dlutz52/lutzcraft-kicad-symbols/README.md

# lutzcraft-kicad-symbols
Where I keep my symbols and footprints used in KiCad
