dlutz52/lutzcraft-kicad-symbols/3dmodels/SRP4020TA-3R3M.step

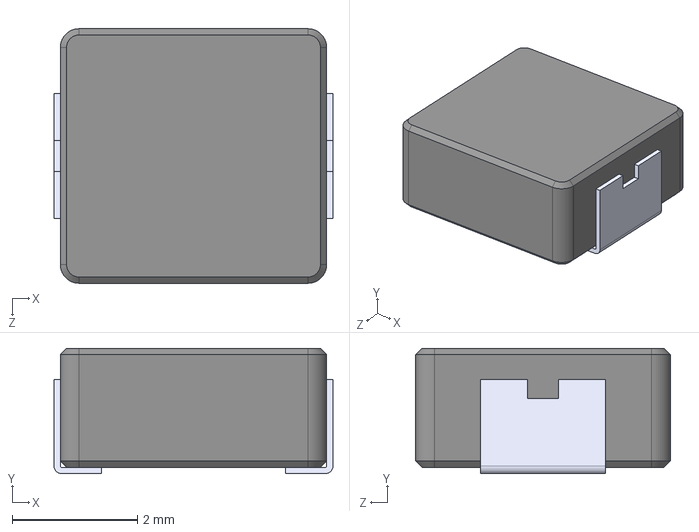
[picture p1: CAD file, 2026-05-27]
3dmodels/SRP4020TA-3R3M.step
4.45 x 2.00 x 4.06 mm
