dlutz52/lutzcraft-kicad-symbols/3dmodels/U262-161N-4BVC11.stp

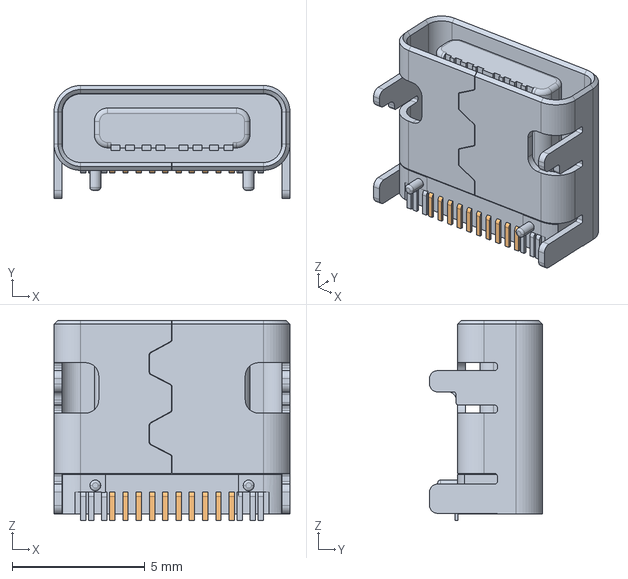
[picture p2: CAD file, 2026-05-27]
3dmodels/U262-161N-4BVC11.stp
8.90 x 4.26 x 7.56 mm
