dlutz52/lutzcraft-kicad-symbols/3dmodels/ESP32-WROOM-32E.STEP

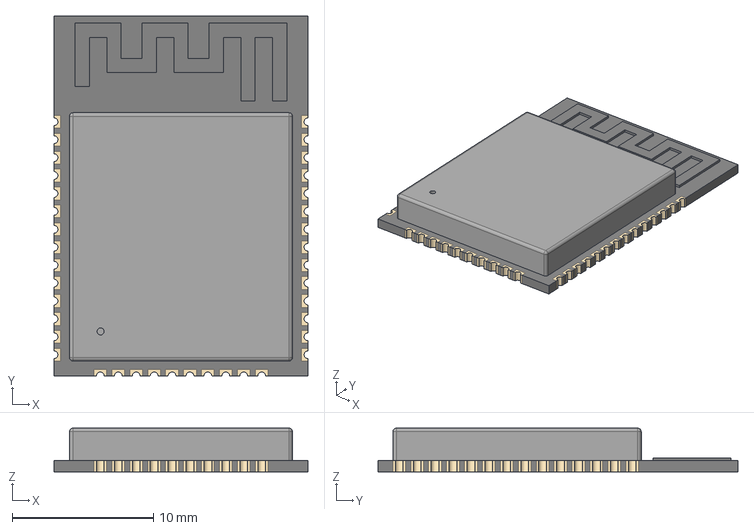
[picture p3: CAD file, 2026-02-02]
3dmodels/ESP32-WROOM-32E.STEP
18.0 x 25.5 x 3.10 mm
