dlutz52/lutzcraft-kicad-symbols/3dmodels/ESP32-WROOM-32U.step

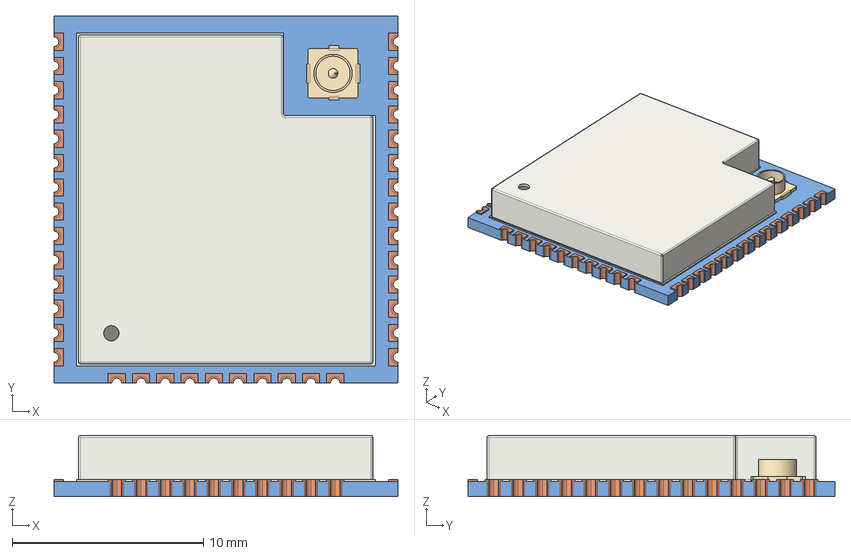
[picture p4: CAD file, 2026-02-02]
3dmodels/ESP32-WROOM-32U.step
18.0 x 19.2 x 3.20 mm
