dlutz52/lutzcraft-kicad-symbols/3dmodels/IS62WV51216BLL-55TLI_ISI.step

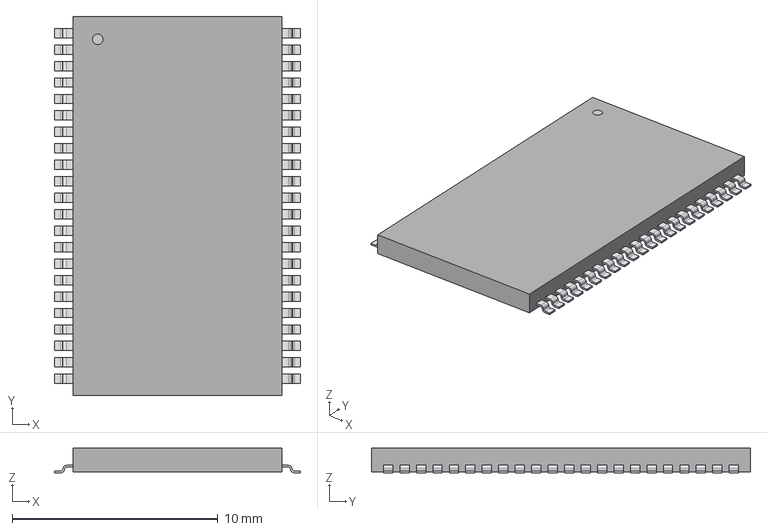
[picture p5: CAD file, 2026-01-31]
3dmodels/IS62WV51216BLL-55TLI_ISI.step
12.0 x 18.4 x 1.20 mm
