dlutz52/lutzcraft-kicad-symbols/3dmodels/DM3AT-SF-PEJM5.STEP

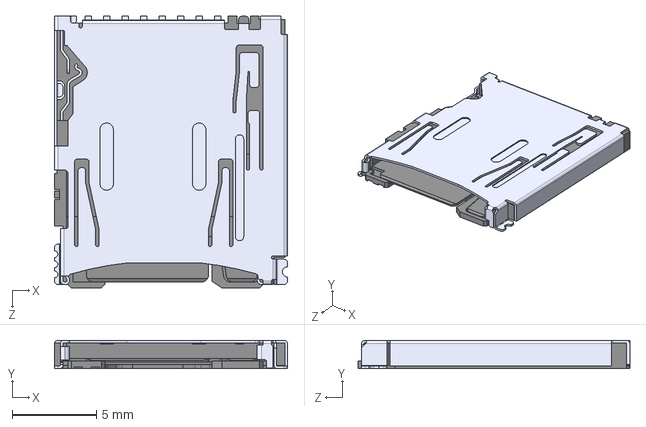
[picture p6: CAD file, 2026-01-31]
3dmodels/DM3AT-SF-PEJM5.STEP
13.8 x 1.68 x 16.2 mm
