dlutz52/lutzcraft-kicad-symbols/3dmodels/S8411-45R.step

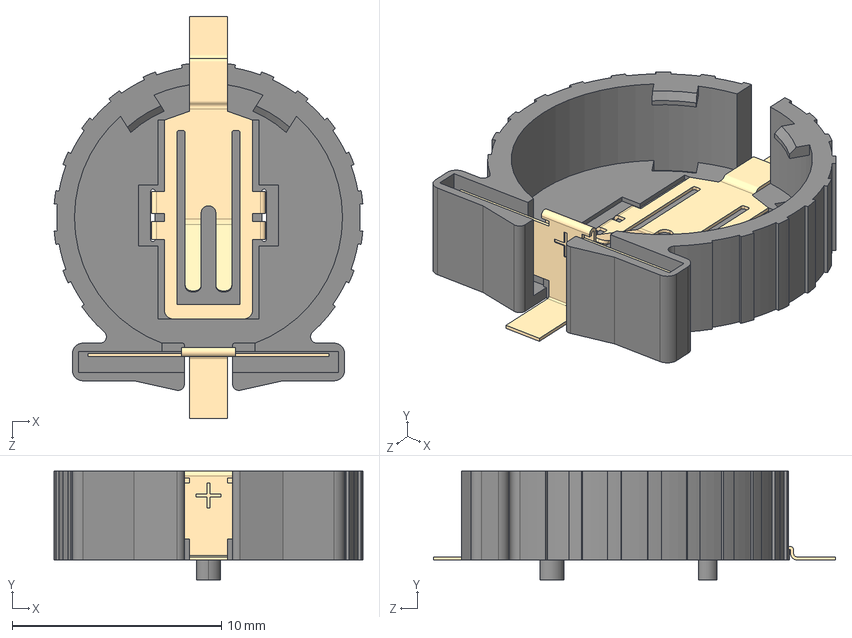
[picture p8: CAD file, 2026-01-31]
3dmodels/S8411-45R.step
14.7 x 5.20 x 19.2 mm
