dlutz52/lutzcraft-kicad-symbols/3dmodels/PinSocket_2x04_P2.54mm_Vertical.step

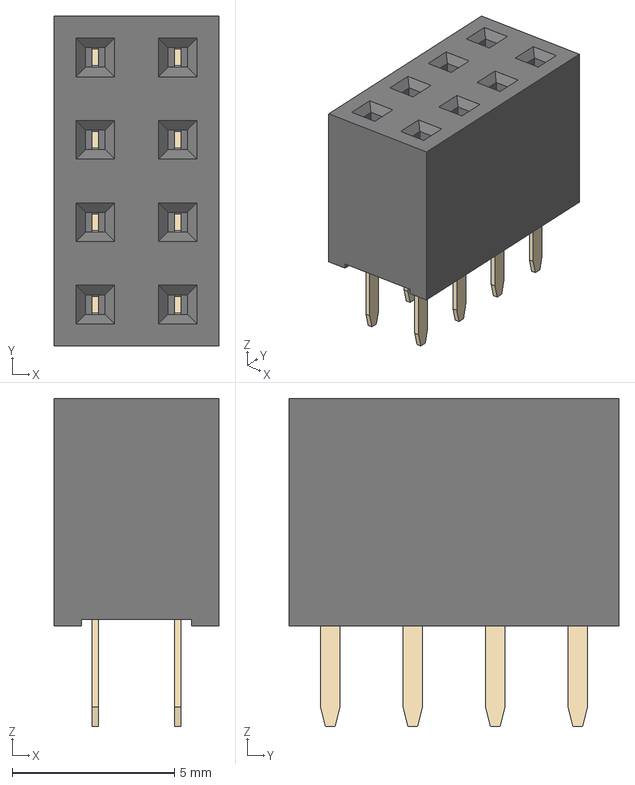
[picture p9: CAD file, 2026-01-31]
3dmodels/PinSocket_2x04_P2.54mm_Vertical.step
5.08 x 10.2 x 10.1 mm
