dlutz52/lutzcraft-kicad-symbols/3dmodels/STM32F407ZGT6.STEP

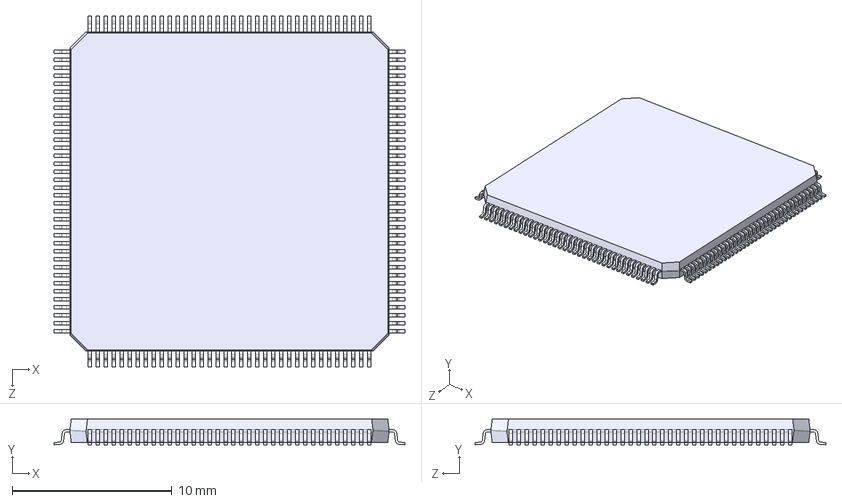
[picture p10: CAD file, 2026-01-31]
3dmodels/STM32F407ZGT6.STEP
22.0 x 1.60 x 22.0 mm
