dlutz52/lutzcraft-kicad-symbols/3dmodels/Wireless Radio Transmitter and Receiver nRF24L01.STEP

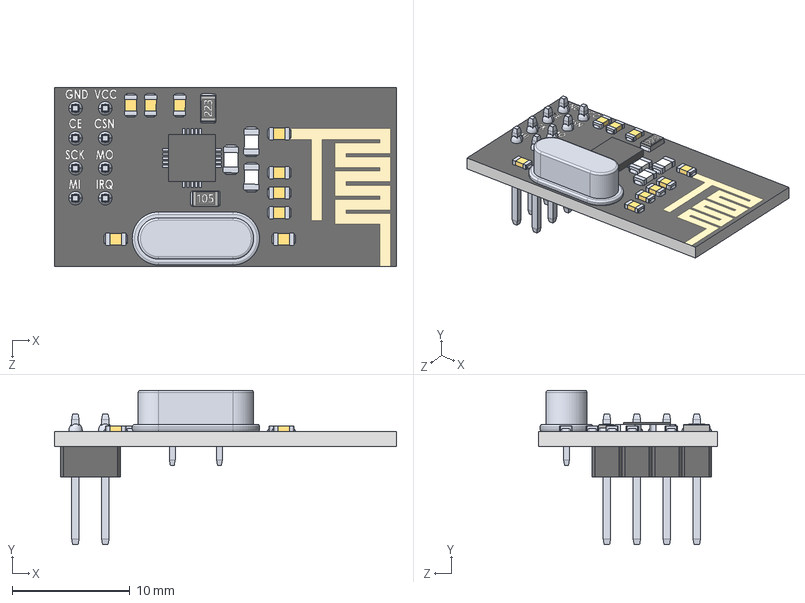
[picture p11: CAD file, 2026-01-31]
3dmodels/Wireless Radio Transmitter and Receiver nRF24L01.STEP
29.0 x 13.1 x 15.2 mm
nrfboard
CrystalOscillator
doubleMaleHeader x 4
solder x 8
1.7mmSmdCeramicCapacitor x 9
smdResistor223
smdResistor105
smdceramiccapacitorwhite x 3
4x4SMDchip
