dlutz52/lutzcraft-kicad-symbols/3dmodels/ABM8AIG-8.000MHZ-1Z-T.step

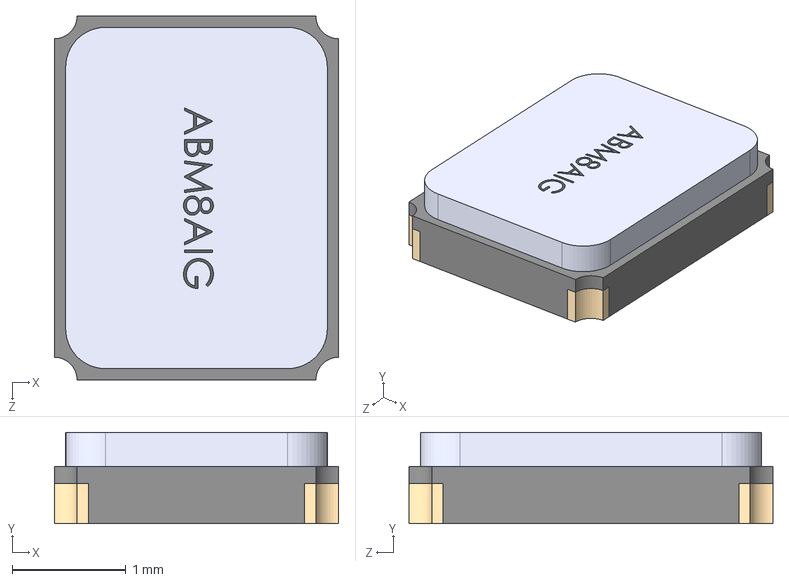
[picture p12: CAD file, 2026-01-31]
3dmodels/ABM8AIG-8.000MHZ-1Z-T.step
2.50 x 0.801 x 3.20 mm
