dlutz52/lutzcraft-kicad-symbols/3dmodels/8M20P2_49US.stp

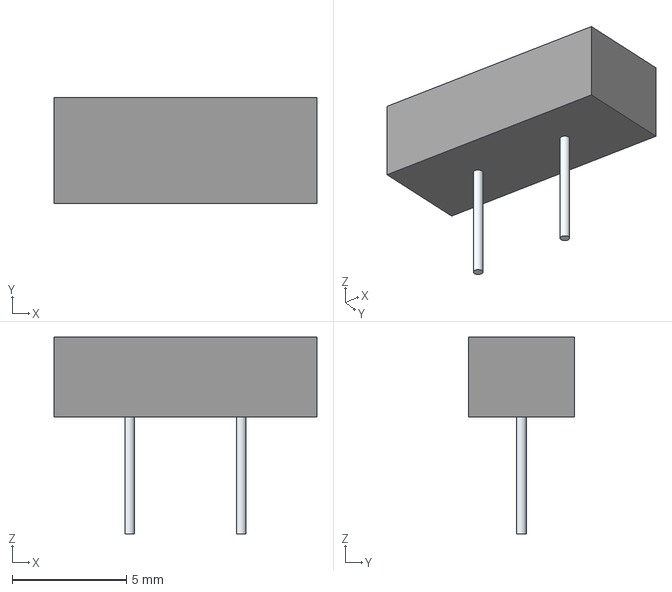
[picture p13: CAD file, 2026-01-31]
3dmodels/8M20P2_49US.stp
11.5 x 4.65 x 8.60 mm
Leads
