dlutz52/lutzcraft-kicad-symbols/3dmodels/USB_C_Receptacle_HRO_TYPE-C-31-M-12.STEP

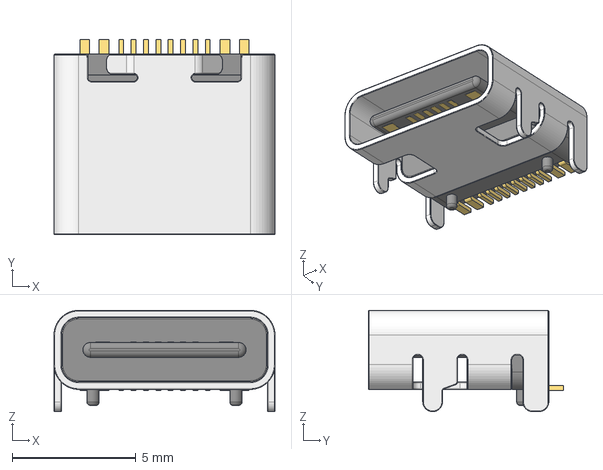
[picture p14: CAD file, 2026-01-31]
3dmodels/USB_C_Receptacle_HRO_TYPE-C-31-M-12.STEP
8.94 x 7.90 x 4.10 mm
