dlutz52/lutzcraft-kicad-symbols/3dmodels/TB002-500-03BE.step

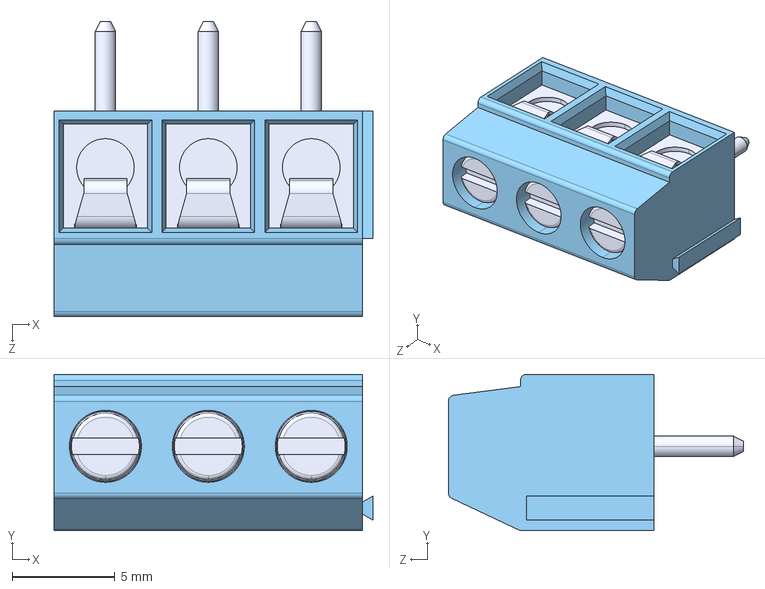
[picture p15: CAD file, 2025-12-26]
3dmodels/TB002-500-03BE.step
15.5 x 7.60 x 14.4 mm
