dlutz52/lutzcraft-kicad-symbols/3dmodels/IST8310.step

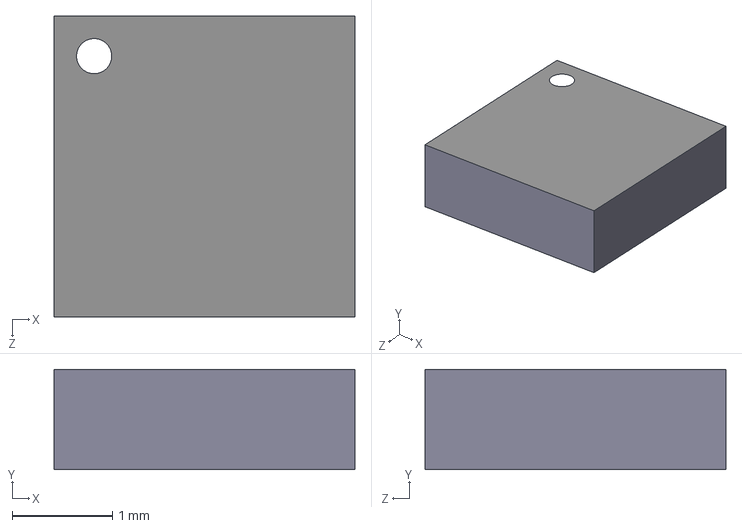
[picture p16: CAD file, 2025-11-05]
3dmodels/IST8310.step
3.00 x 1.00 x 3.00 mm
