dlutz52/lutzcraft-kicad-symbols/3dmodels/BMI270_BOS.step

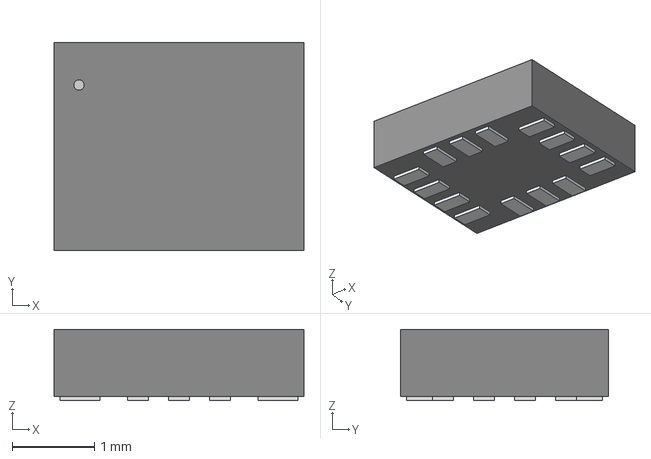
[picture p17: CAD file, 2025-10-31]
3dmodels/BMI270_BOS.step
3.05 x 2.54 x 0.866 mm
