dlutz52/lutzcraft-kicad-symbols/3dmodels/LGA20_2p5X3X0p95_BOS.step

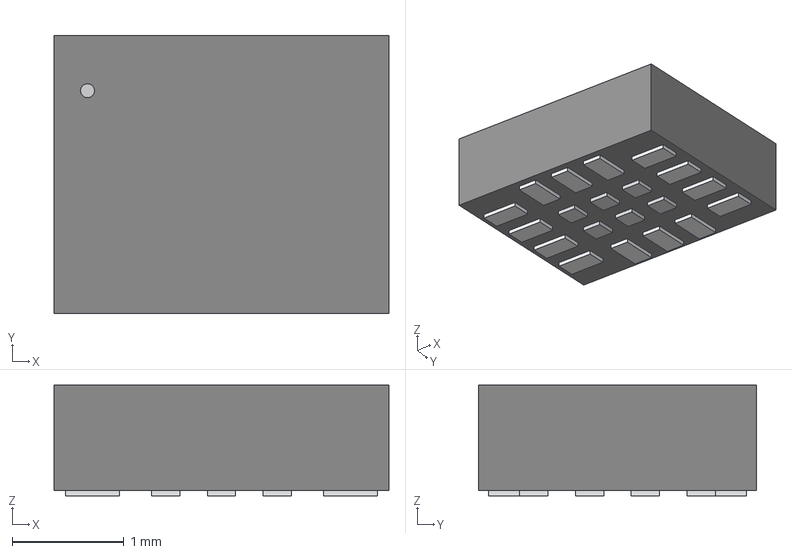
[picture p18: CAD file, 2025-10-31]
3dmodels/LGA20_2p5X3X0p95_BOS.step
3.00 x 2.49 x 0.993 mm
