dlutz52/lutzcraft-kicad-symbols/3dmodels/BGA9_BMM350_BOS.step

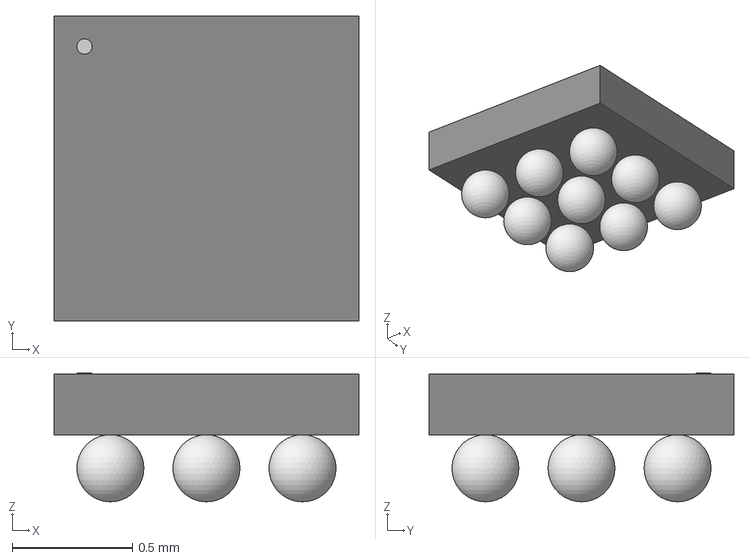
[picture p19: CAD file, 2025-10-31]
3dmodels/BGA9_BMM350_BOS.step
1.27 x 1.27 x 0.536 mm
