dlutz52/lutzcraft-kicad-symbols/3dmodels/BMI088.STEP

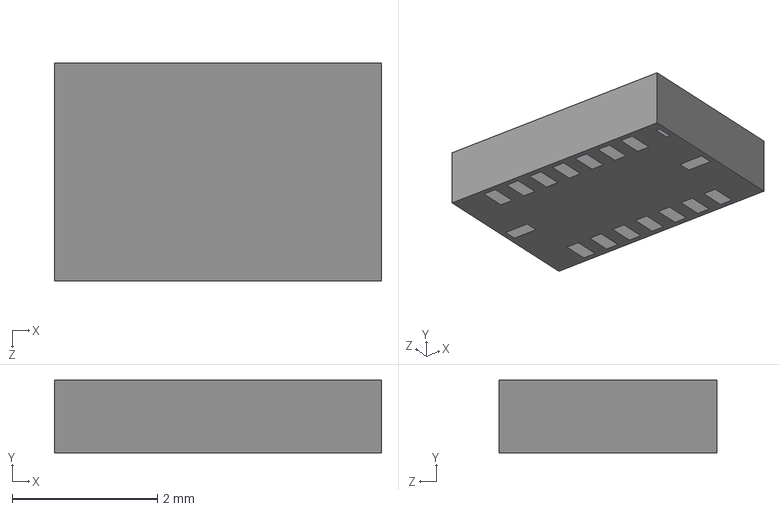
[picture p20: CAD file, 2025-10-31]
3dmodels/BMI088.STEP
4.50 x 1.00 x 3.00 mm
