dlutz52/lutzcraft-kicad-symbols/3dmodels/BNO085.step

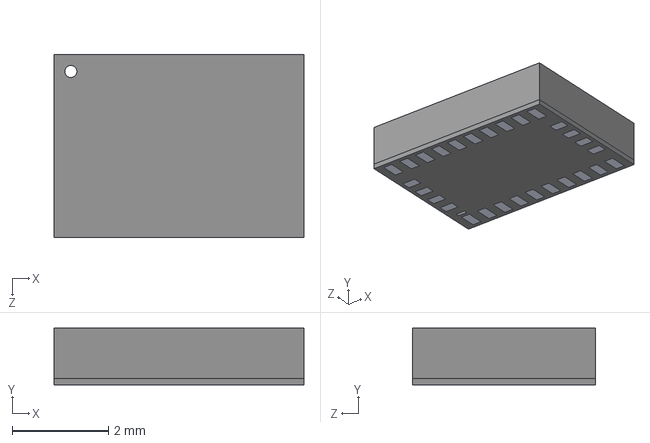
[picture p21: CAD file, 2025-10-31]
3dmodels/BNO085.step
5.20 x 1.18 x 3.80 mm
