dlutz52/lutzcraft-kicad-symbols/3dmodels/QFN24_3X3X0P9_IVS.step

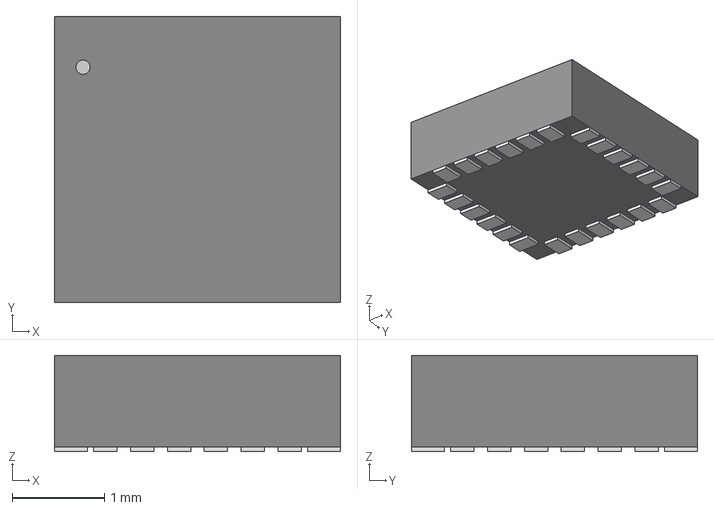
[picture p22: CAD file, 2025-10-31]
3dmodels/QFN24_3X3X0P9_IVS.step
3.10 x 3.10 x 1.04 mm
