dlutz52/lutzcraft-kicad-symbols/3dmodels/ICM-20948.step

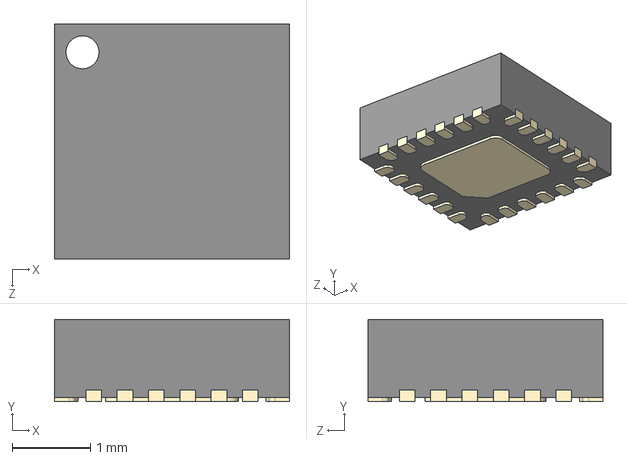
[picture p23: CAD file, 2025-10-31]
3dmodels/ICM-20948.step
3.00 x 1.05 x 3.00 mm
