dlutz52/lutzcraft-kicad-symbols/3dmodels/BMI270.STEP

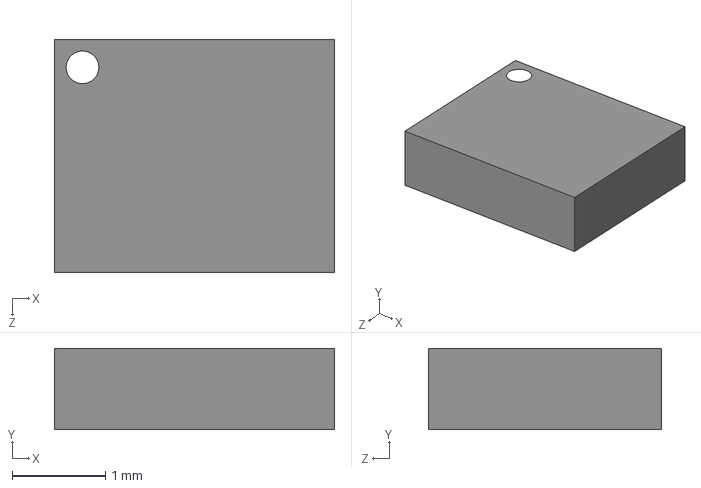
[picture p24: CAD file, 2025-10-31]
3dmodels/BMI270.STEP
3.00 x 0.87 x 2.50 mm
