dlutz52/lutzcraft-kicad-symbols/3dmodels/TB002-500-02BE.step

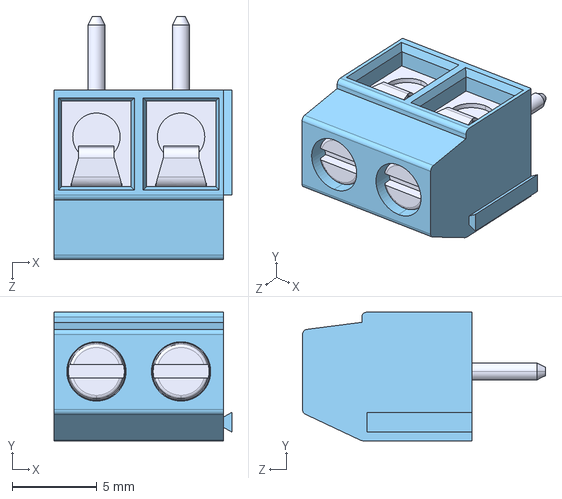
[picture p25: CAD file, 2025-10-18]
3dmodels/TB002-500-02BE.step
10.5 x 7.60 x 14.4 mm
