dlutz52/lutzcraft-kicad-symbols/3dmodels/User Library-DS1040-03 (DIP_switch).STEP

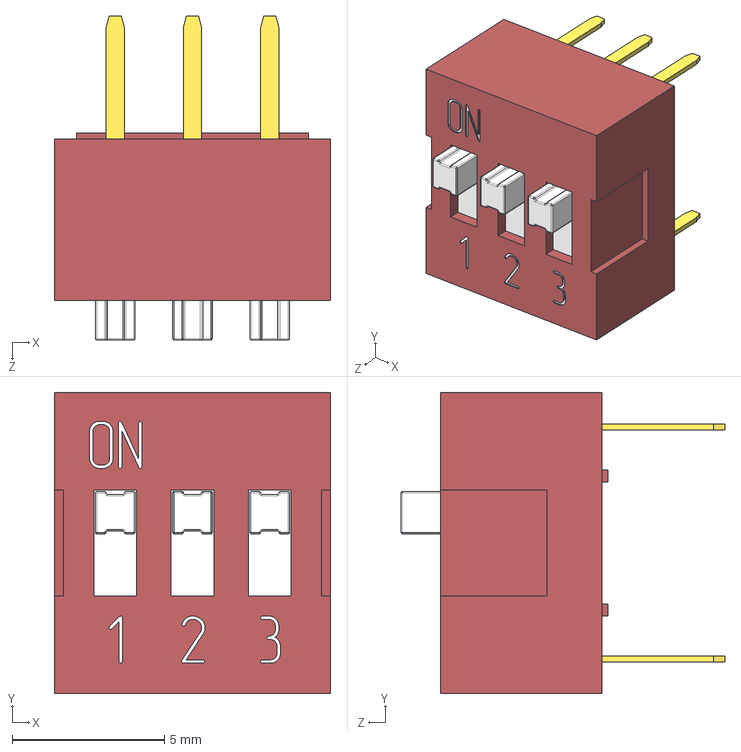
[picture p26: CAD file, 2025-10-08]
3dmodels/User Library-DS1040-03 (DIP_switch).STEP
9.08 x 9.90 x 10.7 mm
