dlutz52/lutzcraft-kicad-symbols/3dmodels/208-3.STEP

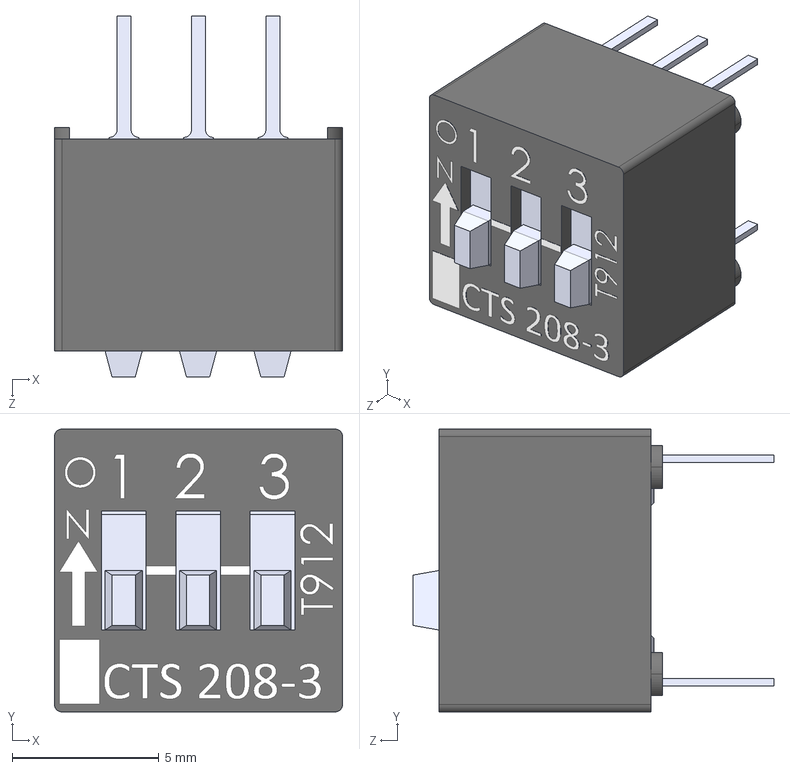
[picture p27: CAD file, 2025-10-08]
3dmodels/208-3.STEP
9.83 x 9.65 x 12.3 mm
206-40-063-40-01(for 208-3)
206-3 pole assembly
