dlutz52/lutzcraft-kicad-symbols/3dmodels/SOT-23-3.step

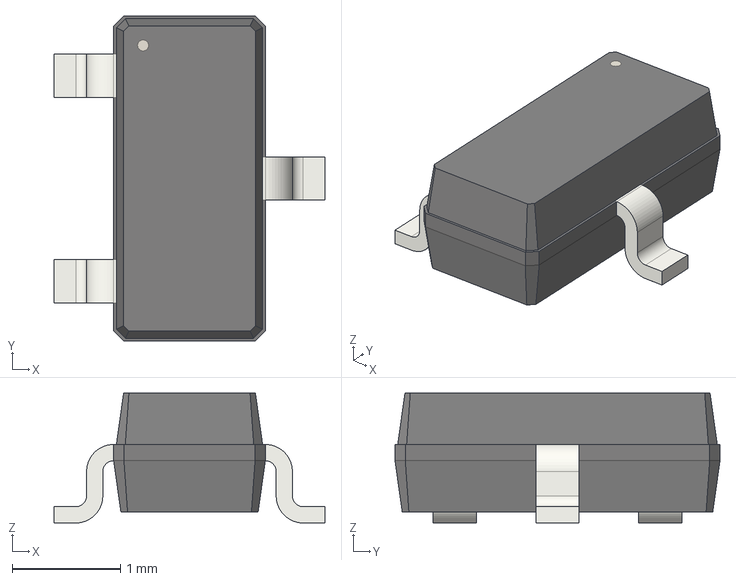
[picture p28: CAD file, 2025-07-09]
3dmodels/SOT-23-3.step
2.50 x 3.00 x 1.20 mm
