dlutz52/lutzcraft-kicad-symbols/3dmodels/W25Q32JVSSIQ.step

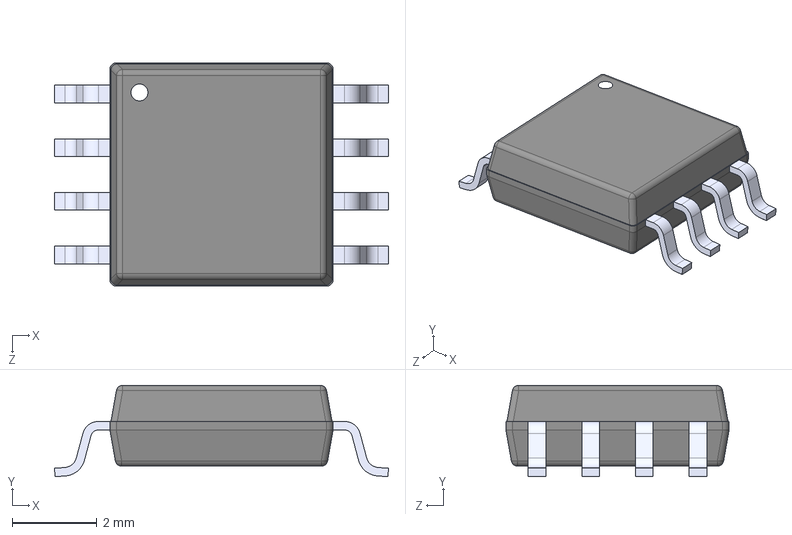
[picture p29: CAD file, 2025-07-09]
3dmodels/W25Q32JVSSIQ.step
7.90 x 2.16 x 5.28 mm
