dlutz52/lutzcraft-kicad-symbols/3dmodels/BME280.step

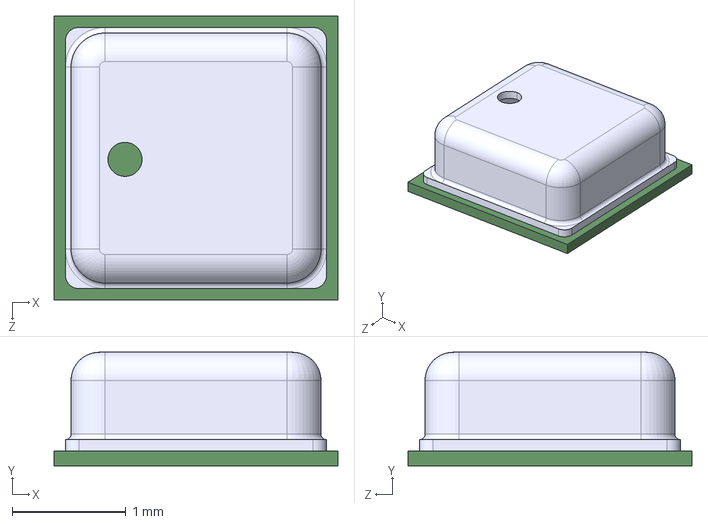
[picture p30: CAD file, 2025-07-09]
3dmodels/BME280.step
2.50 x 1.00 x 2.50 mm
