dlutz52/lutzcraft-kicad-symbols/3dmodels/B2B-PH-SM4-TB.step

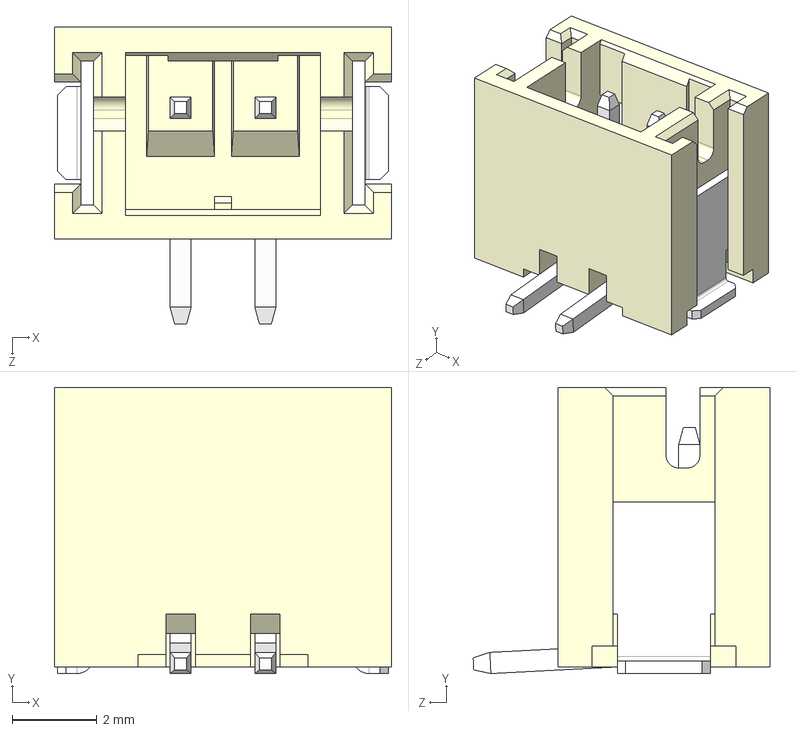
[picture p31: CAD file, 2025-07-09]
3dmodels/B2B-PH-SM4-TB.step
7.95 x 6.75 x 7.00 mm
