dlutz52/lutzcraft-kicad-symbols/3dmodels/LM1117MPX-3.3.step

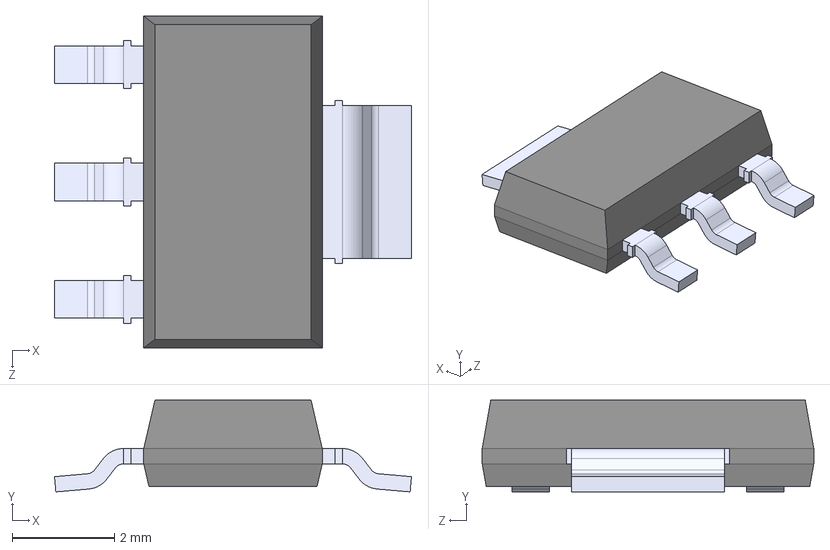
[picture p32: CAD file, 2025-07-09]
3dmodels/LM1117MPX-3.3.step
7.00 x 1.80 x 6.50 mm
