dlutz52/lutzcraft-kicad-symbols/3dmodels/B4B-XH-AM__LF__SN_.step

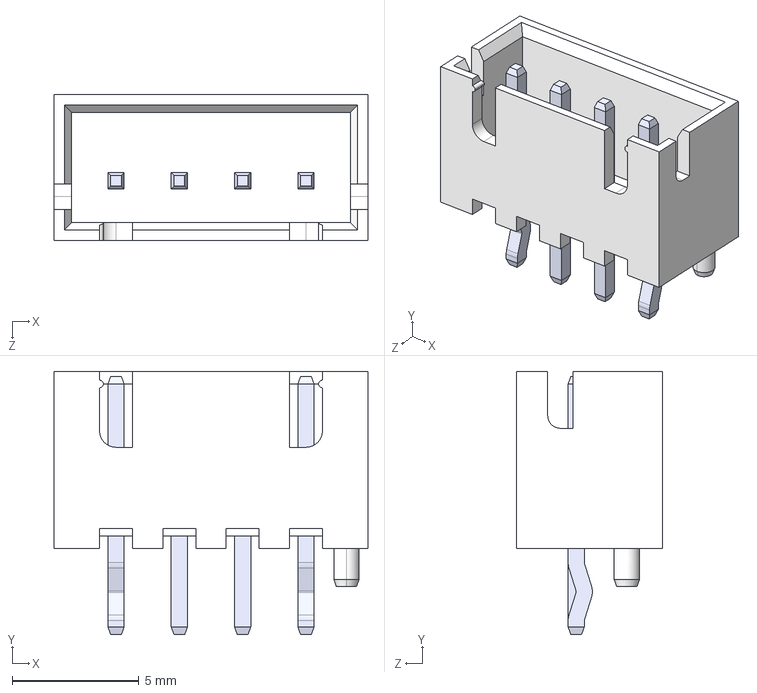
[picture p33: CAD file, 2025-07-09]
3dmodels/B4B-XH-AM__LF__SN_.step
12.4 x 10.4 x 5.75 mm
