dlutz52/lutzcraft-kicad-symbols/3dmodels/0ZCH0110AF2E.stp

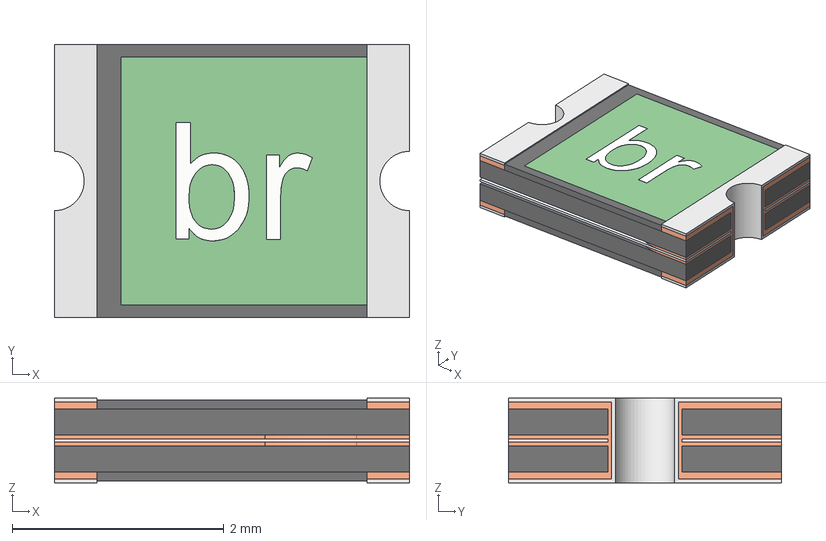
[picture p34: CAD file, 2025-07-09]
3dmodels/0ZCH0110AF2E.stp
3.35 x 2.58 x 0.8 mm
0ZCH0110AF2E_PART1
0ZCH0110AF2E_PART2
0ZCH0110AF2E_PART3
0ZCH0110AF2E_PART4
0ZCH0110AF2E_PART5
0ZCH0110AF2E_PART6
0ZCH0110AF2E_PART7
0ZCH0110AF2E_PART8
0ZCH0110AF2E_PART9
0ZCH0110AF2E_PART10
0ZCH0110AF2E_PART11
0ZCH0110AF2E_PART12
0ZCH0110AF2E_PART13
0ZCH0110AF2E_PART14
0ZCH0110AF2E_PART15
