dlutz52/lutzcraft-kicad-symbols/3dmodels/SS-52400-002.step

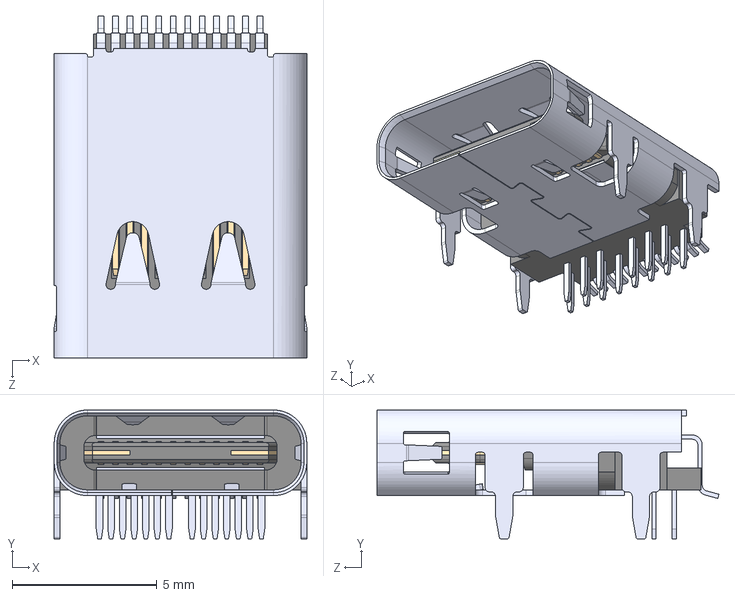
[picture p35: CAD file, 2025-07-09]
3dmodels/SS-52400-002.step
8.74 x 4.46 x 11.8 mm
