dlutz52/lutzcraft-kicad-symbols/3dmodels/TEMT6000X01.step

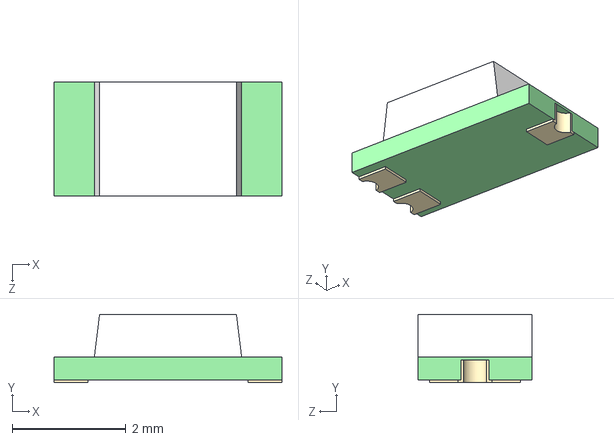
[picture p36: CAD file, 2025-07-09]
3dmodels/TEMT6000X01.step
4.00 x 1.20 x 2.00 mm
