dlutz52/lutzcraft-kicad-symbols/3dmodels/ESP32-C3-WROOM-02-H4.step

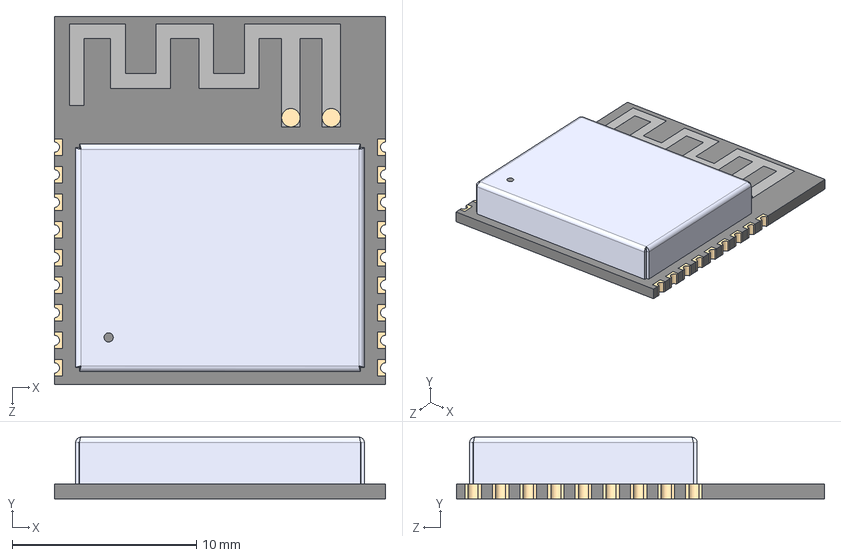
[picture p37: CAD file, 2025-07-09]
3dmodels/ESP32-C3-WROOM-02-H4.step
18.0 x 3.35 x 20.0 mm
