dlutz52/lutzcraft-kicad-symbols/3dmodels/USLPT2819DT2TR.STEP

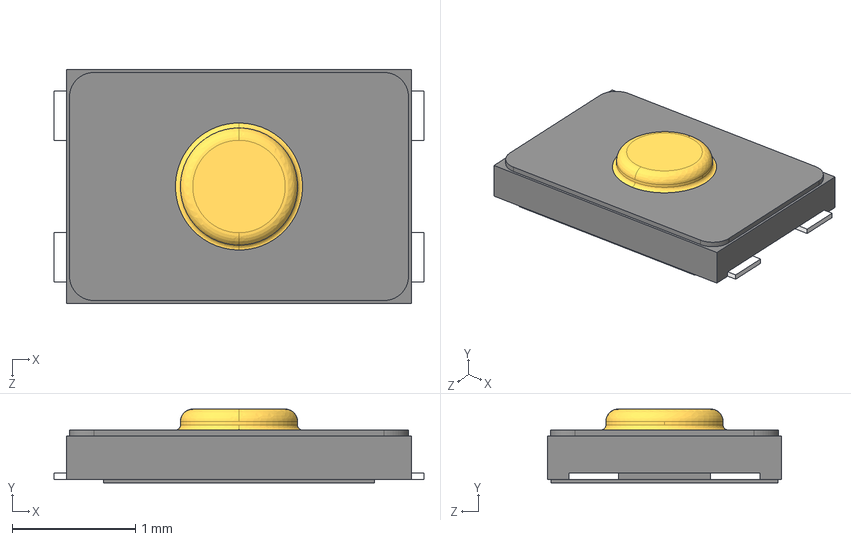
[picture p38: CAD file, 2025-07-09]
3dmodels/USLPT2819DT2TR.STEP
3.00 x 0.6 x 1.90 mm
