dlutz52/lutzcraft-kicad-symbols/3dmodels/CP2102N-A02-GQFN20.STEP

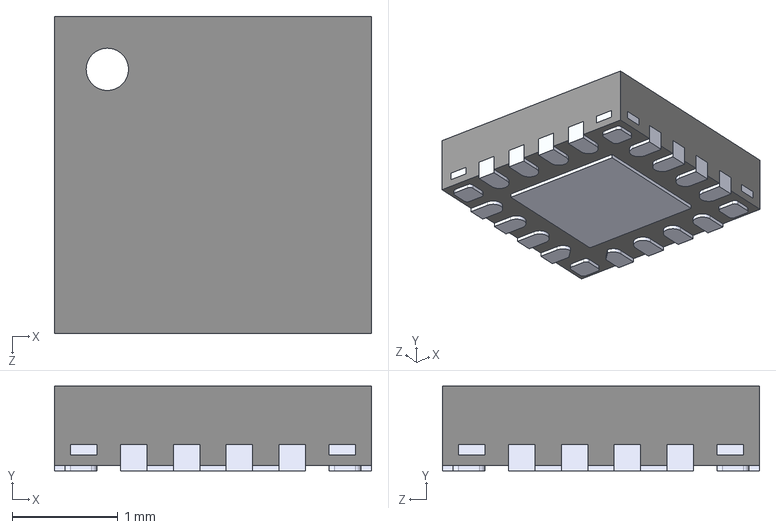
[picture p39: CAD file, 2025-07-09]
3dmodels/CP2102N-A02-GQFN20.STEP
3.00 x 0.8 x 3.00 mm
