dlutz52/lutzcraft-kicad-symbols/3dmodels/LTST-C170KRKT.step

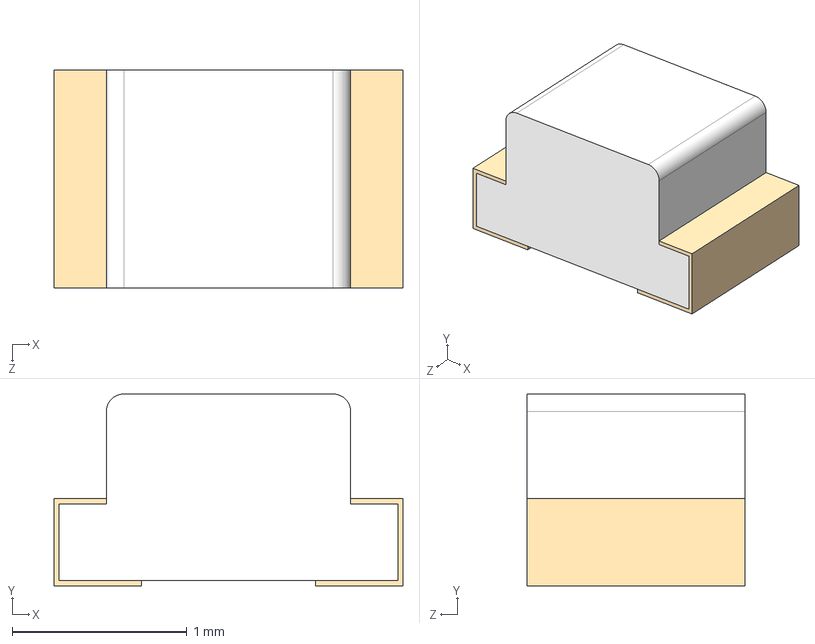
[picture p40: CAD file, 2025-07-09]
3dmodels/LTST-C170KRKT.step
2.00 x 1.10 x 1.25 mm
