dlutz52/lutzcraft-kicad-symbols/3dmodels/SOT-23-6.step

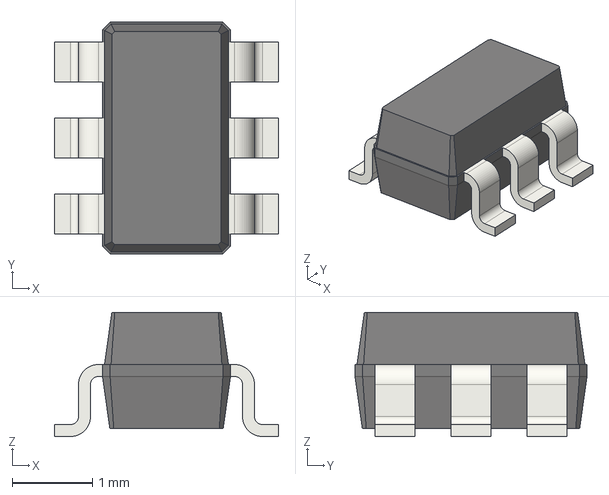
[picture p41: CAD file, 2025-07-09]
3dmodels/SOT-23-6.step
2.80 x 2.90 x 1.55 mm
