dlutz52/lutzcraft-kicad-symbols/3dmodels/T491A106K010AT7280.step

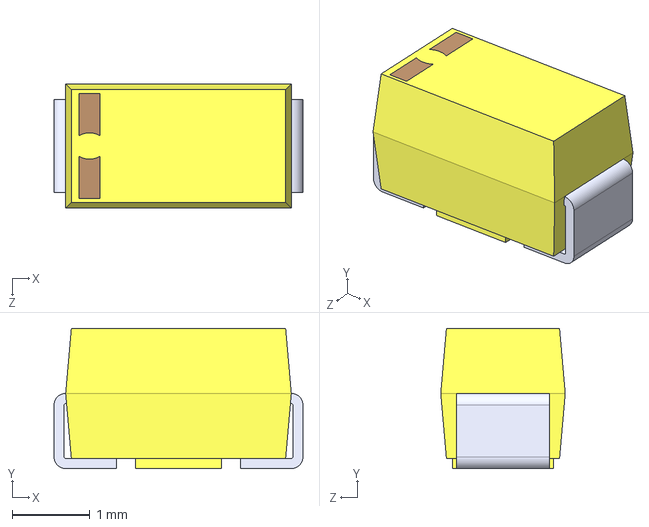
[picture p42: CAD file, 2025-07-09]
3dmodels/T491A106K010AT7280.step
3.20 x 1.80 x 1.60 mm
