dlutz52/lutzcraft-kicad-symbols/3dmodels/MAX4466EXK.step

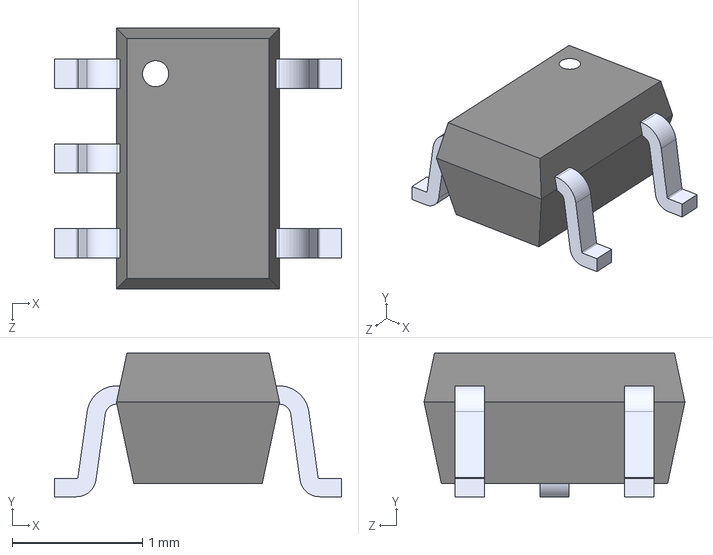
[picture p43: CAD file, 2025-07-09]
3dmodels/MAX4466EXK.step
2.20 x 1.10 x 2.00 mm
