dlutz52/lutzcraft-kicad-symbols/3dmodels/TL3305AF260QG.step

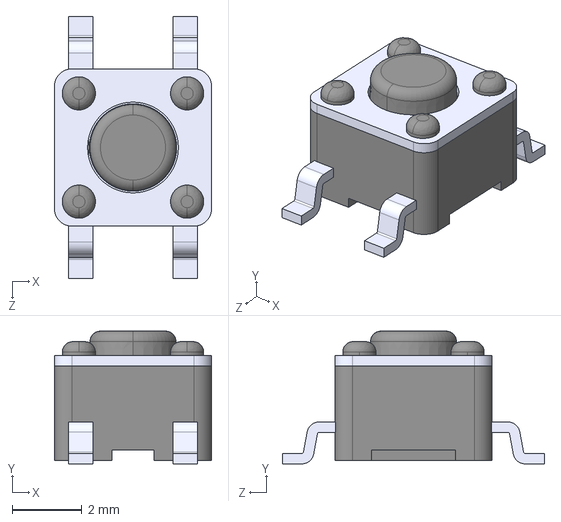
[picture p44: CAD file, 2025-07-09]
3dmodels/TL3305AF260QG.step
4.50 x 3.80 x 7.50 mm
