dlutz52/lutzcraft-kicad-symbols/3dmodels/35WR100KLFTR.stp

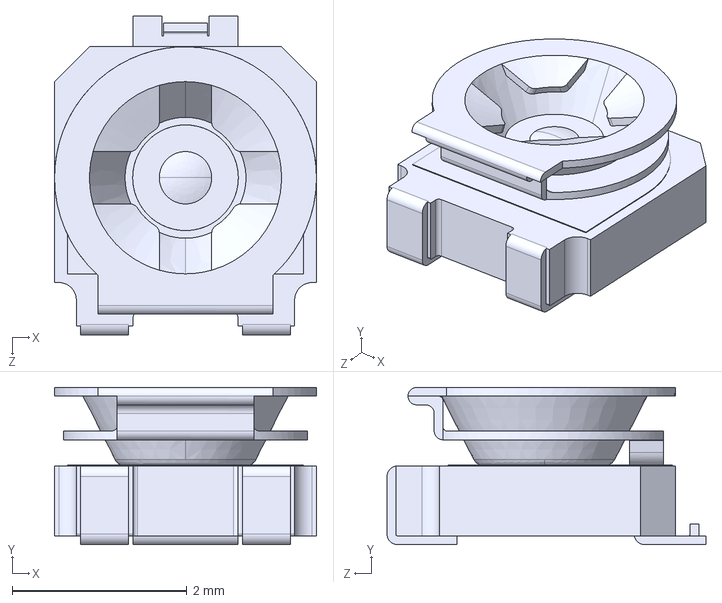
[picture p45: CAD file, 2025-07-09]
3dmodels/35WR100KLFTR.stp
3.00 x 1.80 x 3.65 mm
