dlutz52/lutzcraft-kicad-symbols/3dmodels/FBMJ2125HM330-T.step

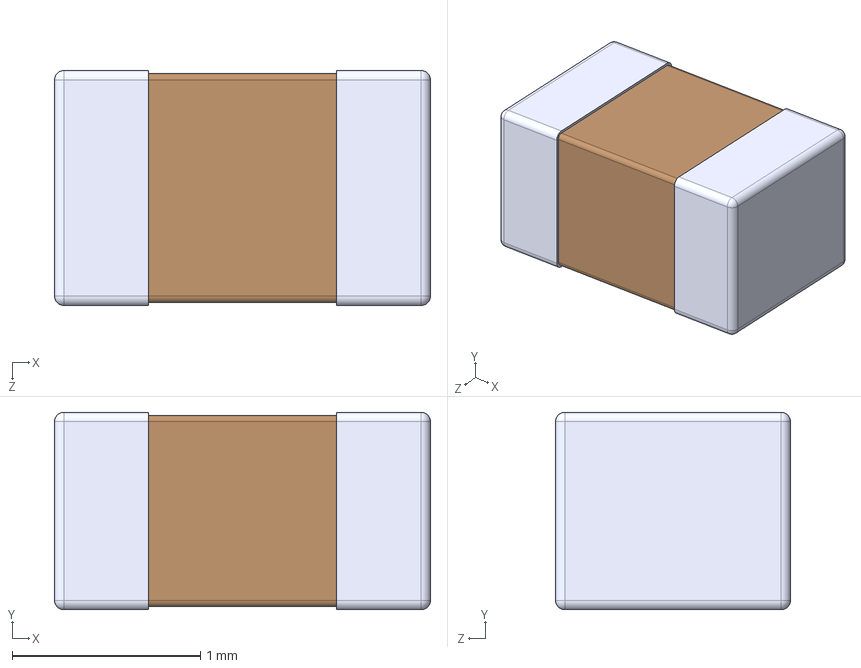
[picture p46: CAD file, 2025-07-09]
3dmodels/FBMJ2125HM330-T.step
2.00 x 1.05 x 1.25 mm
