dlutz52/lutzcraft-kicad-symbols/3dmodels/SSOP-28_FTD.step

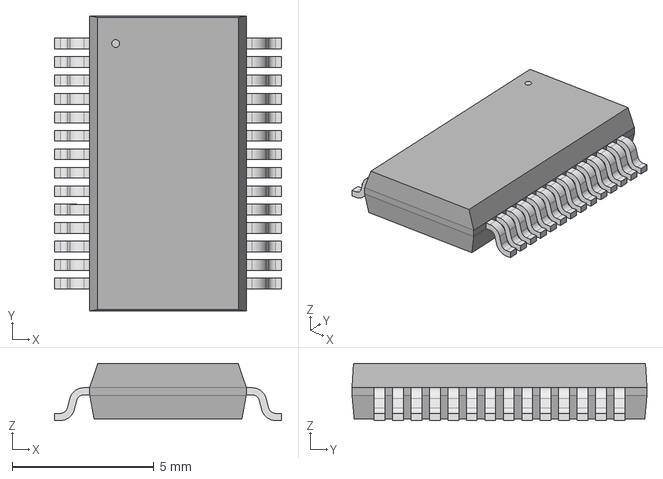
[picture p47: CAD file, 2025-05-11]
3dmodels/SSOP-28_FTD.step
8.00 x 10.4 x 2.01 mm
