dlutz52/lutzcraft-kicad-symbols/3dmodels/LQFP64-10x10mm.step

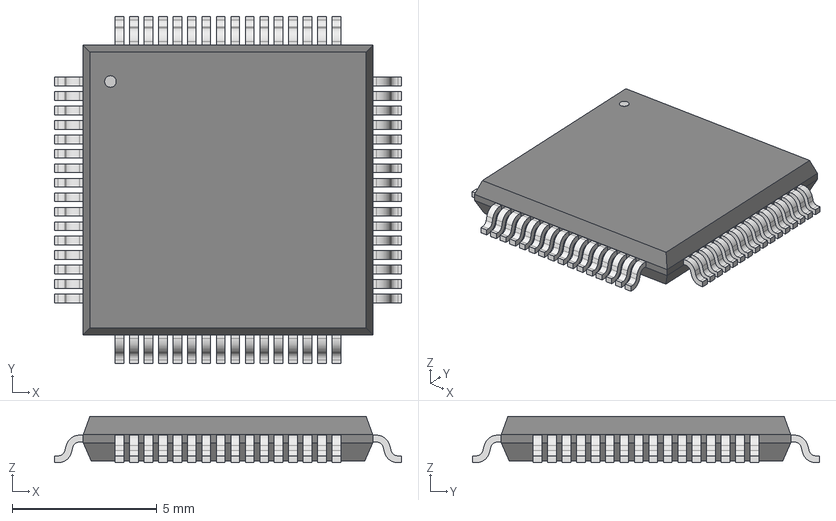
[picture p48: CAD file, 2025-05-11]
3dmodels/LQFP64-10x10mm.step
12.0 x 12.0 x 1.60 mm
