dlutz52/lutzcraft-kicad-symbols/3dmodels/DG306-5.0-03P-12-00AH.STEP

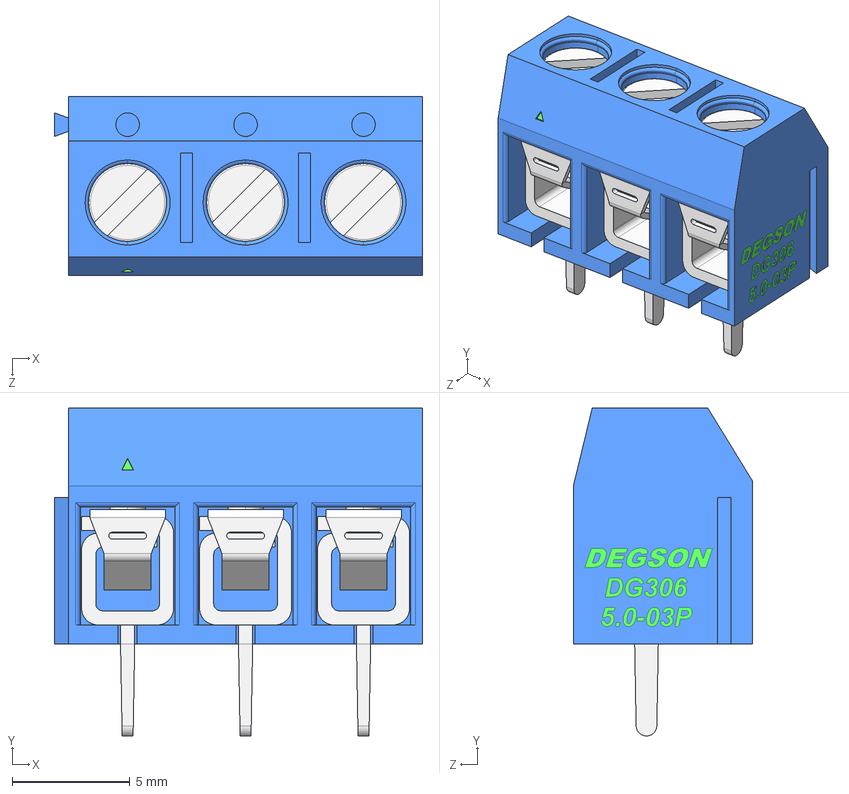
[picture p51: CAD file, 2025-05-11]
3dmodels/DG306-5.0-03P-12-00AH.STEP
15.6 x 13.9 x 7.60 mm
