dlutz52/lutzcraft-kicad-symbols/3dmodels/ESP32-S3-DEVKITC-1-N8R2--3DModel-STEP-56544.STEP

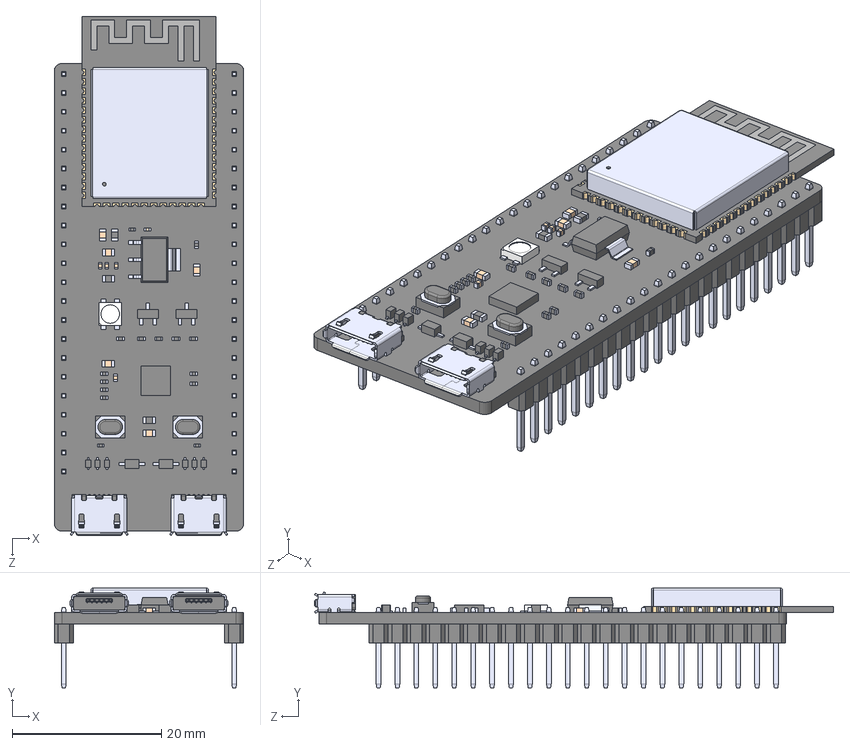
[picture p52: CAD file, 2025-05-11]
3dmodels/ESP32-S3-DEVKITC-1-N8R2--3DModel-STEP-56544.STEP
25.4 x 13.4 x 69.6 mm
