dlutz52/lutzcraft-kicad-symbols/3dmodels/STM32F030R8T6.step

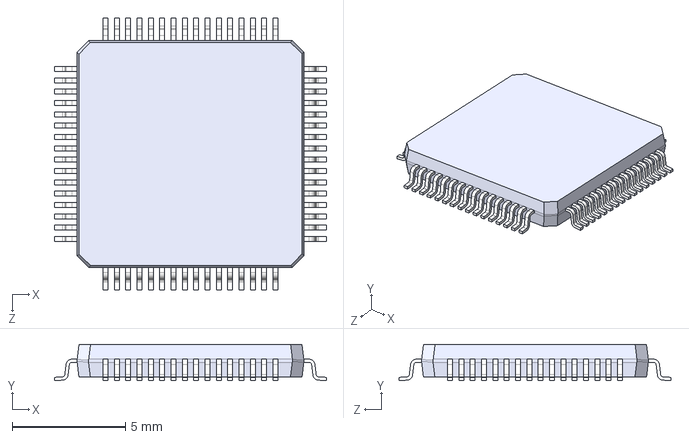
[picture p53: CAD file, 2025-05-11]
3dmodels/STM32F030R8T6.step
12.0 x 1.60 x 12.0 mm
