dlutz52/lutzcraft-kicad-symbols/3dmodels/AT45DB161E-SHD-T.step

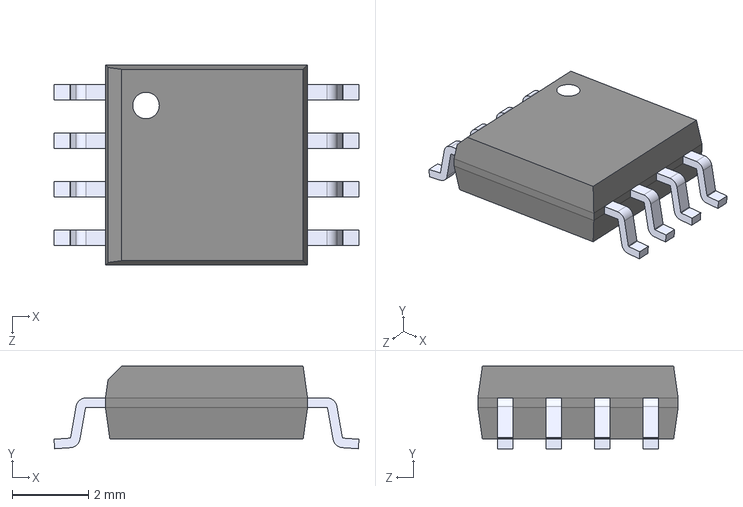
[picture p54: CAD file, 2024-10-31]
3dmodels/AT45DB161E-SHD-T.step
7.98 x 2.16 x 5.24 mm
