dlutz52/lutzcraft-kicad-symbols/3dmodels/AT45DB081E-SSHNHC-T.step

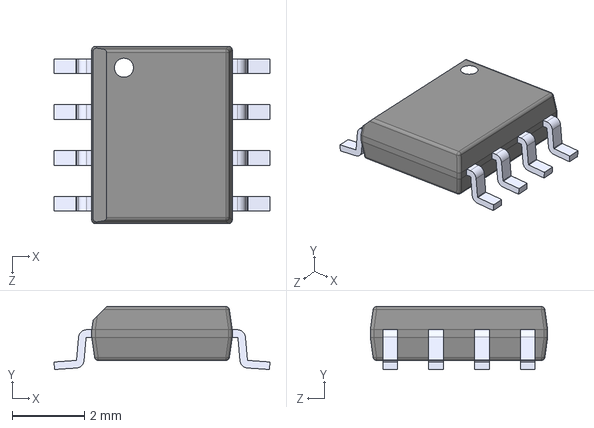
[picture p55: CAD file, 2024-10-31]
3dmodels/AT45DB081E-SSHNHC-T.step
6.00 x 1.75 x 4.93 mm
