dlutz52/lutzcraft-kicad-symbols/3dmodels/ProS3.STEP

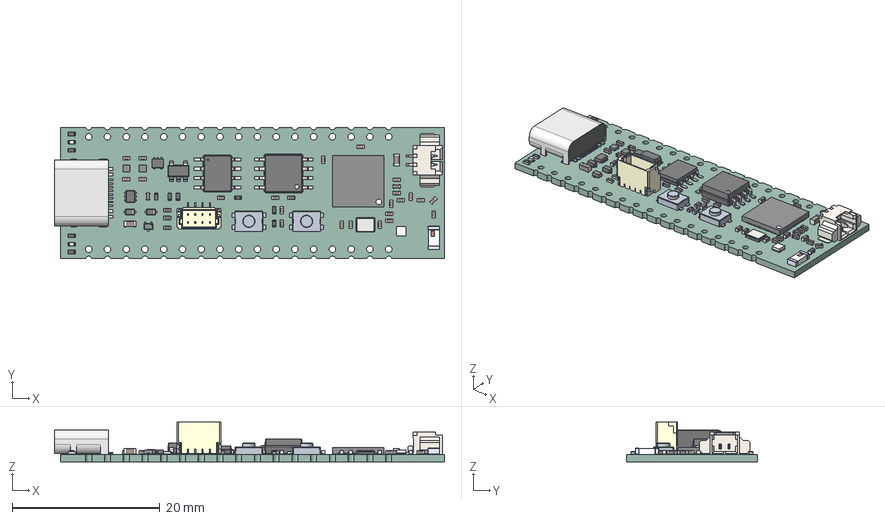
[picture p56: CAD file, 2024-10-22]
3dmodels/ProS3.STEP
52.8 x 17.8 x 5.38 mm
ProS3_STEP_MAKER PCB
