dlutz52/lutzcraft-kicad-symbols/3dmodels/CP2102N-A02-GQFN28.step

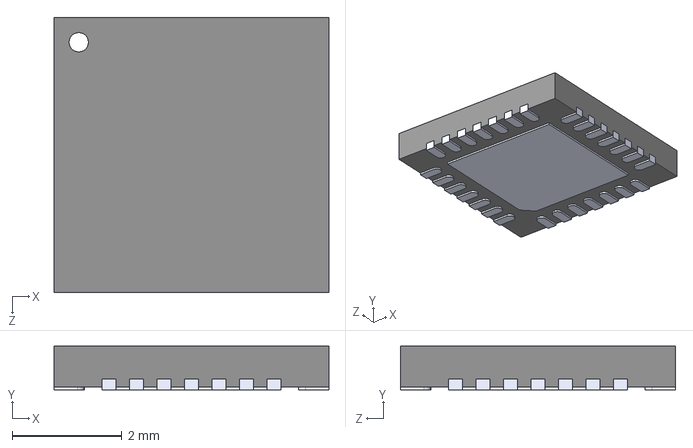
[picture p57: CAD file, 2024-10-22]
3dmodels/CP2102N-A02-GQFN28.step
5.00 x 0.8 x 5.00 mm
