dlutz52/lutzcraft-kicad-symbols/3dmodels/TSM-103-01-L-SV.step

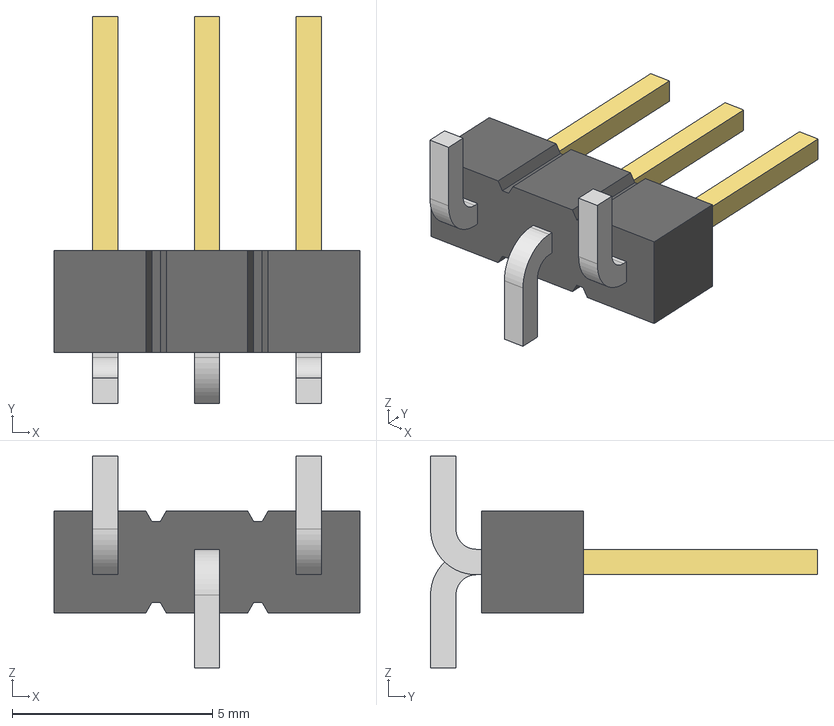
[picture p58: CAD file, 2024-10-22]
3dmodels/TSM-103-01-L-SV.step
7.62 x 9.65 x 5.28 mm
TSM-103-01-SV_body
T-1S6-16-L(-01-3-SV)
T-1S6-16-L(-01-3-SV)2
