dlutz52/lutzcraft-kicad-symbols/3dmodels/SS14.step

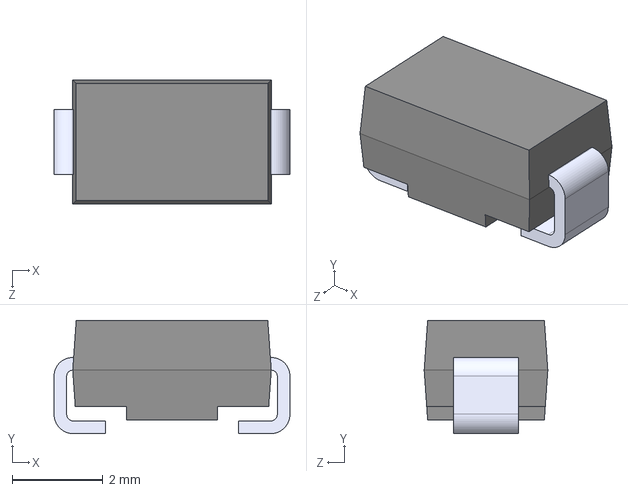
[picture p59: CAD file, 2024-10-22]
3dmodels/SS14.step
5.20 x 2.50 x 2.72 mm
