dlutz52/lutzcraft-kicad-symbols/3dmodels/DS3231SN_.step

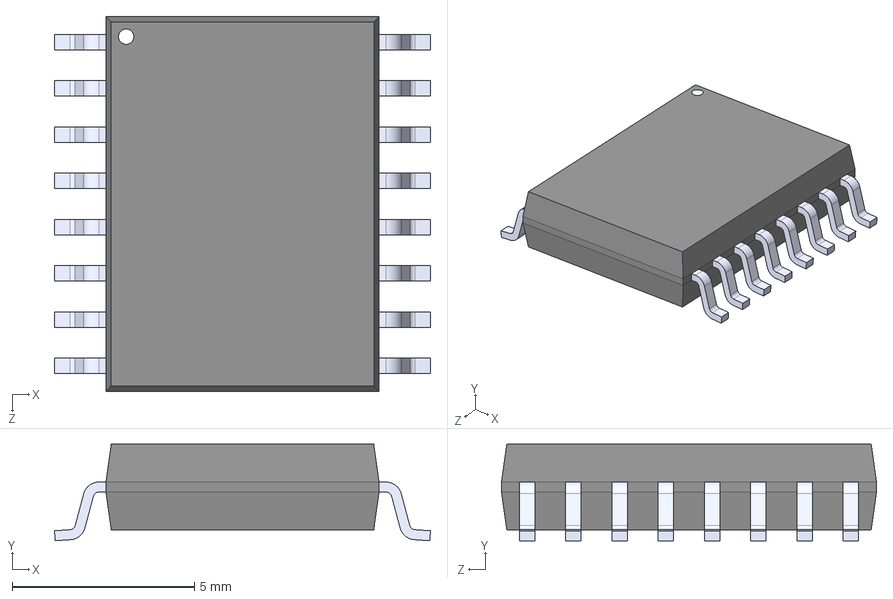
[picture p60: CAD file, 2024-10-22]
3dmodels/DS3231SN_.step
10.3 x 2.65 x 10.3 mm
