dlutz52/lutzcraft-kicad-symbols/3dmodels/TO252-2-3_3V_DIO.step

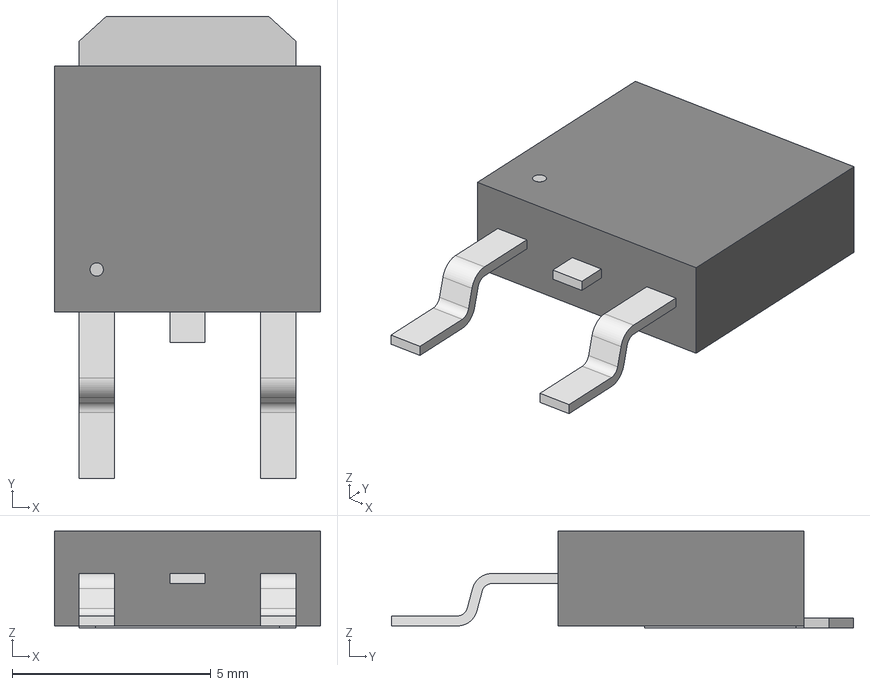
[picture p61: CAD file, 2024-10-22]
3dmodels/TO252-2-3_3V_DIO.step
6.71 x 11.6 x 2.44 mm
