dlutz52/lutzcraft-kicad-symbols/3dmodels/DS3234S.step

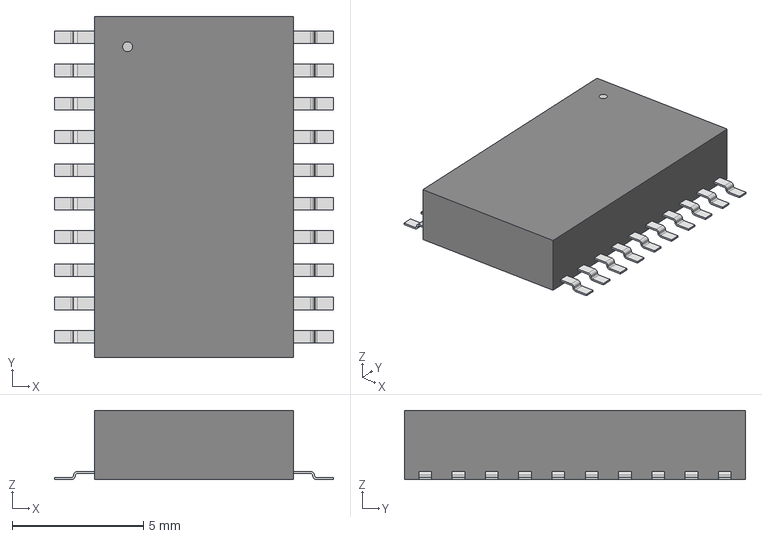
[picture p62: CAD file, 2024-10-22]
3dmodels/DS3234S.step
10.6 x 13.0 x 2.64 mm
