dlutz52/lutzcraft-kicad-symbols/3dmodels/XC6220B331PR.step

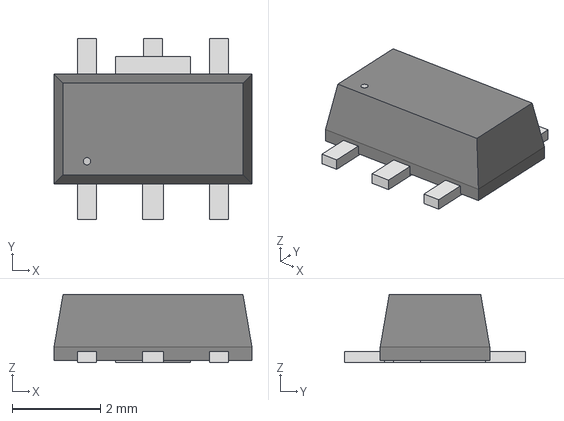
[picture p63: CAD file, 2024-10-22]
3dmodels/XC6220B331PR.step
4.50 x 4.11 x 1.55 mm
