dlutz52/lutzcraft-kicad-symbols/3dmodels/FTR-102-02-S-S.step

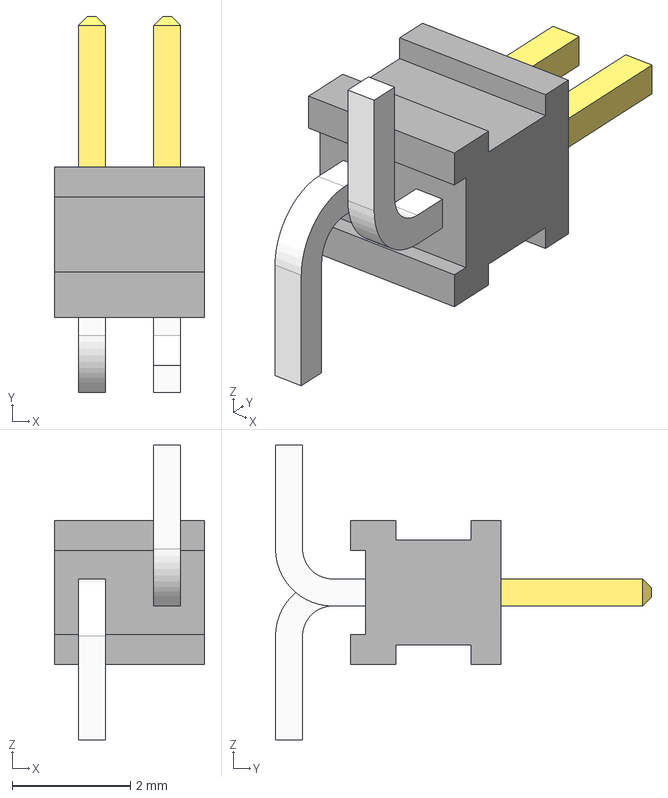
[picture p64: CAD file, 2024-10-22]
3dmodels/FTR-102-02-S-S.step
2.54 x 6.35 x 4.98 mm
FTR-102-02-S-S_body
FTR-102-02-S-S_pins
FTR-102-02-S-S2PNS
