dlutz52/lutzcraft-kicad-symbols/3dmodels/SOT-223_DIO.step

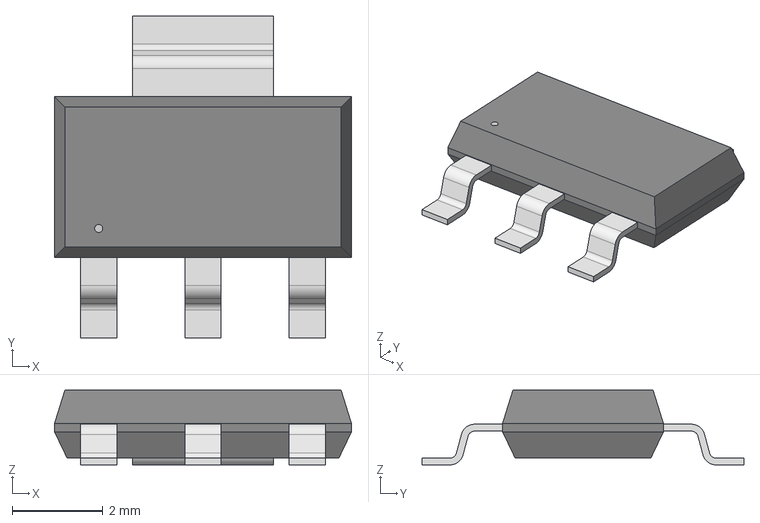
[picture p65: CAD file, 2024-10-22]
3dmodels/SOT-223_DIO.step
6.55 x 7.10 x 1.65 mm
