dlutz52/lutzcraft-kicad-symbols/3dmodels/PinHeader_1x16_P2.54mm_Vertical.step

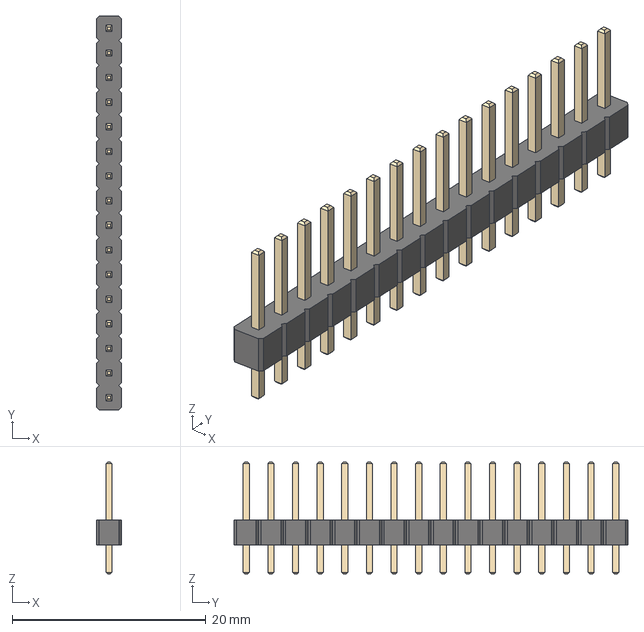
[picture p66: CAD file, 2024-10-22]
3dmodels/PinHeader_1x16_P2.54mm_Vertical.step
2.54 x 40.6 x 11.5 mm
