dlutz52/lutzcraft-kicad-symbols/3dmodels/SOT-25_TOR.step

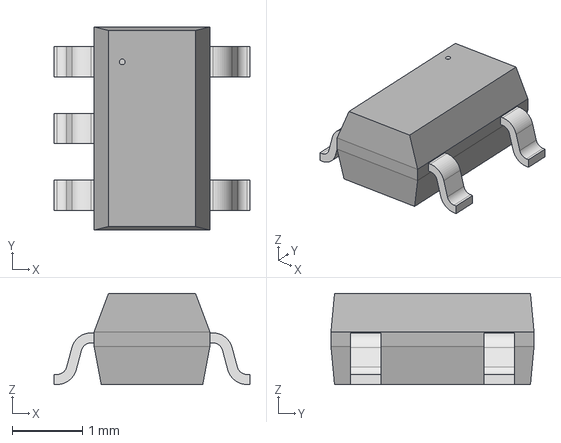
[picture p67: CAD file, 2024-10-22]
3dmodels/SOT-25_TOR.step
2.79 x 2.90 x 1.30 mm
