dlutz52/lutzcraft-kicad-symbols/3dmodels/FeatherS3.STEP

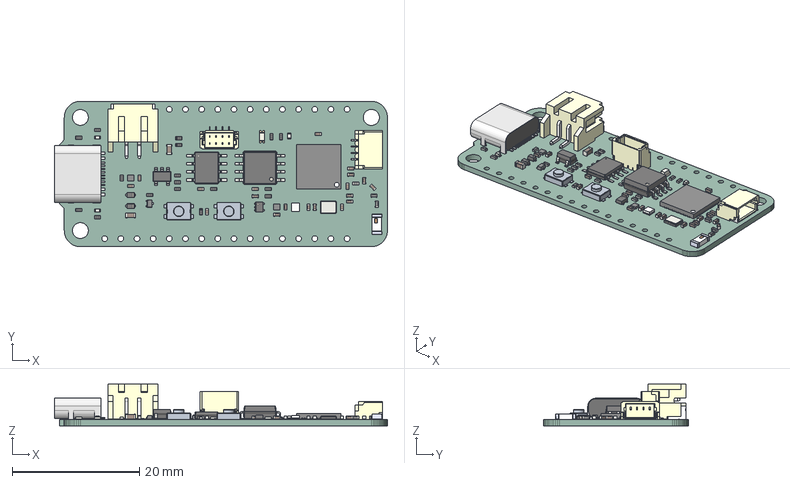
[picture p68: CAD file, 2024-10-22]
3dmodels/FeatherS3.STEP
52.3 x 22.9 x 6.53 mm
FeatherS3_P8_V2_AT2450AT18B100 PCB
