dlutz52/lutzcraft-kicad-symbols/3dmodels/PinHeader_1x12_P2.54mm_Vertical.step

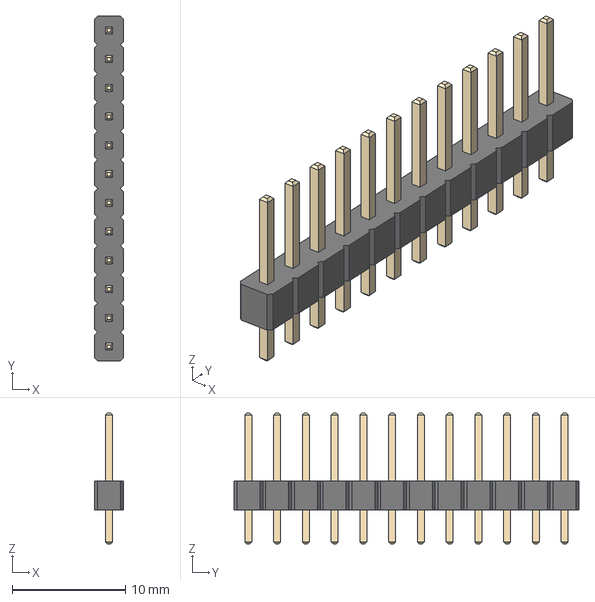
[picture p69: CAD file, 2024-10-22]
3dmodels/PinHeader_1x12_P2.54mm_Vertical.step
2.54 x 30.5 x 11.5 mm
