dlutz52/lutzcraft-kicad-symbols/3dmodels/SKRNPB.STEP

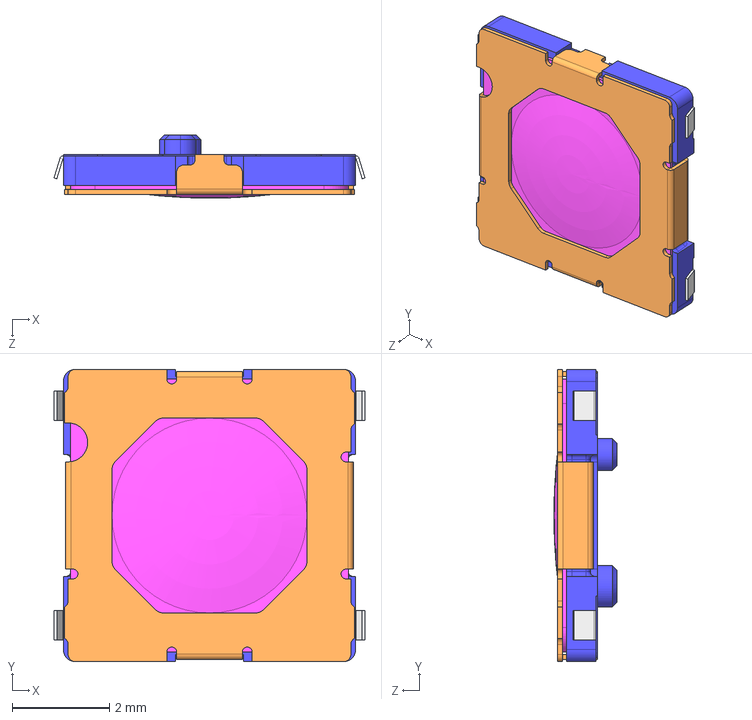
[picture p70: CAD file, 2024-10-22]
3dmodels/SKRNPB.STEP
6.38 x 6.00 x 1.30 mm
