dlutz52/lutzcraft-kicad-symbols/3dmodels/AZ1117CR2.step

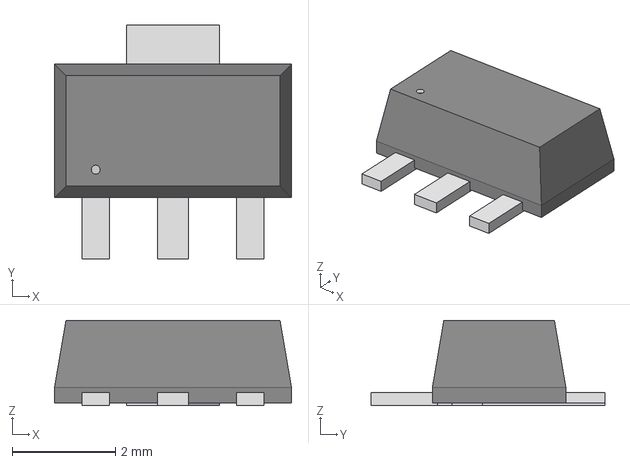
[picture p71: CAD file, 2024-10-22]
3dmodels/AZ1117CR2.step
4.60 x 4.55 x 1.65 mm
