dlutz52/lutzcraft-kicad-symbols/3dmodels/PTS810SJK250SMTRLFS.step

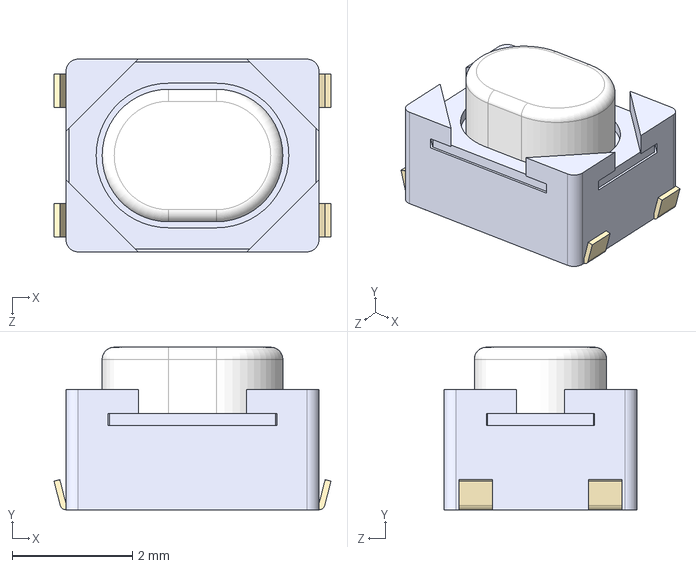
[picture p72: CAD file, 2024-10-07]
3dmodels/PTS810SJK250SMTRLFS.step
4.60 x 2.70 x 3.20 mm
