dlutz52/lutzcraft-kicad-symbols/3dmodels/21-0042B_16_MXM.step

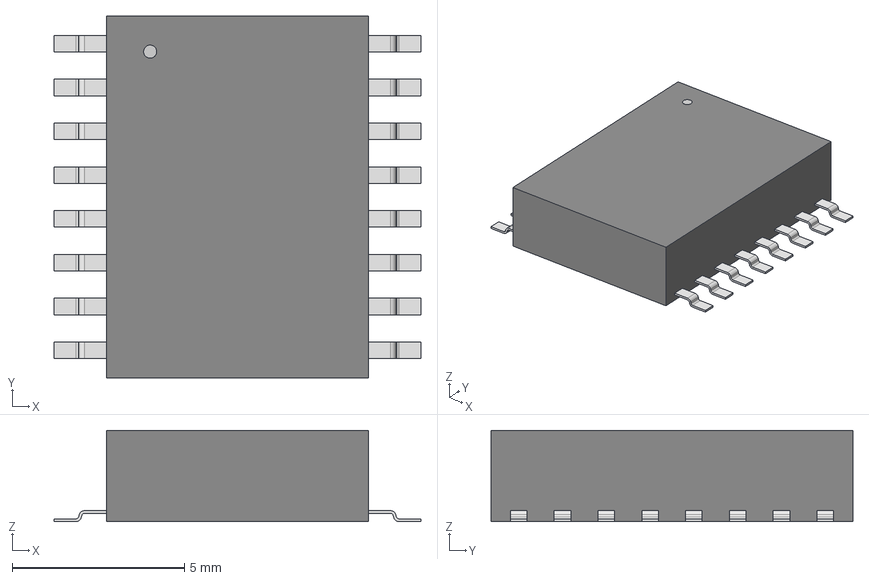
[picture p73: CAD file, 2024-10-07]
3dmodels/21-0042B_16_MXM.step
10.6 x 10.5 x 2.64 mm
