dlutz52/lutzcraft-kicad-symbols/3dmodels/ESP32-S3-MINI-1-N8.step

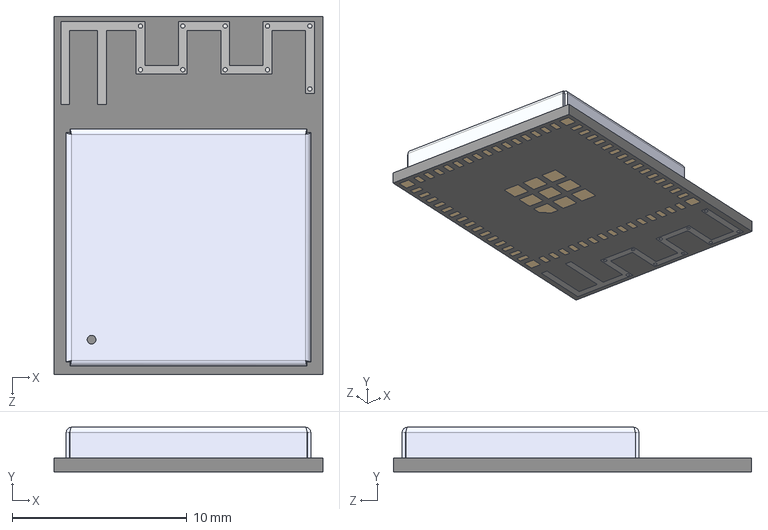
[picture p74: CAD file, 2024-10-07]
3dmodels/ESP32-S3-MINI-1-N8.step
15.4 x 2.55 x 20.5 mm
