dlutz52/lutzcraft-kicad-symbols/3dmodels/D3V3XA4B10LP-7.stp

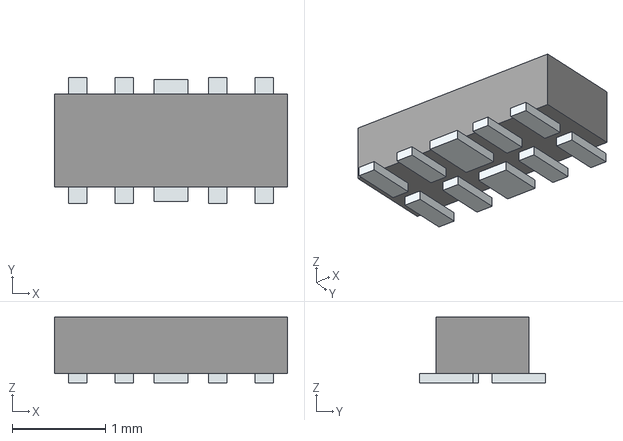
[picture p75: CAD file, 2024-10-07]
3dmodels/D3V3XA4B10LP-7.stp
2.50 x 1.35 x 0.705 mm
Pins
