dlutz52/lutzcraft-kicad-symbols/3dmodels/ENS210-LQFM.step

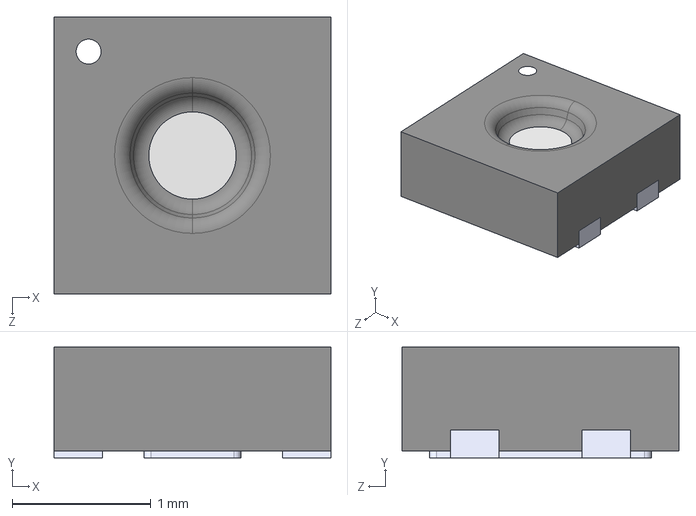
[picture p76: CAD file, 2024-10-07]
3dmodels/ENS210-LQFM.step
2.00 x 0.8 x 2.00 mm
