dlutz52/lutzcraft-kicad-symbols/3dmodels/ESP32-S3-WROOM-2-N32R8V.step

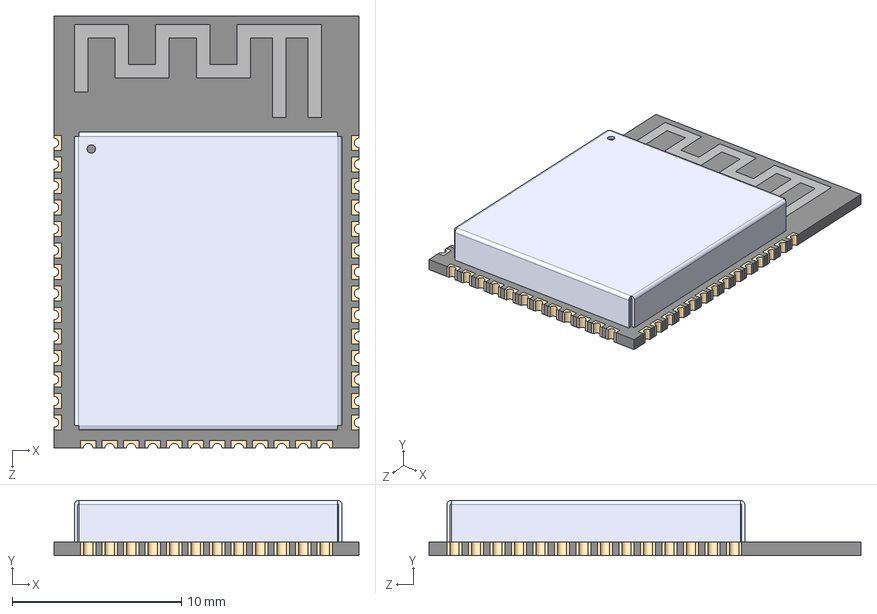
[picture p77: CAD file, 2024-10-07]
3dmodels/ESP32-S3-WROOM-2-N32R8V.step
18.0 x 3.25 x 25.5 mm
