dlutz52/lutzcraft-kicad-symbols/3dmodels/ESD7104MUTAG.step

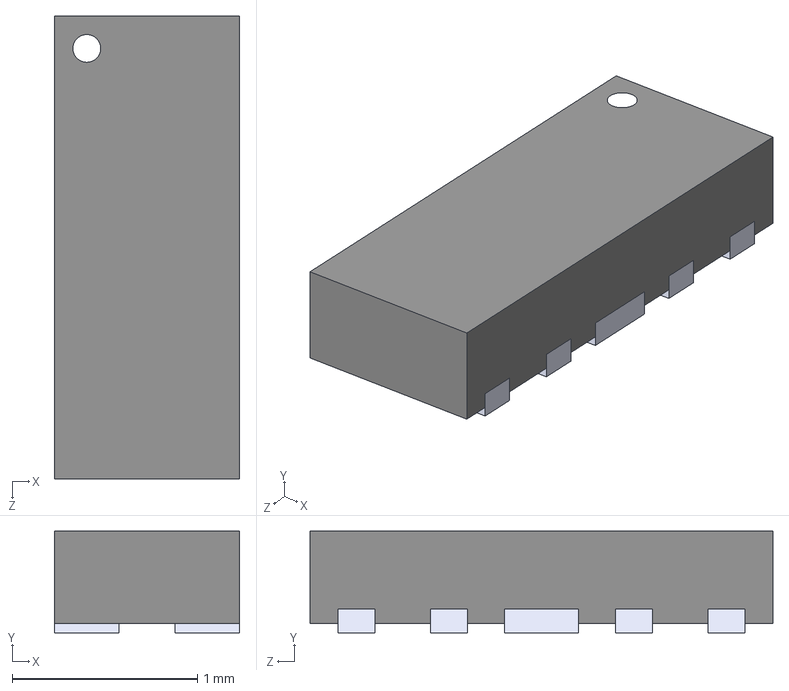
[picture p78: CAD file, 2024-10-07]
3dmodels/ESD7104MUTAG.step
1.00 x 0.55 x 2.50 mm
