dlutz52/lutzcraft-kicad-symbols/3dmodels/pqfp100_p0-65_l20_w14.stp

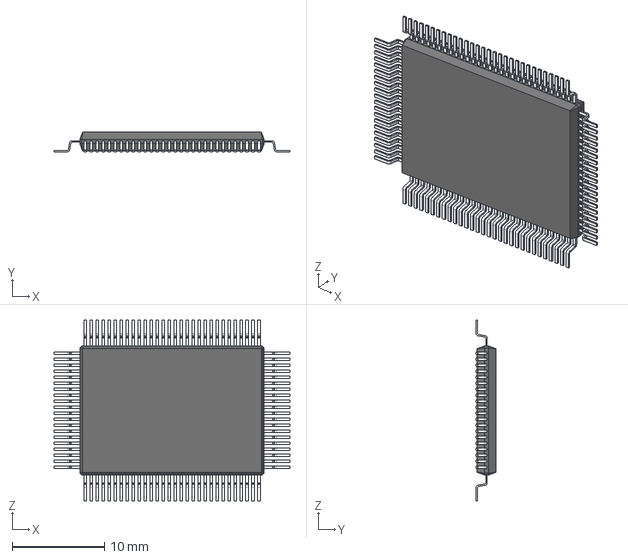
[picture p79: CAD file, 2024-09-09]
3dmodels/pqfp100_p0-65_l20_w14.stp
25.6 x 2.15 x 19.6 mm
