dlutz52/lutzcraft-kicad-symbols/3dmodels/ESP-WROVER-KIT.stp

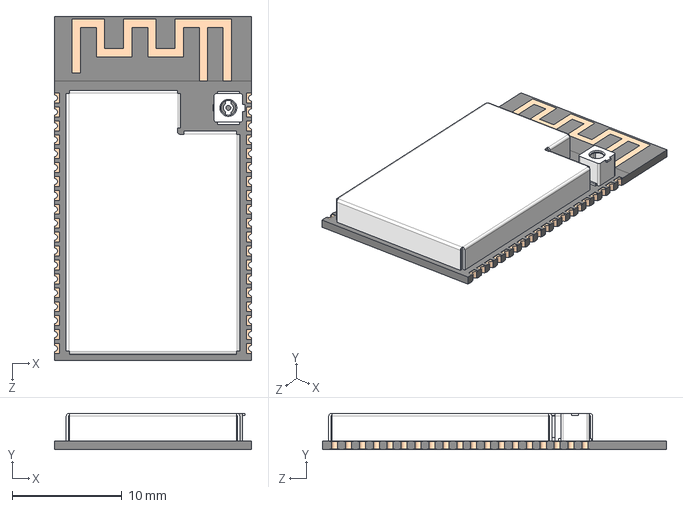
[picture p80: CAD file, 2024-09-09]
3dmodels/ESP-WROVER-KIT.stp
18.0 x 3.30 x 31.4 mm
