dlutz52/lutzcraft-kicad-symbols/3dmodels/SC0915--3DModel-STEP-1.STEP

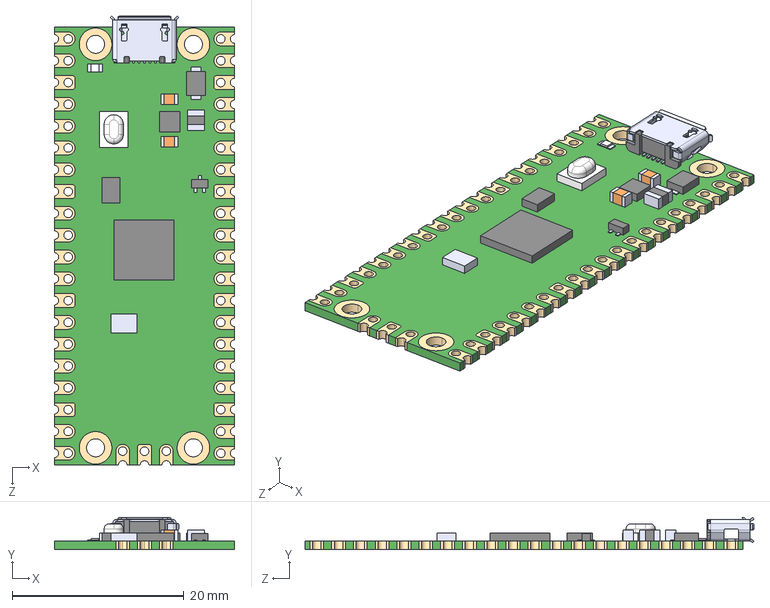
[picture p81: CAD file, 2024-09-09]
3dmodels/SC0915--3DModel-STEP-1.STEP
21.0 x 3.73 x 52.3 mm
