dlutz52/lutzcraft-kicad-symbols/3dmodels/tact_switch_3mm.stp

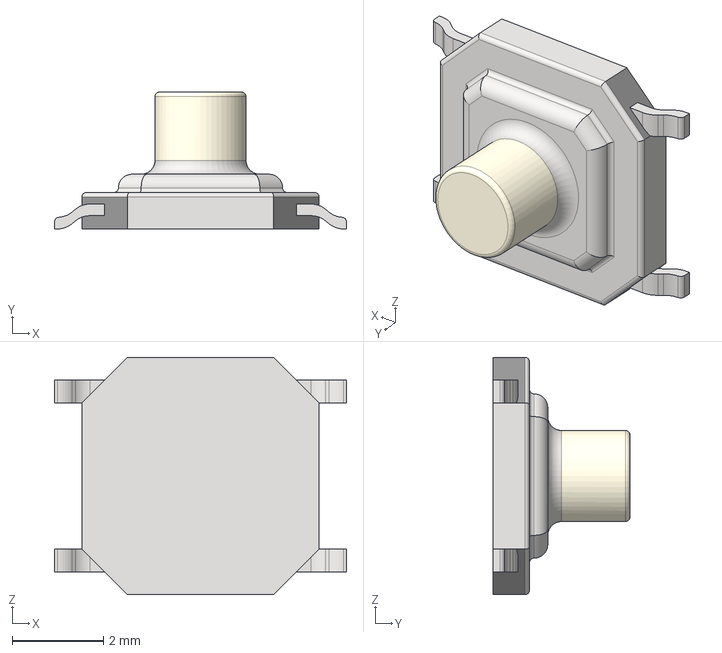
[picture p82: CAD file, 2024-09-09]
3dmodels/tact_switch_3mm.stp
6.40 x 3.00 x 5.20 mm
