dlutz52/lutzcraft-kicad-symbols/3dmodels/Z8S18020FSG.stp

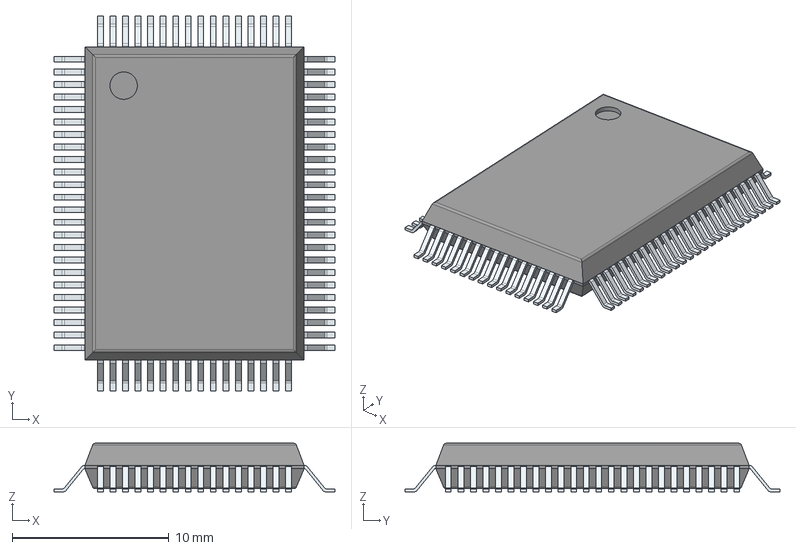
[picture p83: CAD file, 2024-09-09]
3dmodels/Z8S18020FSG.stp
17.9 x 23.9 x 3.10 mm
PinsArrayLR
PinsArrayTB
