dlutz52/lutzcraft-kicad-symbols/3dmodels/NN01-102.stp

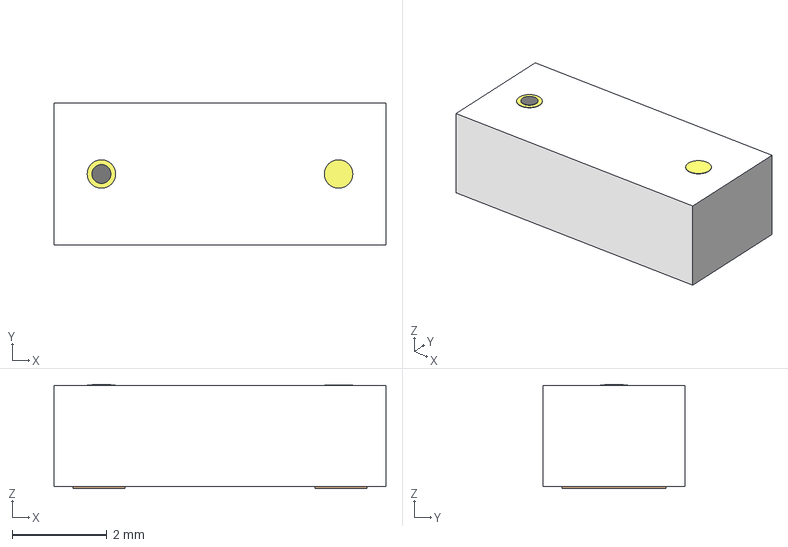
[picture p84: CAD file, 2024-09-09]
3dmodels/NN01-102.stp
7.00 x 3.00 x 2.20 mm
solidBody
solidLead
solidtop
solidMark
