dlutz52/lutzcraft-kicad-symbols/3dmodels/FBGA96_TW_MRN.step

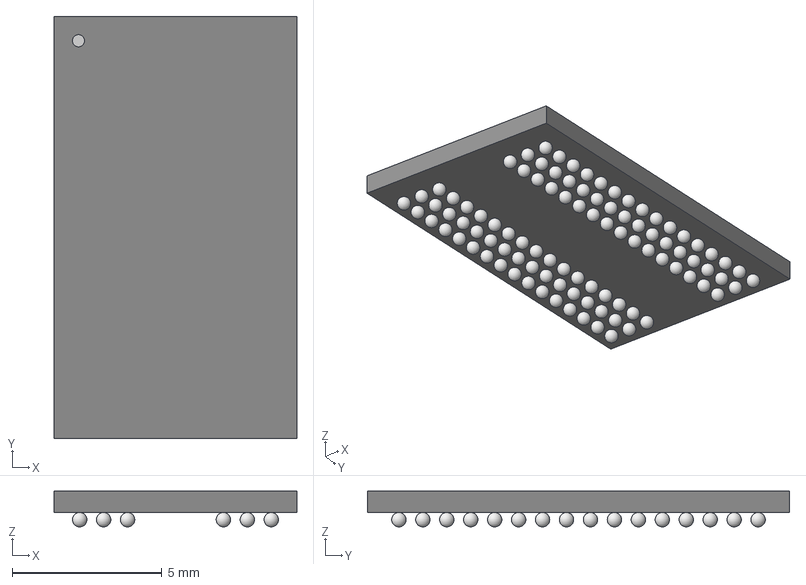
[picture p85: CAD file, 2024-09-09]
3dmodels/FBGA96_TW_MRN.step
8.10 x 14.1 x 1.20 mm
