dlutz52/lutzcraft-kicad-symbols/3dmodels/NN02-101.step

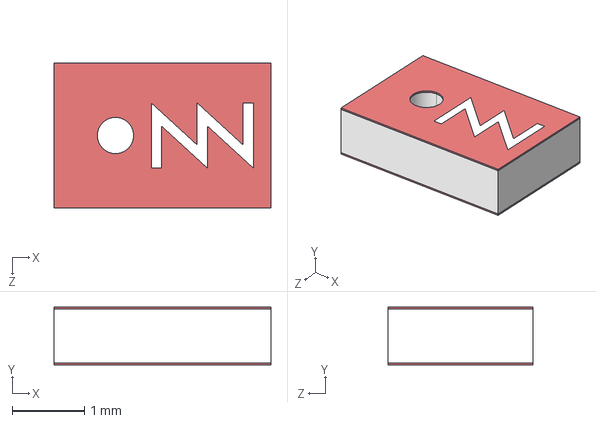
[picture p86: CAD file, 2024-09-09]
3dmodels/NN02-101.step
3.00 x 0.8 x 2.00 mm
