dlutz52/lutzcraft-kicad-symbols/3dmodels/c-1825910-6-c-tactile_switch-3d.stp

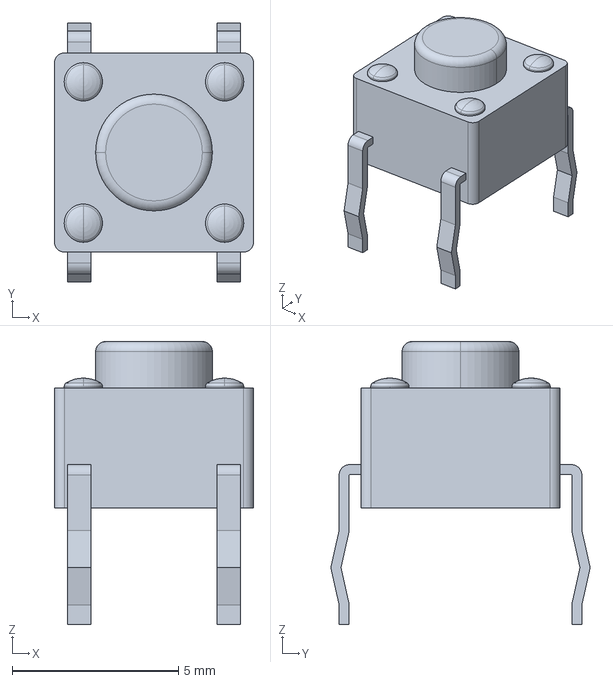
[picture p87: CAD file, 2024-09-09]
3dmodels/c-1825910-6-c-tactile_switch-3d.stp
5.99 x 7.80 x 8.51 mm
