dlutz52/lutzcraft-kicad-symbols/3dmodels/CUI_DEVICES_SJ1-3515N.step

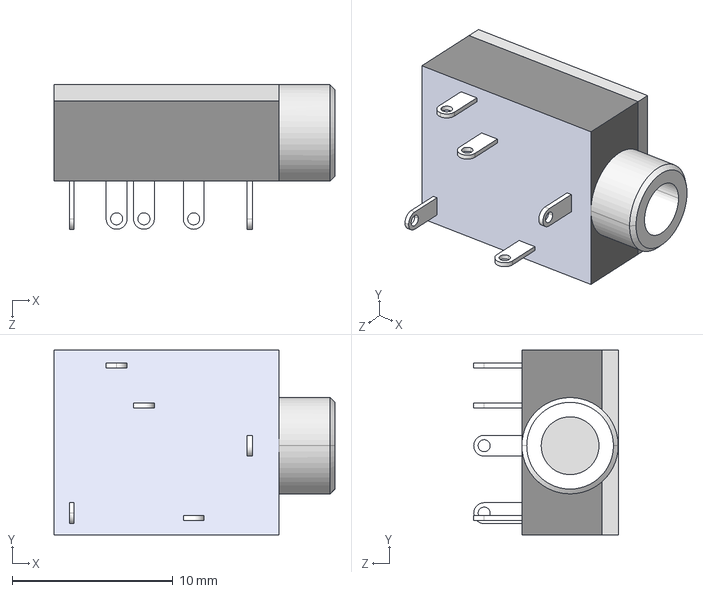
[picture p88: CAD file, 2024-09-09]
3dmodels/CUI_DEVICES_SJ1-3515N.step
17.5 x 11.5 x 9.00 mm
