dlutz52/lutzcraft-kicad-symbols/3dmodels/EG1249.step

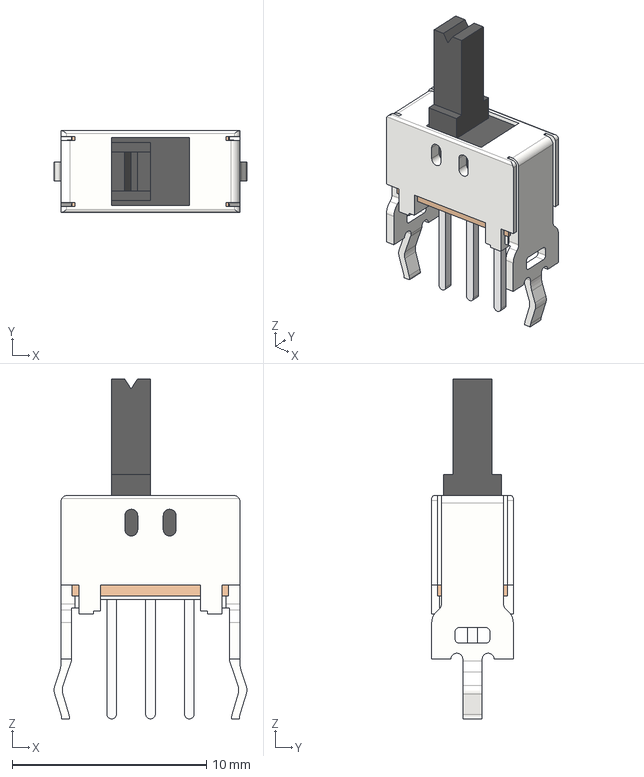
[picture p89: CAD file, 2024-09-09]
3dmodels/EG1249.step
9.93 x 4.20 x 17.5 mm
