dlutz52/lutzcraft-kicad-symbols/3dmodels/1062.stp

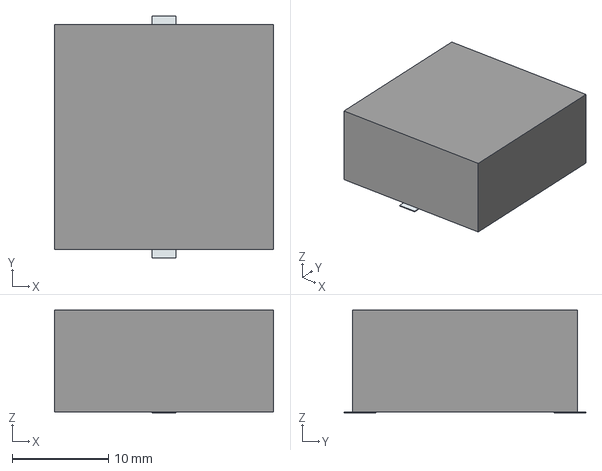
[picture p90: CAD file, 2024-09-09]
3dmodels/1062.stp
22.7 x 25.1 x 10.7 mm
Pins
