dlutz52/lutzcraft-kicad-symbols/3dmodels/DS1337S+.STEP

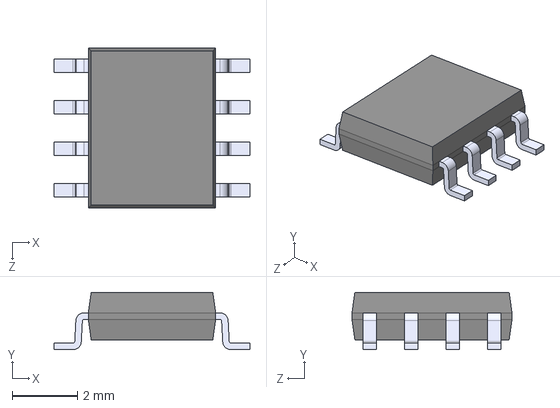
[picture p91: CAD file, 2024-09-09]
3dmodels/DS1337S+.STEP
6.00 x 1.75 x 4.90 mm
