dlutz52/lutzcraft-kicad-symbols/3dmodels/ESP32-SOLO-1.stp

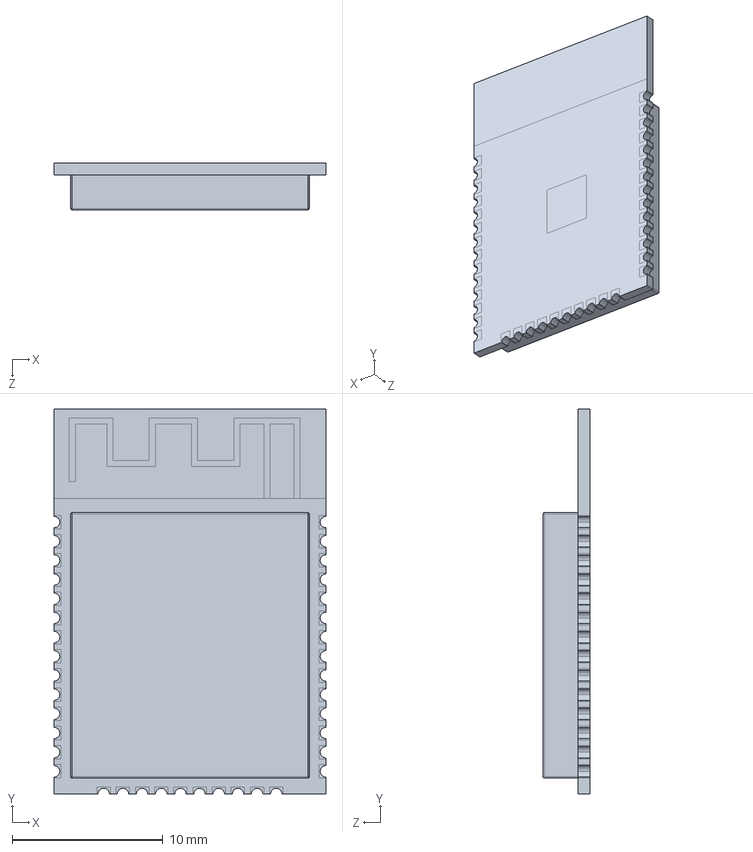
[picture p92: CAD file, 2024-09-09]
3dmodels/ESP32-SOLO-1.stp
18.0 x 25.5 x 3.10 mm
