dlutz52/lutzcraft-kicad-symbols/3dmodels/Tactile switch Omron_B3F.step

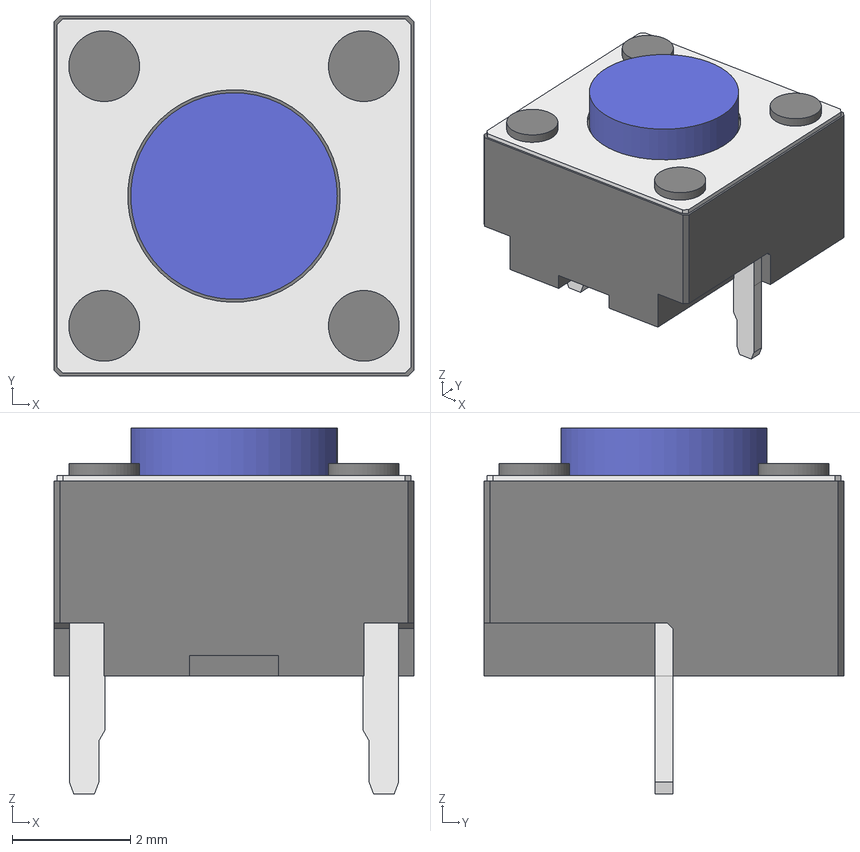
[picture p93: CAD file, 2024-09-09]
3dmodels/Tactile switch Omron_B3F.step
6.10 x 6.10 x 6.20 mm
Pad004_(Mirror_#1)
