dlutz52/lutzcraft-kicad-symbols/3dmodels/RTL8211F-CG.stp

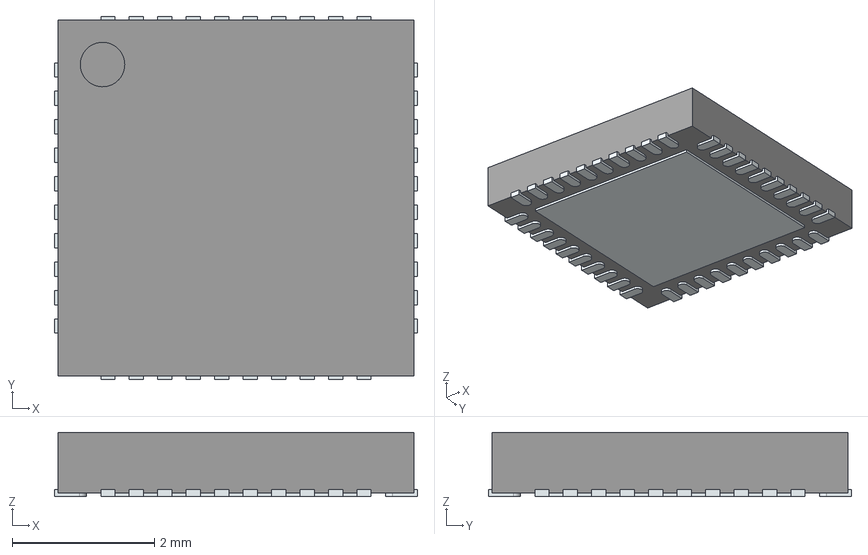
[picture p94: CAD file, 2024-09-09]
3dmodels/RTL8211F-CG.stp
5.10 x 5.10 x 0.9 mm
ThermalPin
PinsArrayLR
PinsArrayTB
