dlutz52/lutzcraft-kicad-symbols/3dmodels/EG1218--3DModel-STEP-520916.STEP

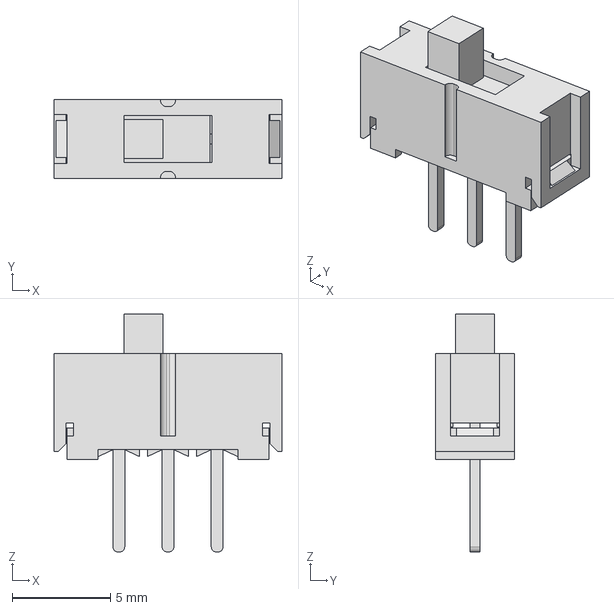
[picture p95: CAD file, 2024-09-09]
3dmodels/EG1218--3DModel-STEP-520916.STEP
11.6 x 4.00 x 12.1 mm
