dlutz52/lutzcraft-kicad-symbols/3dmodels/ESP32-WROVER-E__16MB_.stp

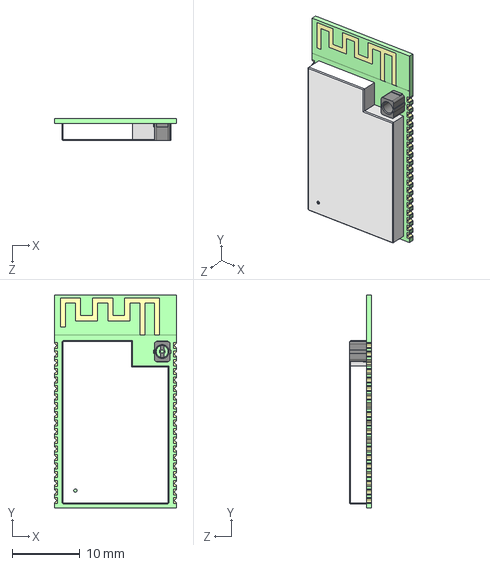
[picture p96: CAD file, 2024-09-09]
3dmodels/ESP32-WROVER-E__16MB_.stp
18.0 x 31.4 x 3.30 mm
