dlutz52/lutzcraft-kicad-symbols/3dmodels/LED_B1911PG--20D000514U1930_HVK.step

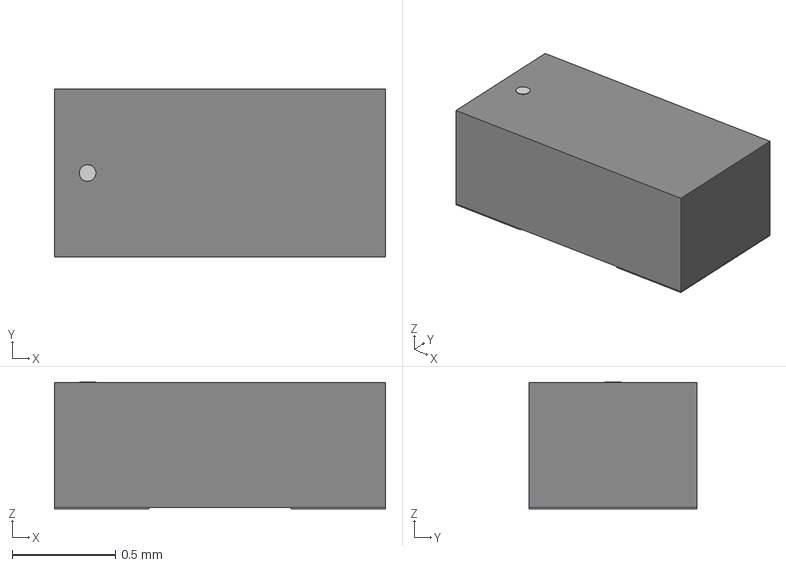
[picture p97: CAD file, 2024-09-09]
3dmodels/LED_B1911PG--20D000514U1930_HVK.step
1.60 x 0.812 x 0.612 mm
