dlutz52/lutzcraft-kicad-symbols/3dmodels/CUI_DEVICES_DS02C-254-1L-08BE-White.step

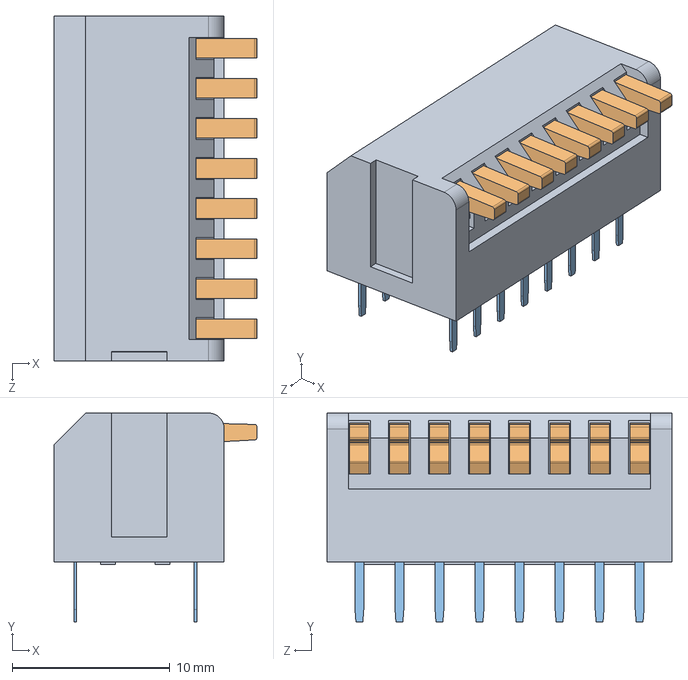
[picture p98: CAD file, 2024-09-09]
3dmodels/CUI_DEVICES_DS02C-254-1L-08BE-White.step
12.9 x 13.3 x 21.9 mm
