dlutz52/lutzcraft-kicad-symbols/3dmodels/PTA6044-2015DPB103--3DModel-STEP-269445.STEP

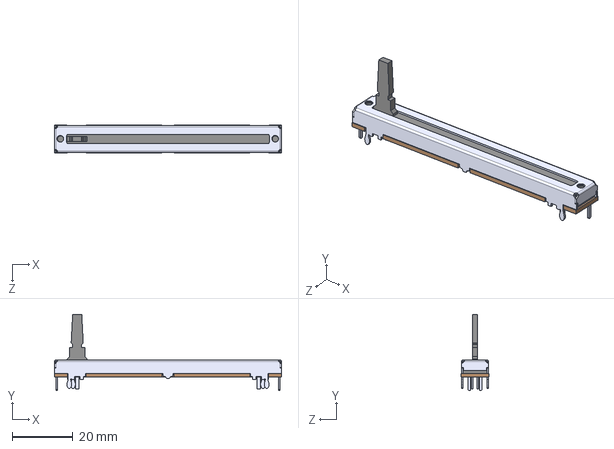
[picture p99: CAD file, 2024-09-09]
3dmodels/PTA6044-2015DPB103--3DModel-STEP-269445.STEP
75.0 x 25.2 x 9.40 mm
