dlutz52/lutzcraft-kicad-symbols/3dmodels/SN74HC00DRG4.stp

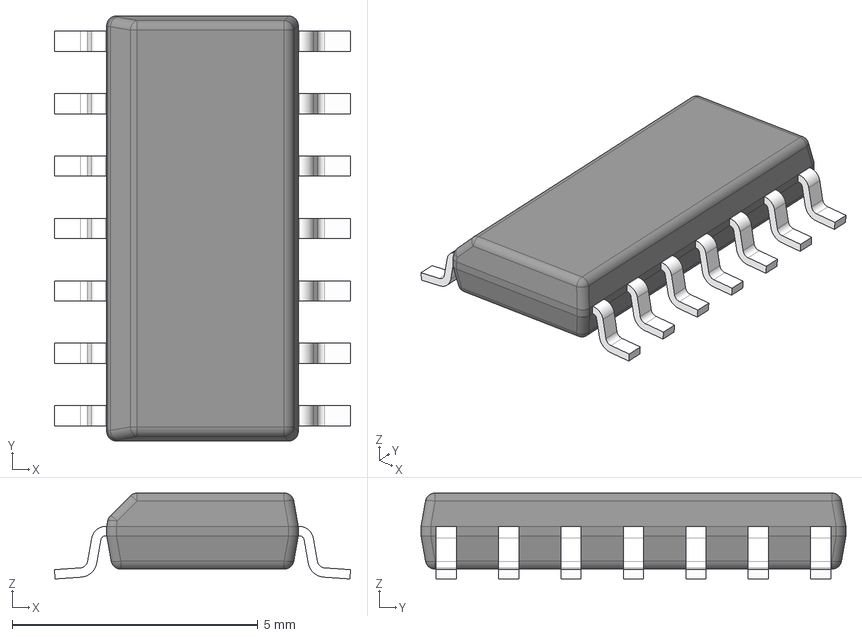
[picture p100: CAD file, 2024-09-09]
3dmodels/SN74HC00DRG4.stp
6.03 x 8.65 x 1.75 mm
BODY-SO
LEAD-SO x 14
PIN1-ID
