dlutz52/lutzcraft-kicad-symbols/3dmodels/TC2050-IDC.stp

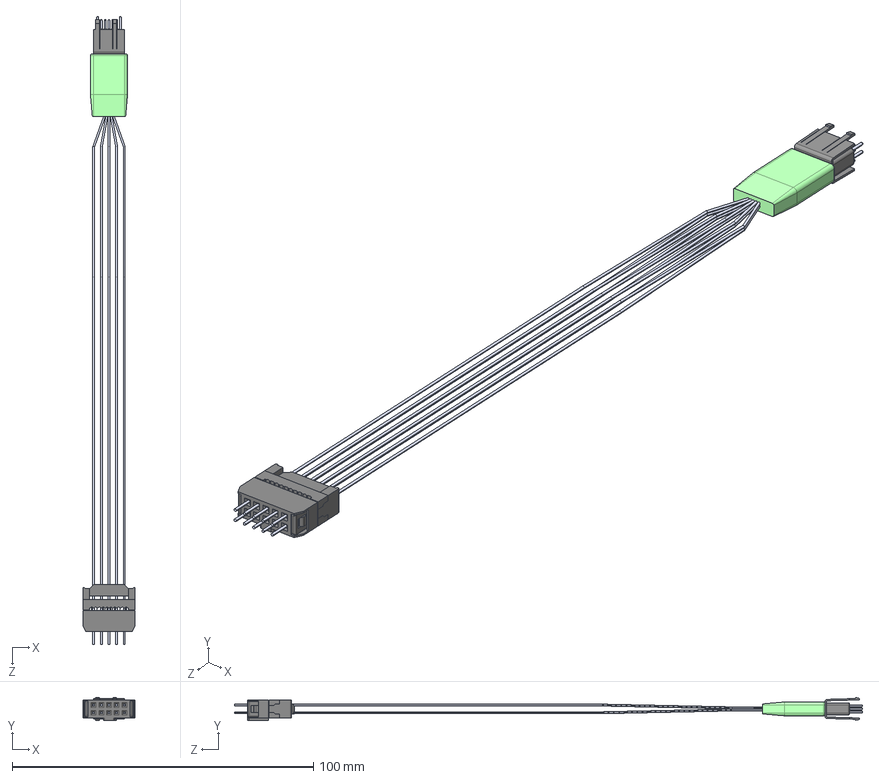
[picture p101: CAD file, 2024-09-09]
3dmodels/TC2050-IDC.stp
17.4 x 7.67 x 208.5 mm
10 pin female idc
TC2050-IDC front
Part6^TC2050-IDC
