dlutz52/lutzcraft-kicad-symbols/3dmodels/USB3320C-EZK-TR.step

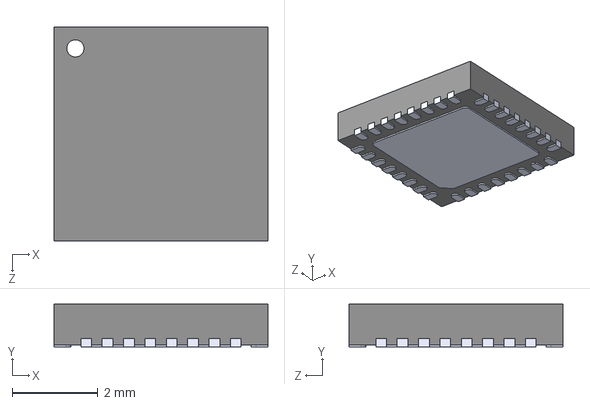
[picture p103: CAD file, 2024-09-09]
3dmodels/USB3320C-EZK-TR.step
5.00 x 1.00 x 5.00 mm
