dlutz52/lutzcraft-kicad-symbols/3dmodels/SS8050-G.stp

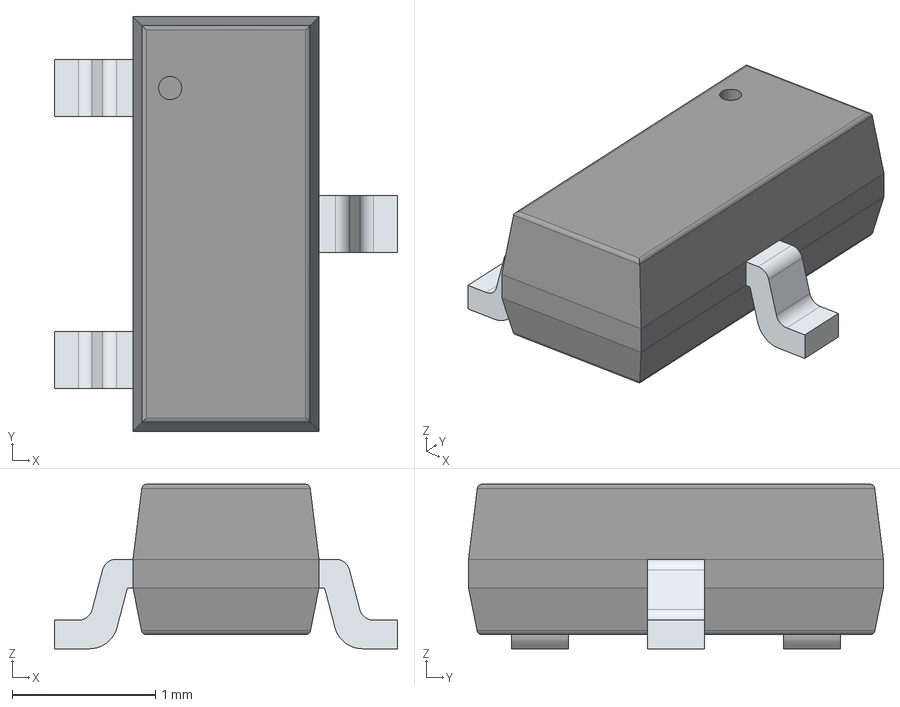
[picture p104: CAD file, 2024-09-09]
3dmodels/SS8050-G.stp
2.40 x 2.90 x 1.15 mm
PinsArrayL
FilletPinR
