dlutz52/lutzcraft-kicad-symbols/3dmodels/CTSM_TCM2NK_6032_L6.3W3.5H2.8T0.13S1.3F2.3A2.9B0.65E2.4G2.8P0.9R1X0.2.step

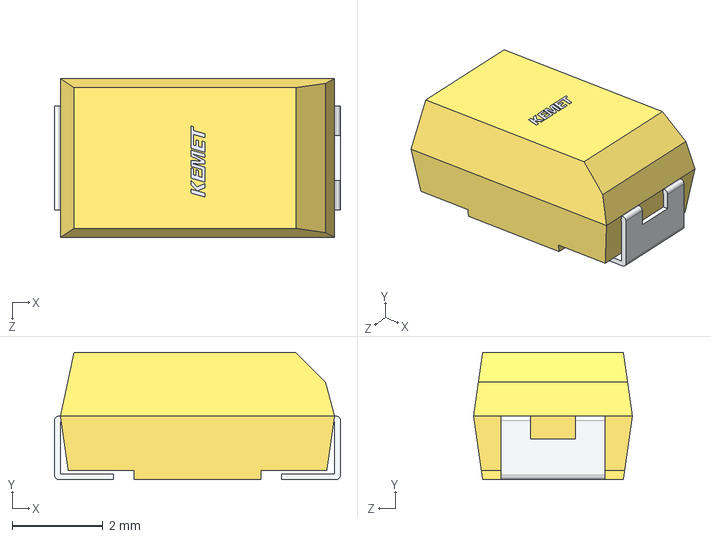
[picture p105: CAD file, 2024-09-09]
3dmodels/CTSM_TCM2NK_6032_L6.3W3.5H2.8T0.13S1.3F2.3A2.9B0.65E2.4G2.8P0.9R1X0.2.step
6.30 x 2.80 x 3.50 mm
