dlutz52/lutzcraft-kicad-symbols/3dmodels/LQFP-144_20x20mm_P0.5mm.step

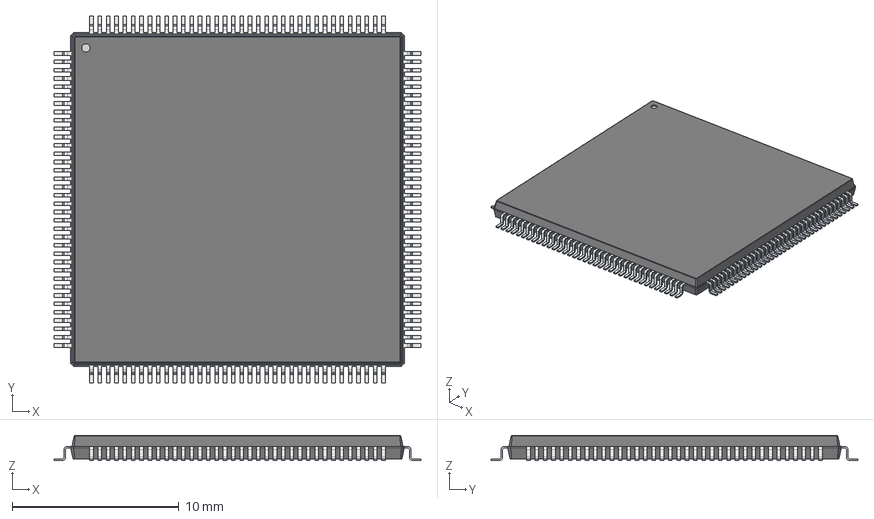
[picture p106: CAD file, 2024-09-09]
3dmodels/LQFP-144_20x20mm_P0.5mm.step
22.0 x 22.0 x 1.50 mm
