dlutz52/lutzcraft-kicad-symbols/3dmodels/CUI_DEVICES_RCJ-014.step

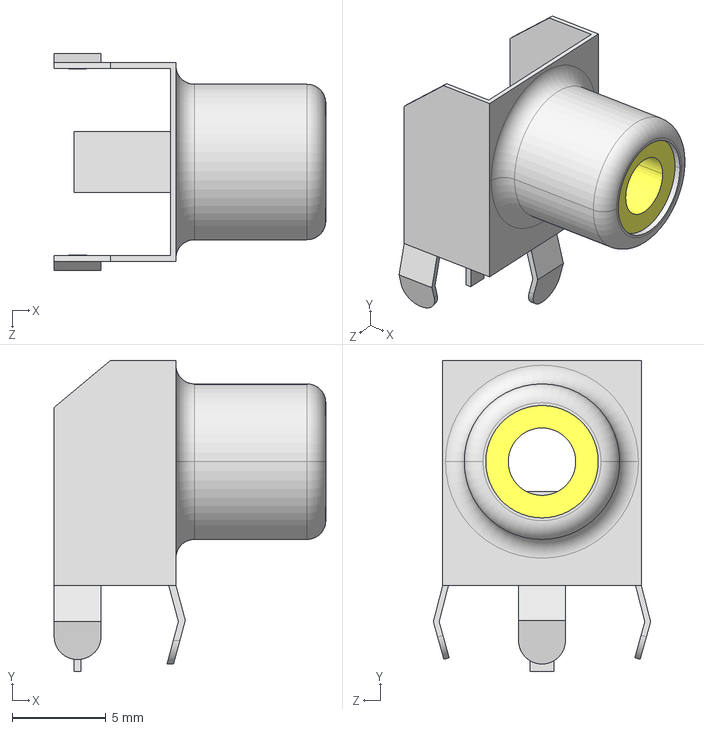
[picture p107: CAD file, 2024-09-09]
3dmodels/CUI_DEVICES_RCJ-014.step
14.5 x 16.6 x 11.6 mm
