dlutz52/lutzcraft-kicad-symbols/3dmodels/WSON_128JVEIQ_WIN.step

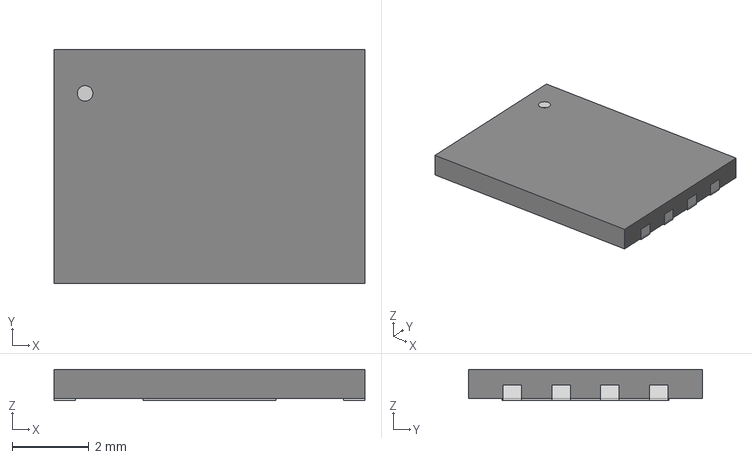
[picture p108: CAD file, 2024-09-09]
3dmodels/WSON_128JVEIQ_WIN.step
8.10 x 6.10 x 0.815 mm
