dlutz52/lutzcraft-kicad-symbols/3dmodels/PTS645  switch.STEP

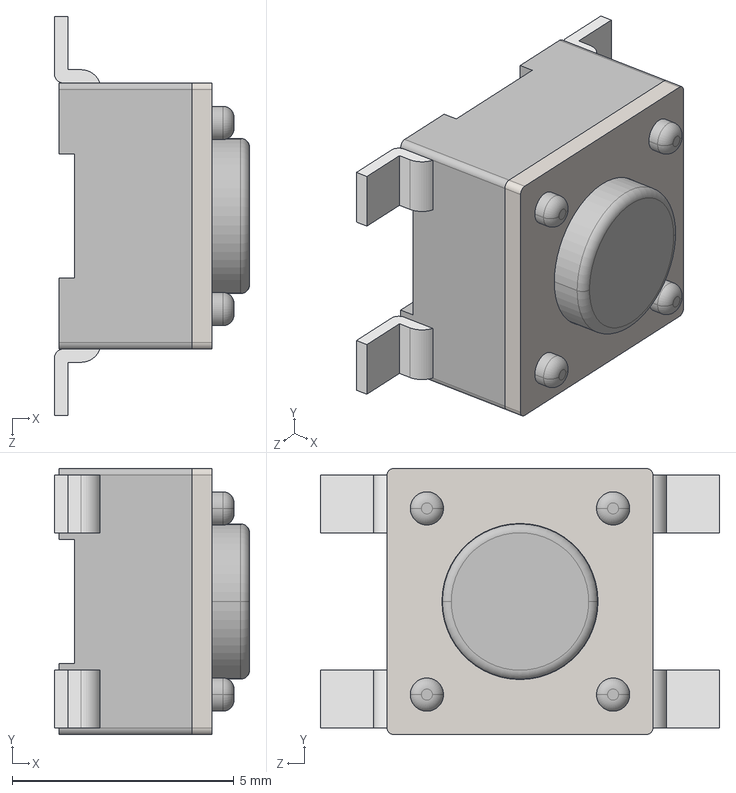
[picture p109: CAD file, 2024-09-09]
3dmodels/PTS645 switch.STEP
4.40 x 6.00 x 9.00 mm
