dlutz52/lutzcraft-kicad-symbols/3dmodels/ESP32-DevKitC.stp

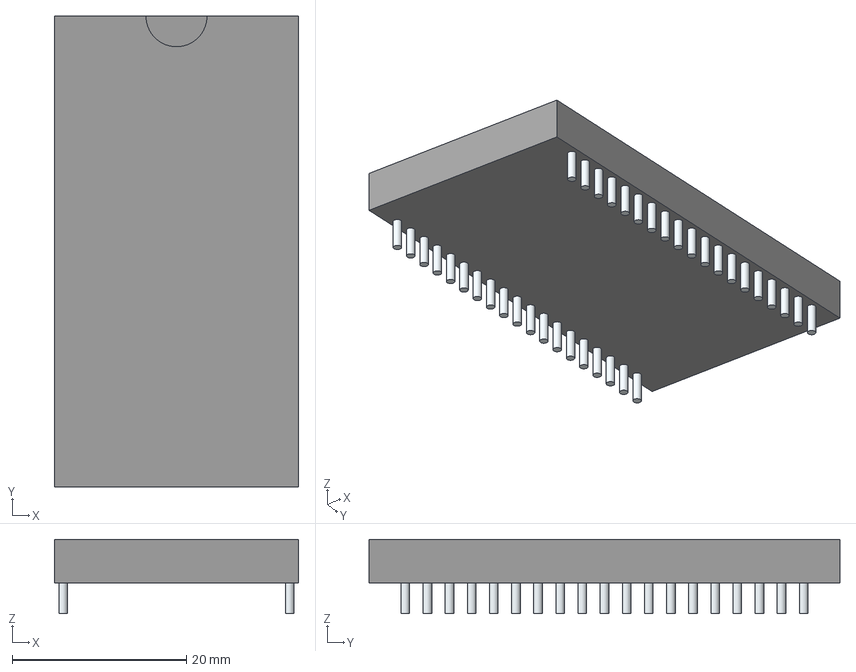
[picture p110: CAD file, 2024-09-09]
3dmodels/ESP32-DevKitC.stp
28.0 x 54.0 x 8.50 mm
PinsArrayLR
