dlutz52/lutzcraft-kicad-symbols/3dmodels/ICE40HX8K-CB132.stp

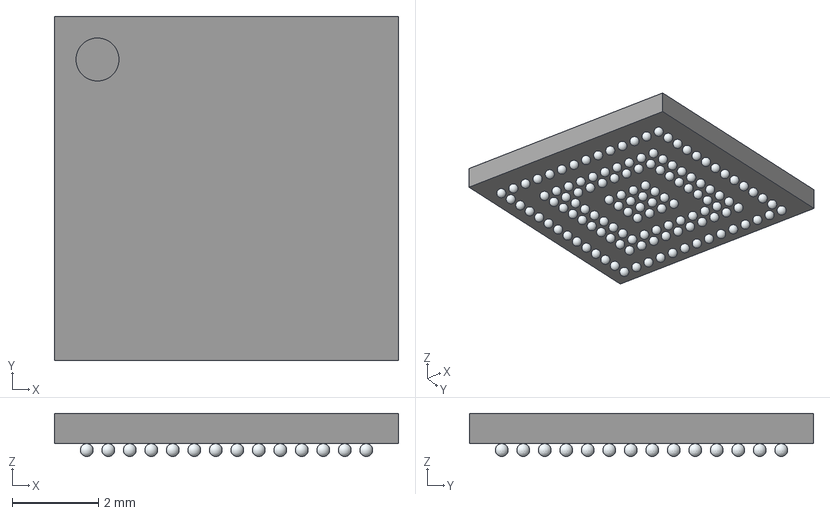
[picture p111: CAD file, 2024-09-09]
3dmodels/ICE40HX8K-CB132.stp
8.00 x 8.00 x 1.00 mm
A1
A2
A3
A4
A5
A6
A7
A8
A9
A10
A11
A12
A13
A14
B1
B14
C1
C3
C4
C5
C6
C7
C8
C9
C10
C11
C12
C14
D1
D3
D4
D5
D6
D7
D8
D9
D10
D11
D12
D14
E1
E3
E4
E11
E12
E14
F1
F3
F4
F6
F7
F8
F9
F11
F12
F14
G1
G3
G4
G6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
