dlutz52/lutzcraft-kicad-symbols/3dmodels/RCJ-014.stp

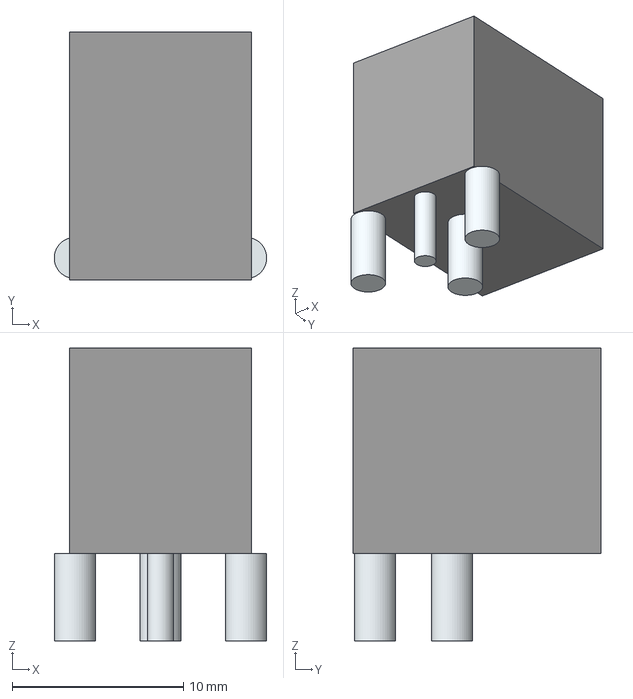
[picture p112: CAD file, 2024-09-09]
3dmodels/RCJ-014.stp
12.4 x 14.5 x 17.1 mm
Leads x 4
