dlutz52/lutzcraft-kicad-symbols/3dmodels/LED Bar Graph Generic 8 Yellow.step

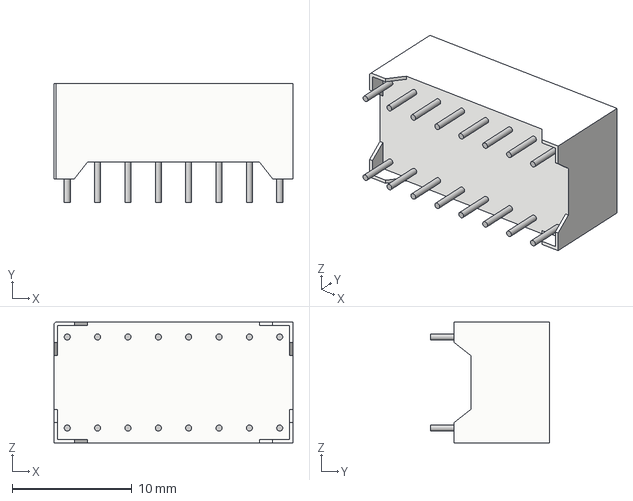
[picture p113: CAD file, 2024-09-09]
3dmodels/LED Bar Graph Generic 8 Yellow.step
20.0 x 10.0 x 10.1 mm
