dlutz52/lutzcraft-kicad-symbols/3dmodels/PS60-20MC1BR10K.stp

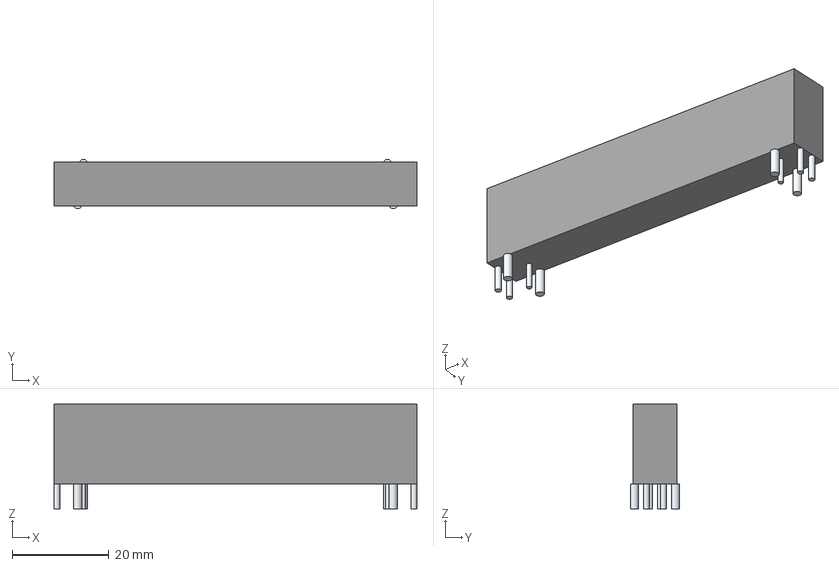
[picture p114: CAD file, 2024-09-09]
3dmodels/PS60-20MC1BR10K.stp
75.0 x 10.2 x 21.6 mm
Leads x 10
