dlutz52/lutzcraft-kicad-symbols/3dmodels/DC Power Jack 5.5mm x 2.1mm.STEP

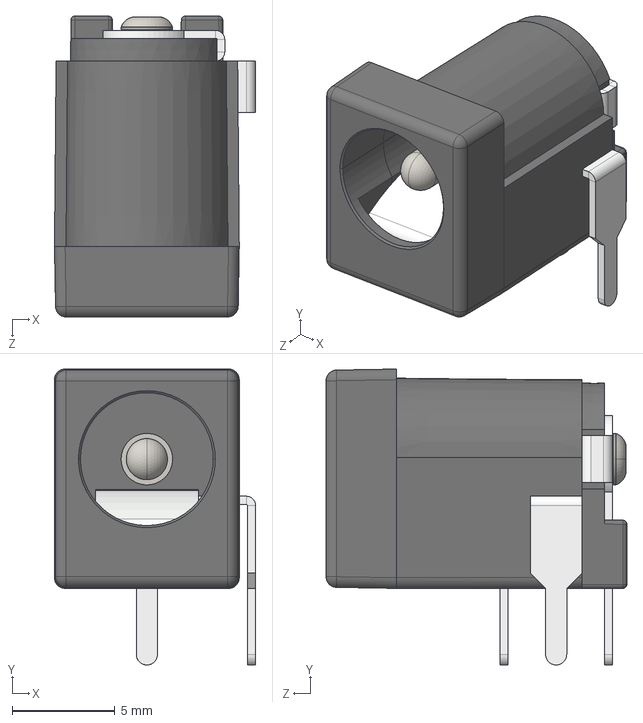
[picture p115: CAD file, 2024-09-09]
3dmodels/DC Power Jack 5.5mm x 2.1mm.STEP
9.77 x 14.4 x 14.6 mm
