dlutz52/lutzcraft-kicad-symbols/3dmodels/Molex-105164-0001_USB-B-Micro.step

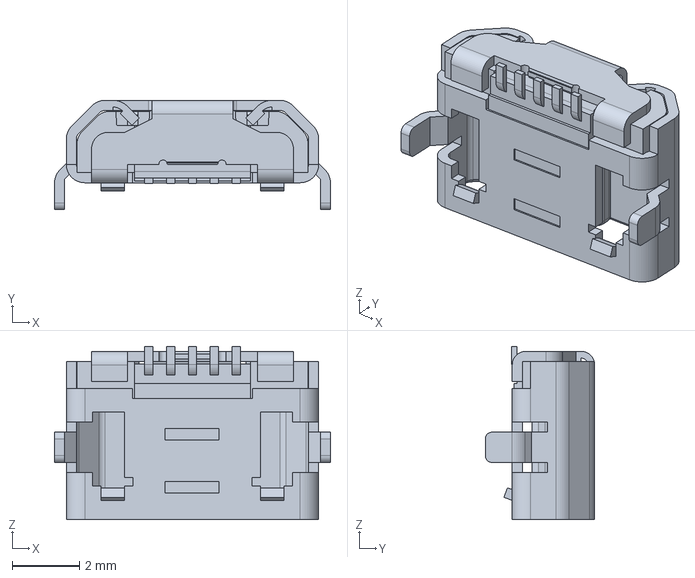
[picture p116: CAD file, 2024-09-09]
3dmodels/Molex-105164-0001_USB-B-Micro.step
8.20 x 3.25 x 5.15 mm
