dlutz52/lutzcraft-kicad-symbols/3dmodels/DF40C-60DP.stp

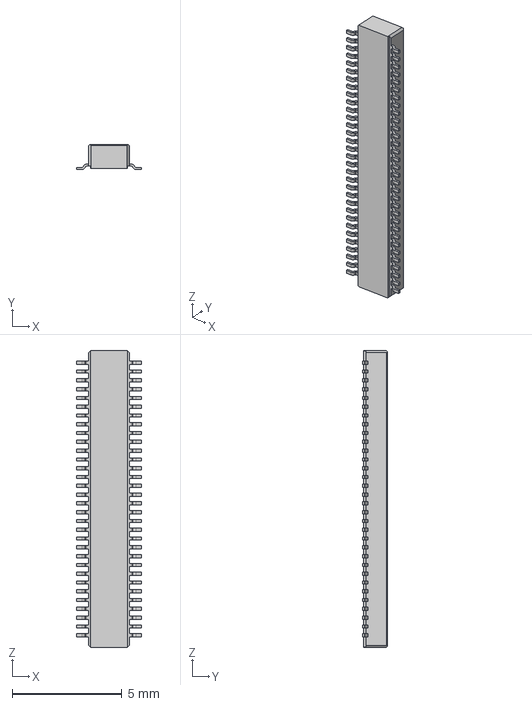
[picture p117: CAD file, 2024-09-09]
3dmodels/DF40C-60DP.stp
2.97 x 1.14 x 13.5 mm
