dlutz52/lutzcraft-kicad-symbols/3dmodels/keystone_1062.step

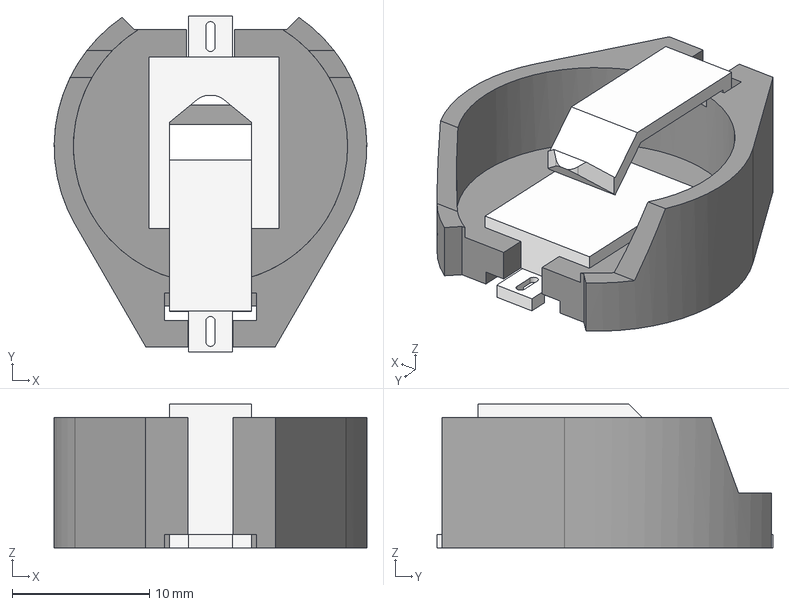
[picture p118: CAD file, 2024-09-09]
3dmodels/keystone_1062.step
22.8 x 24.5 x 10.5 mm
Negative_plate
Positive_plate
