dlutz52/lutzcraft-kicad-symbols/3dmodels/ESP32-WROVER-IE_4MB_.stp

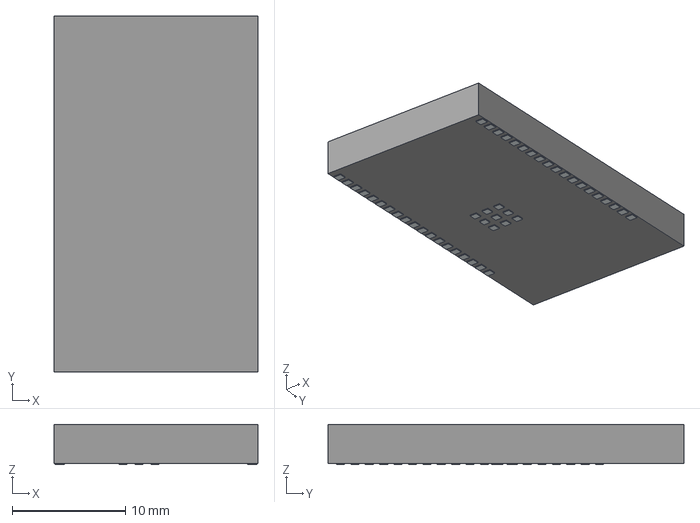
[picture p119: CAD file, 2024-09-09]
3dmodels/ESP32-WROVER-IE_4MB_.stp
18.0 x 31.4 x 3.55 mm
Pins
