dlutz52/lutzcraft-kicad-symbols/3dmodels/keystone_1061.step

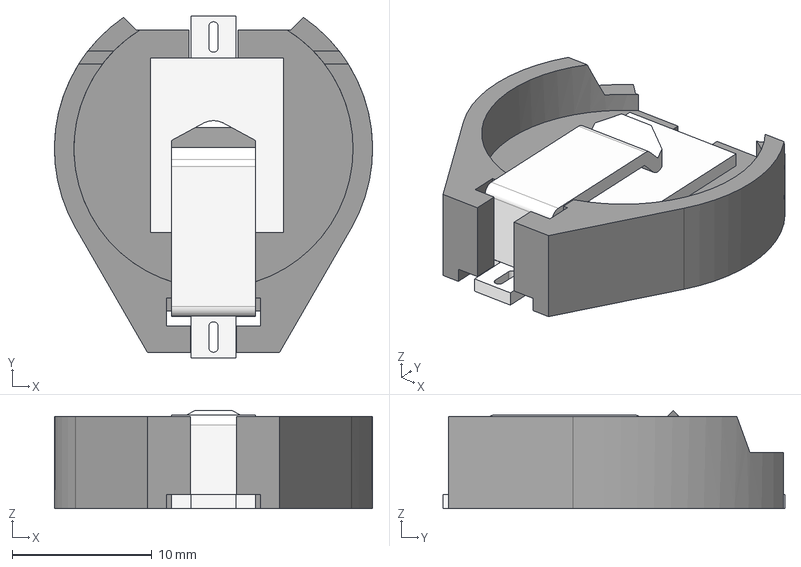
[picture p120: CAD file, 2024-09-09]
3dmodels/keystone_1061.step
22.8 x 24.5 x 7.03 mm
Negative_plate
Positive_plate
