dlutz52/lutzcraft-kicad-symbols/3dmodels/panasonic-slide-pot-Part.step

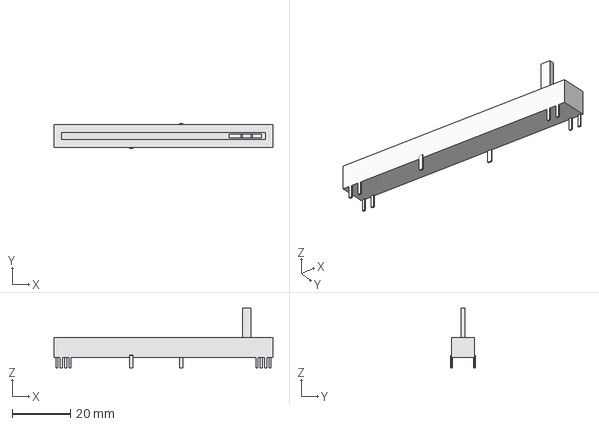
[picture p121: CAD file, 2024-09-09]
3dmodels/panasonic-slide-pot-Part.step
75.0 x 8.40 x 20.5 mm
