dlutz52/lutzcraft-kicad-symbols/3dmodels/CD74HC138E.stp

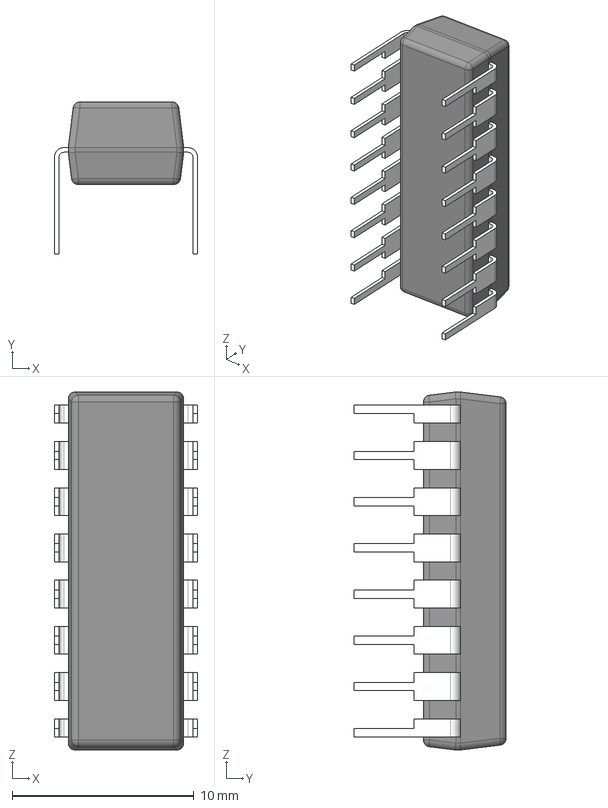
[picture p122: CAD file, 2024-09-09]
3dmodels/CD74HC138E.stp
7.87 x 8.37 x 19.7 mm
BODY_N0016A_AF0
LEAD_N0016A_AF1
LEAD_N0016A x 10
LEAD_N0016A_AF3
LEAD_N0016A_AF5
LEAD_N0016A_AF0
LEAD_N0016A_AF2
LEAD_N0016A_AF4
