dlutz52/lutzcraft-kicad-symbols/3dmodels/3306W.stp

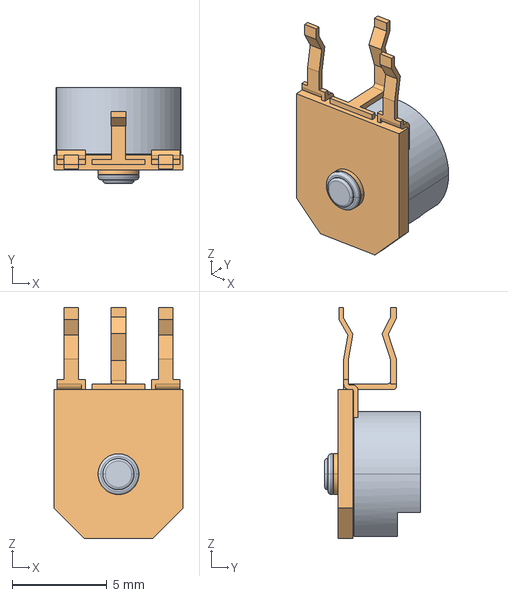
[picture p123: CAD file, 2024-09-09]
3dmodels/3306W.stp
6.81 x 5.05 x 12.2 mm
