dlutz52/lutzcraft-kicad-symbols/3dmodels/ESP32-S3-WROOM-1U.step

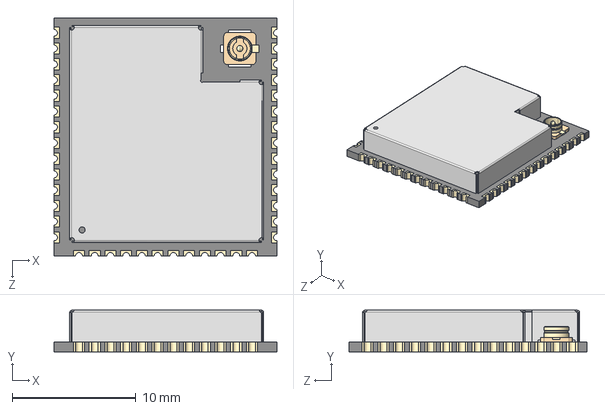
[picture p124: CAD file, 2024-09-09]
3dmodels/ESP32-S3-WROOM-1U.step
18.0 x 3.35 x 19.2 mm
