dlutz52/lutzcraft-kicad-symbols/3dmodels/ATSAMD21G18A-AU.stp

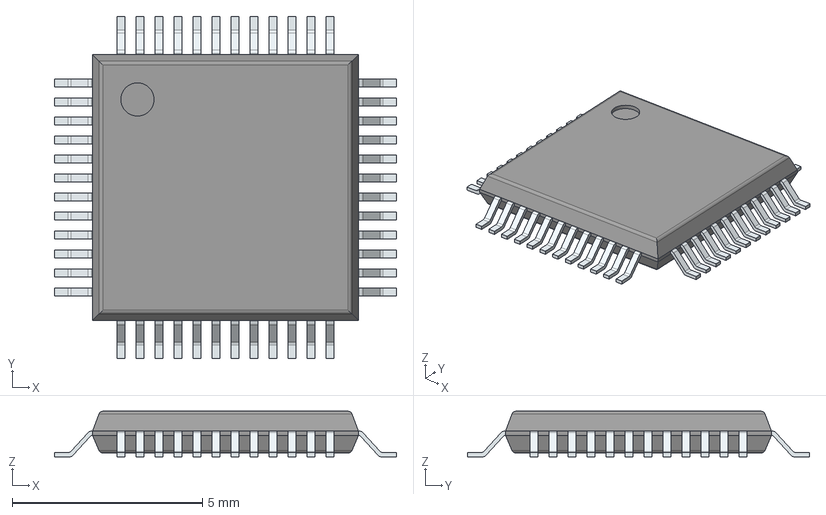
[picture p125: CAD file, 2024-09-09]
3dmodels/ATSAMD21G18A-AU.stp
9.00 x 9.00 x 1.20 mm
PinsArrayLR
PinsArrayTB
