dlutz52/lutzcraft-kicad-symbols/3dmodels/VFBGA153_9X7_5X0_8_SHM.step

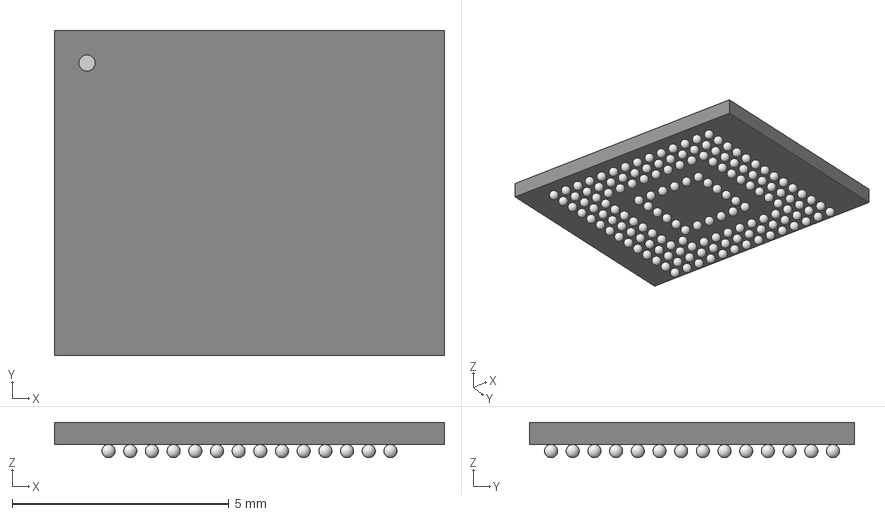
[picture p126: CAD file, 2024-09-09]
3dmodels/VFBGA153_9X7_5X0_8_SHM.step
8.99 x 7.49 x 0.815 mm
