dlutz52/lutzcraft-kicad-symbols/3dmodels/GT12MSABE.stp

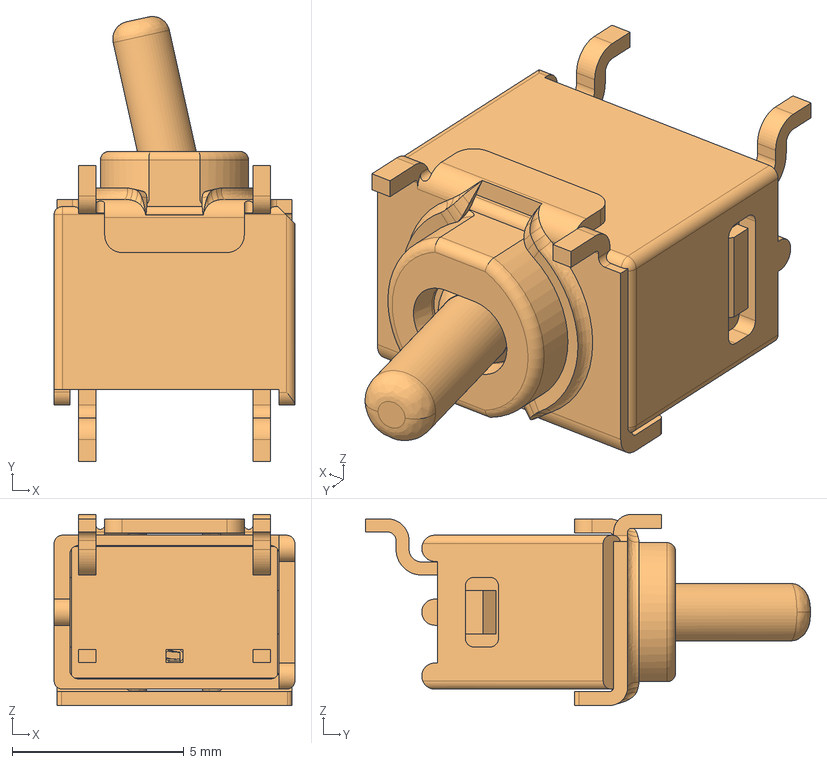
[picture p127: CAD file, 2024-09-09]
3dmodels/GT12MSABE.stp
7.01 x 13.0 x 5.56 mm
GT12MSABE_PART2
GT12MSABE_PART1
