dlutz52/lutzcraft-kicad-symbols/3dmodels/ESD5V0D5-TP.stp

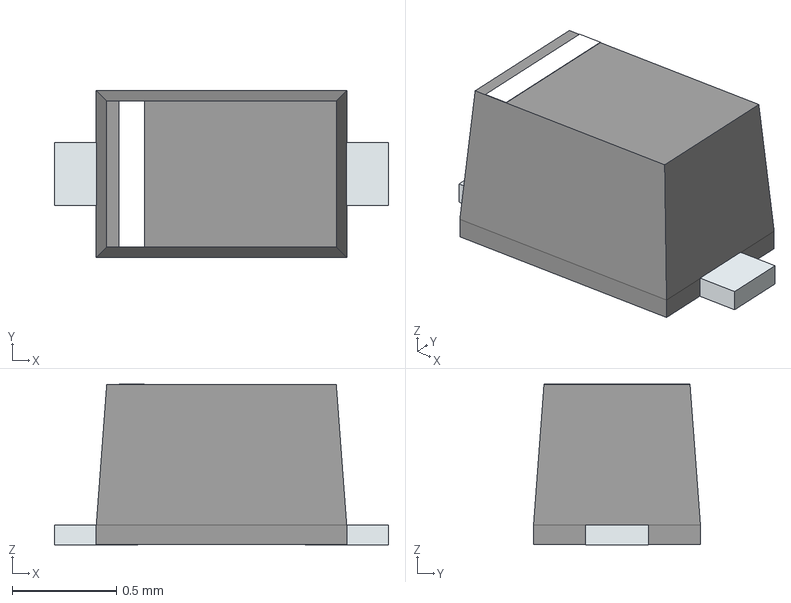
[picture p128: CAD file, 2024-09-09]
3dmodels/ESD5V0D5-TP.stp
1.60 x 0.8 x 0.77 mm
PinKIdent
PinK
PinA
