dlutz52/lutzcraft-kicad-symbols/3dmodels/CCS_CCSTDNOS_1206_L3.4W1.8T1.8B0.75.step

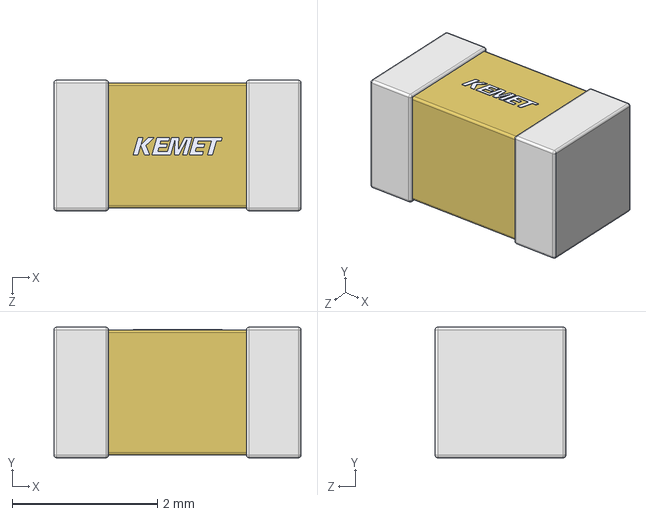
[picture p129: CAD file, 2024-09-09]
3dmodels/CCS_CCSTDNOS_1206_L3.4W1.8T1.8B0.75.step
3.40 x 1.80 x 1.80 mm
