dlutz52/lutzcraft-kicad-symbols/3dmodels/BOURNE-3386P-1-103LF.STEP

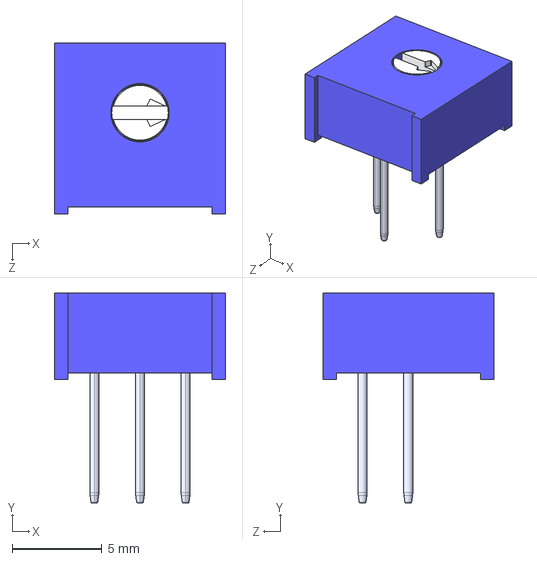
[picture p130: CAD file, 2024-09-09]
3dmodels/BOURNE-3386P-1-103LF.STEP
9.53 x 11.7 x 9.53 mm
