dlutz52/lutzcraft-kicad-symbols/3dmodels/PMST2222A,115.stp

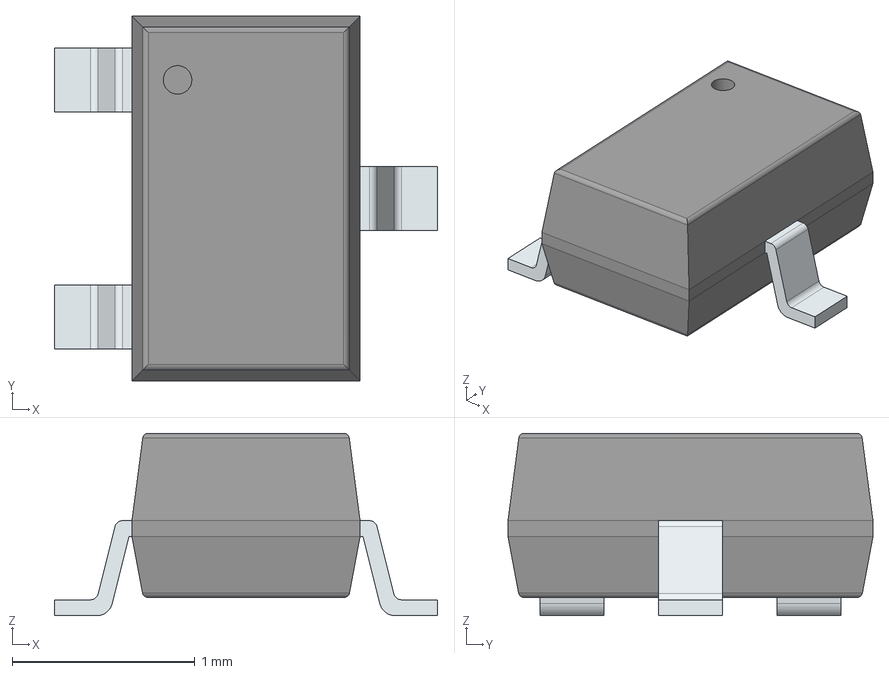
[picture p131: CAD file, 2024-09-09]
3dmodels/PMST2222A,115.stp
2.10 x 2.00 x 1.00 mm
PinsArrayL
FilletPinR
