dlutz52/lutzcraft-kicad-symbols/3dmodels/PBH2UOANAGX.stp

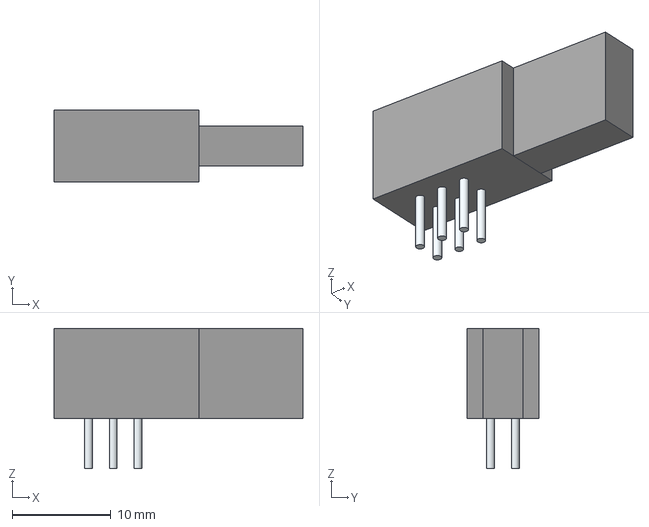
[picture p132: CAD file, 2024-09-09]
3dmodels/PBH2UOANAGX.stp
25.2 x 7.30 x 14.2 mm
Leads x 6
