dlutz52/lutzcraft-kicad-symbols/3dmodels/PTS645SL50SMTR92LFS.stp

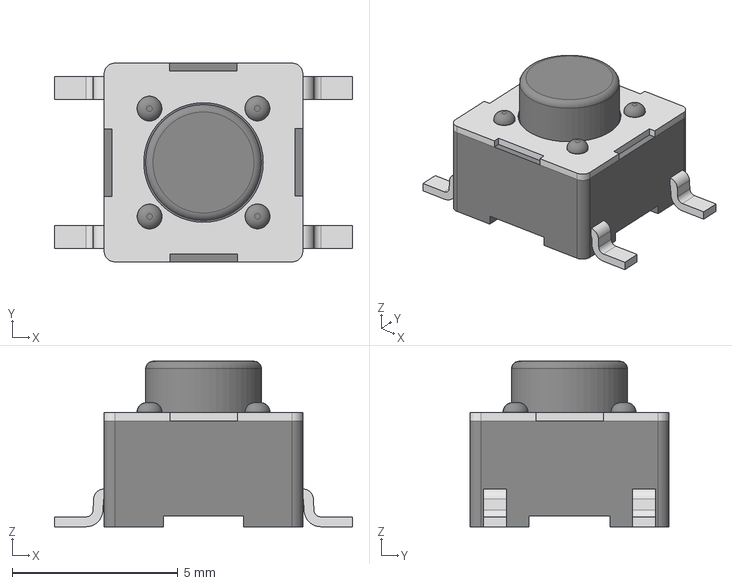
[picture p133: CAD file, 2024-09-09]
3dmodels/PTS645SL50SMTR92LFS.stp
9.00 x 6.00 x 5.00 mm
