dlutz52/lutzcraft-kicad-symbols/3dmodels/Maxim_Electronics_-_MAX98357AETE+T.step

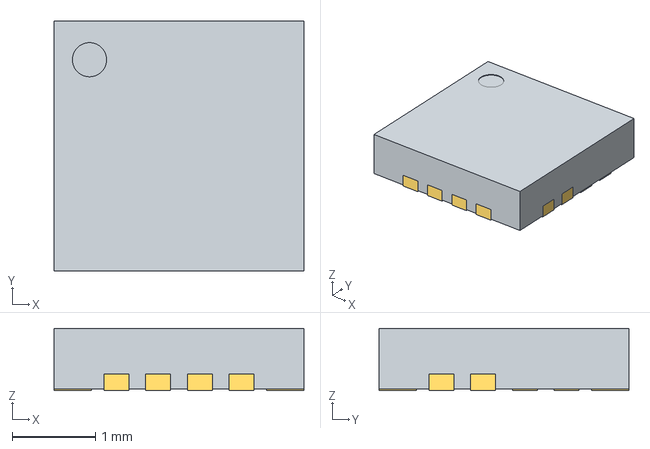
[picture p134: CAD file, 2024-09-09]
3dmodels/Maxim_Electronics_-_MAX98357AETE+T.step
3.00 x 3.00 x 0.75 mm
