dlutz52/lutzcraft-kicad-symbols/3dmodels/LESD5D5.0CT1G.step

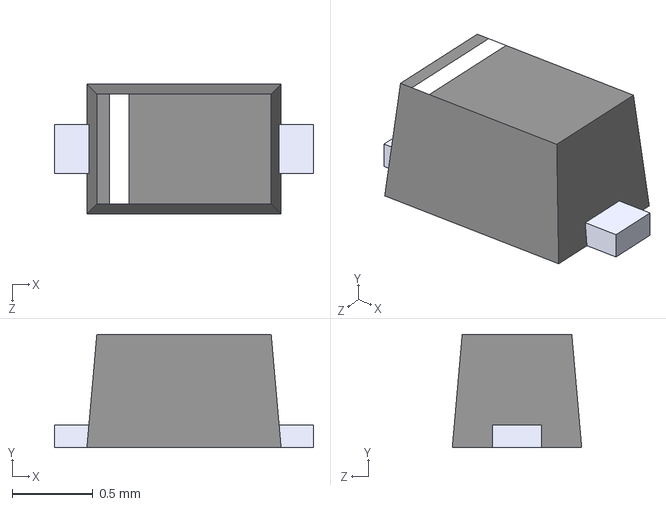
[picture p136: CAD file, 2024-09-09]
3dmodels/LESD5D5.0CT1G.step
1.60 x 0.7 x 0.8 mm
