dlutz52/lutzcraft-kicad-symbols/3dmodels/1TS002G-2700-3500-CT.stp

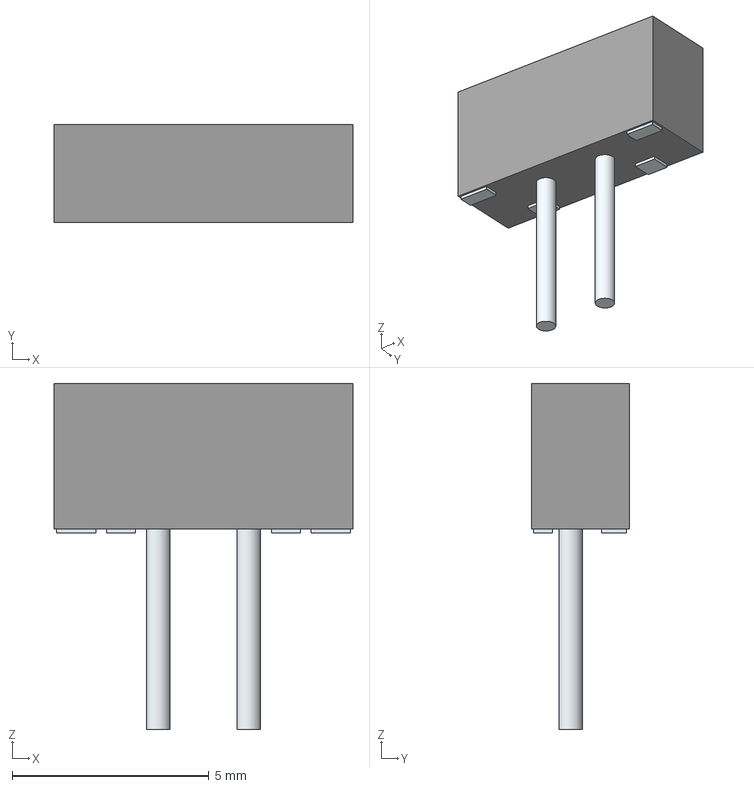
[picture p137: CAD file, 2024-09-09]
3dmodels/1TS002G-2700-3500-CT.stp
7.60 x 2.50 x 8.80 mm
Pins
Leads x 2
