dlutz52/lutzcraft-kicad-symbols/3dmodels/U-F-M5DD-Y-L.stp

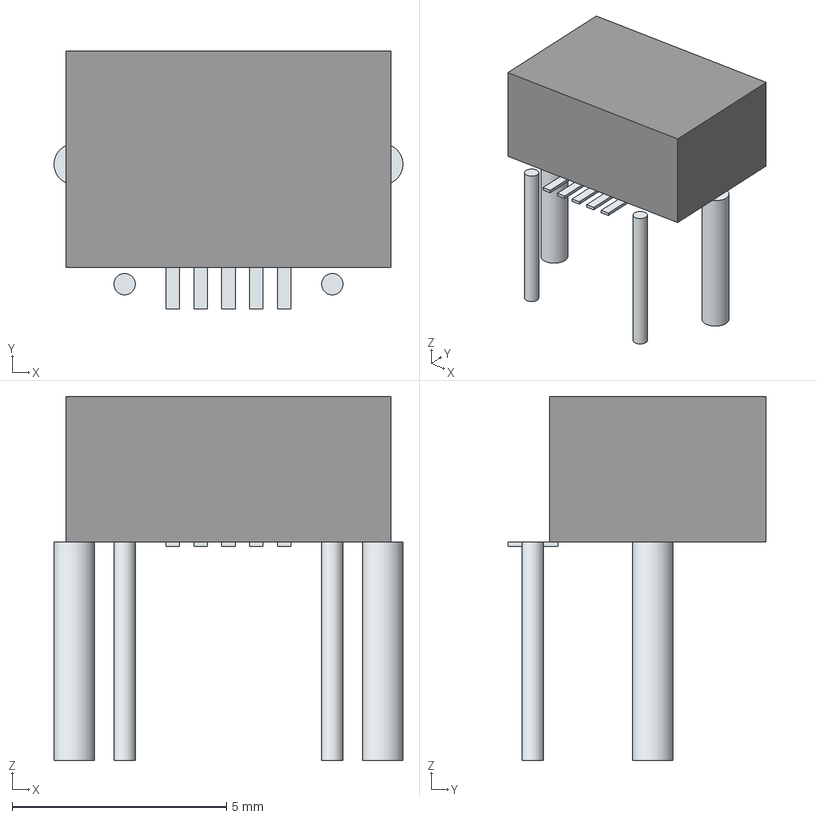
[picture p138: CAD file, 2024-09-09]
3dmodels/U-F-M5DD-Y-L.stp
8.15 x 6.04 x 8.50 mm
Pins
Leads x 4
