dlutz52/lutzcraft-kicad-symbols/3dmodels/B3S-1000P.step

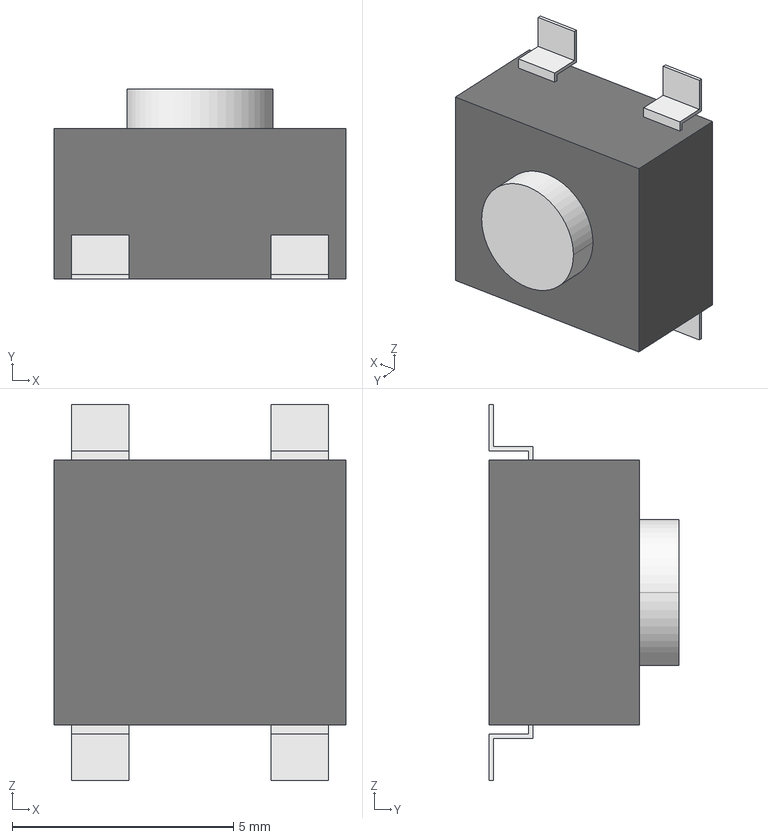
[picture p139: CAD file, 2024-09-09]
3dmodels/B3S-1000P.step
6.60 x 4.30 x 8.50 mm
