dlutz52/lutzcraft-kicad-symbols/3dmodels/SY8003ADFC.stp

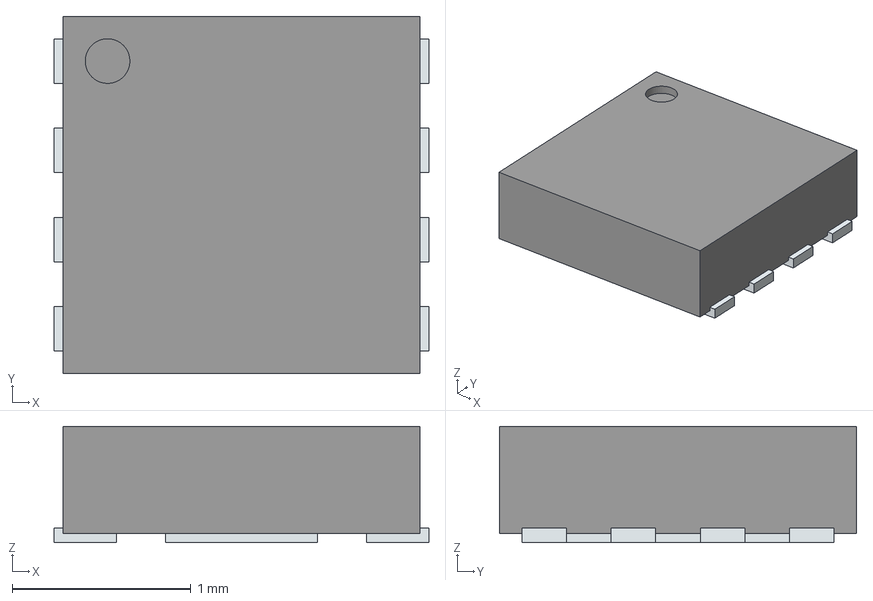
[picture p140: CAD file, 2024-09-09]
3dmodels/SY8003ADFC.stp
2.10 x 2.00 x 0.65 mm
ThermalPin
PinsArrayLR
