dlutz52/lutzcraft-kicad-symbols/3dmodels/mf-fsmf035x.stp

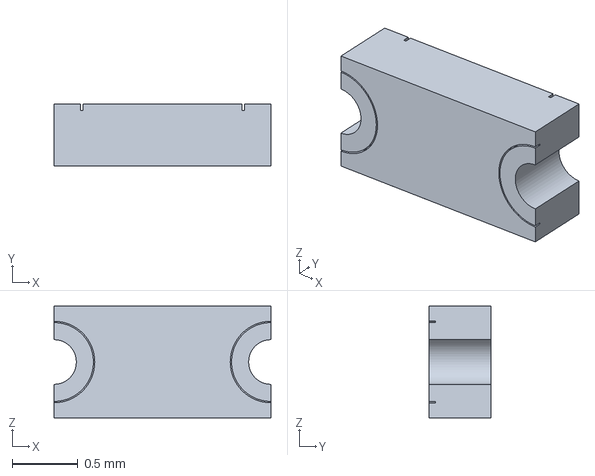
[picture p141: CAD file, 2024-09-09]
3dmodels/mf-fsmf035x.stp
1.65 x 0.475 x 0.85 mm
