dlutz52/lutzcraft-kicad-symbols/3dmodels/Global_Connector_Technology_-_USB4105-GF-A-060.step

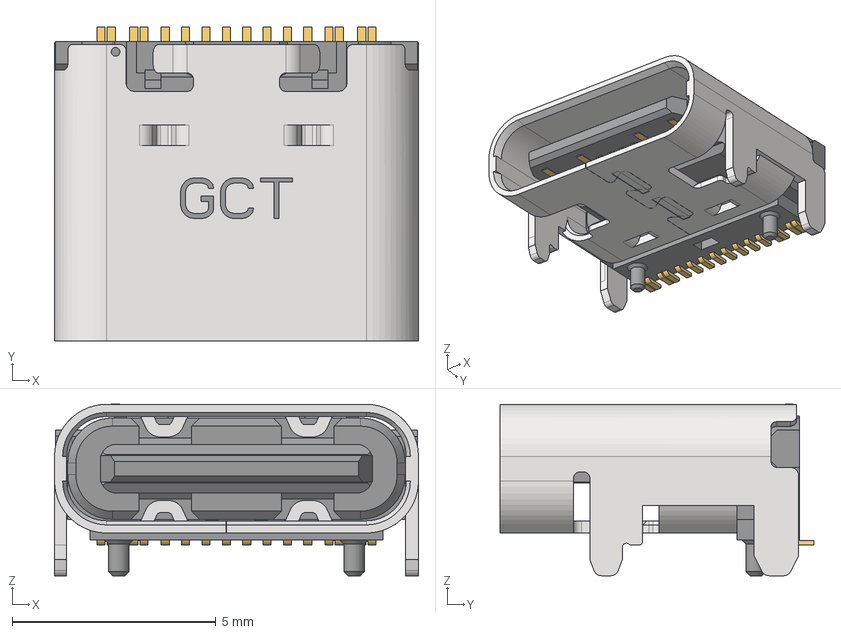
[picture p142: CAD file, 2024-09-09]
3dmodels/Global_Connector_Technology_-_USB4105-GF-A-060.step
8.94 x 7.70 x 4.21 mm
USB4105-GF-A-060_PART2
USB4105-GF-A-060_PART1
USB4105-GF-A-060_PART1_1
USB4105-GF-A-060_PART1_2
logo
