dlutz52/lutzcraft-kicad-symbols/3dmodels/LCD Display 2004.stp

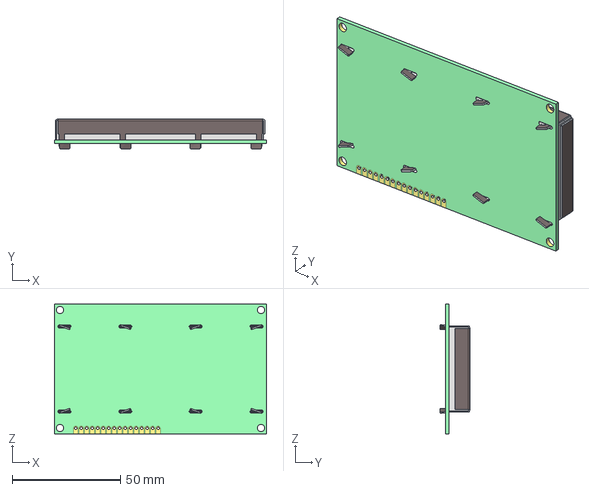
[picture p143: CAD file, 2024-09-09]
3dmodels/LCD Display 2004.stp
98.1 x 13.7 x 59.9 mm
