dlutz52/lutzcraft-kicad-symbols/(list of files, cad)

Other CAD files:
3dmodels/SN74HC32DR.stp
3dmodels/10103594-0001LF--3DModel-STEP-533217.STEP
3dmodels/105017-0001.step
3dmodels/105017-0001.stp
3dmodels/1050170001.step
3dmodels/150060RS75000-WL-SMCW_0603.step
3dmodels/1602 LCD.stp
3dmodels/1825910-6.step
3dmodels/1825967-1.step
3dmodels/1825967-1.stp
3dmodels/228-7396-55-1902.stp
3dmodels/24LC1025-I_SM.stl
3dmodels/24LC1025-I_SM.stp
3dmodels/256-4205-01.stp
3dmodels/3306W-1-105.stp
3dmodels/47590-0001.stp
3dmodels/548190519.stp
3dmodels/629105150521.stp
3dmodels/760301301.stp
3dmodels/831018077.stp
3dmodels/875105359001.stp
3dmodels/ABM8AIG-8.000MHZ-1Z-T.stp
3dmodels/AMS1117-3.3.stp
3dmodels/AO3401A.stl
3dmodels/AO3401A.stp
3dmodels/ATSAMD51J19A-MU.stp
3dmodels/CLG400_XIL.step
3dmodels/CP2102N-A01-GQFN28.stl
3dmodels/CP2102N-A01-GQFN28.stp
3dmodels/CUI_DEVICES_DS02C-254-1L-08BE-Blue.step
3dmodels/DC socket.STEP
3dmodels/DF40HC(3.5)-60DS.stp
3dmodels/DS1337S+.stl
3dmodels/DS1337S+.stp
3dmodels/ECS-160-18-5PX-CKM-TR.STEP
3dmodels/ESP32-D0WD-V3.stl
3dmodels/ESP32-D0WD-V3.stp
3dmodels/ESP32-S3-WROOM-2-N32R8V.stl
3dmodels/ESP32-S3-WROOM-2-N32R8V.stp
3dmodels/ESP32-WROOM-32D.step
3dmodels/ESP32-WROOM-DA-N16.stp
3dmodels/GSD090012SEU.step
3dmodels/HRO_TYPE-C-31-M-12.step
3dmodels/HT7463A.stp
3dmodels/HYC77-TF09-200.stp
3dmodels/ILI9486.stp
3dmodels/IP4220CZ6,125.stp
3dmodels/JS102011SCQN.stp
3dmodels/LCD-20X4B.step
3dmodels/LED_0603-1608_HVK.step
3dmodels/LESD5D5.0CT1G.stp
3dmodels/LFE5U-25F-6BG256C.stp
3dmodels/LM1117MPX-3.3_NOPB.stp
3dmodels/LTA-1000G.stp
3dmodels/MCP23017-E_SO.stp
3dmodels/MCP73871-2CAI_ML.step
3dmodels/MF-FSMF035X-2.stp
3dmodels/MIC2295YD5-TR.stp
3dmodels/Molex 1051330001 [USB B Micro].step
3dmodels/NE555DRG4.stp
3dmodels/NN01-102.stl
3dmodels/NV24C16DTVLT3G.stp
3dmodels/OS102011MS2QN1--3DModel-STEP-1.STEP
3dmodels/OS102011MS2QN1.step
3dmodels/PDIP32_PH_SST_MCH.step
3dmodels/PTS540JM035SMTRLFS.stp
3dmodels/QFN32_5X5MC_MCH.step
3dmodels/QFN64_9x9MC_MCH.step
3dmodels/RECE.20369.001E.01.stp
3dmodels/RP2040--3DModel-STEP-175466.STEP
3dmodels/RS187R05A2DSMTRT.stp
3dmodels/SCL3300-D01-1.stp
3dmodels/SN74HC08DR.step
3dmodels/SOT-23.step
3dmodels/SOT223_AMS1117-5_0_ADS.step
3dmodels/SOT323_NEX.step
3dmodels/SP0503BAHTG.stp
3dmodels/SS12D02.stp
3dmodels/STM32F405RGT6.stp
3dmodels/STM32F407ZGT6.stp
3dmodels/TEENSY_4.0.stp
3dmodels/TEENSY_4.1.stp
3dmodels/TL2230EEF140.step
3dmodels/TL2230EEF140.stp
3dmodels/TLV76733DRVR.step
3dmodels/UJC-HP-3-SMT-TR.step
3dmodels/USB4105-GF-A.step
3dmodels/USB4105-GF-A.stp
3dmodels/X50328MSB2GI.stp
3dmodels/XC6210B332MR-G.stp
3dmodels/XC7Z010-1CLG400I.stp
3dmodels/XLH536025.000000I.STEP
3dmodels/Z84C1510FEG_xFSG.stp
3dmodels/Z8S18020FEG.stl
3dmodels/flexypin.step
3dmodels/tact_switch_2.5mm.stp
