dlutz52/lutzcraft-kicad-symbols/design-blocks/RotaryEncoders.kicad_blocks/PEC11R-4215F-S0024 Debounced.kicad_block/PEC11R-4215F-S0024 Debounced.kicad_pcb

## KiCad design design-blocks/RotaryEncoders.kicad_blocks/PEC11R-4215F-S0024 Debounced.kicad_block/PEC11R-4215F-S0024 Debounced.kicad_pcb (2026-05-27)

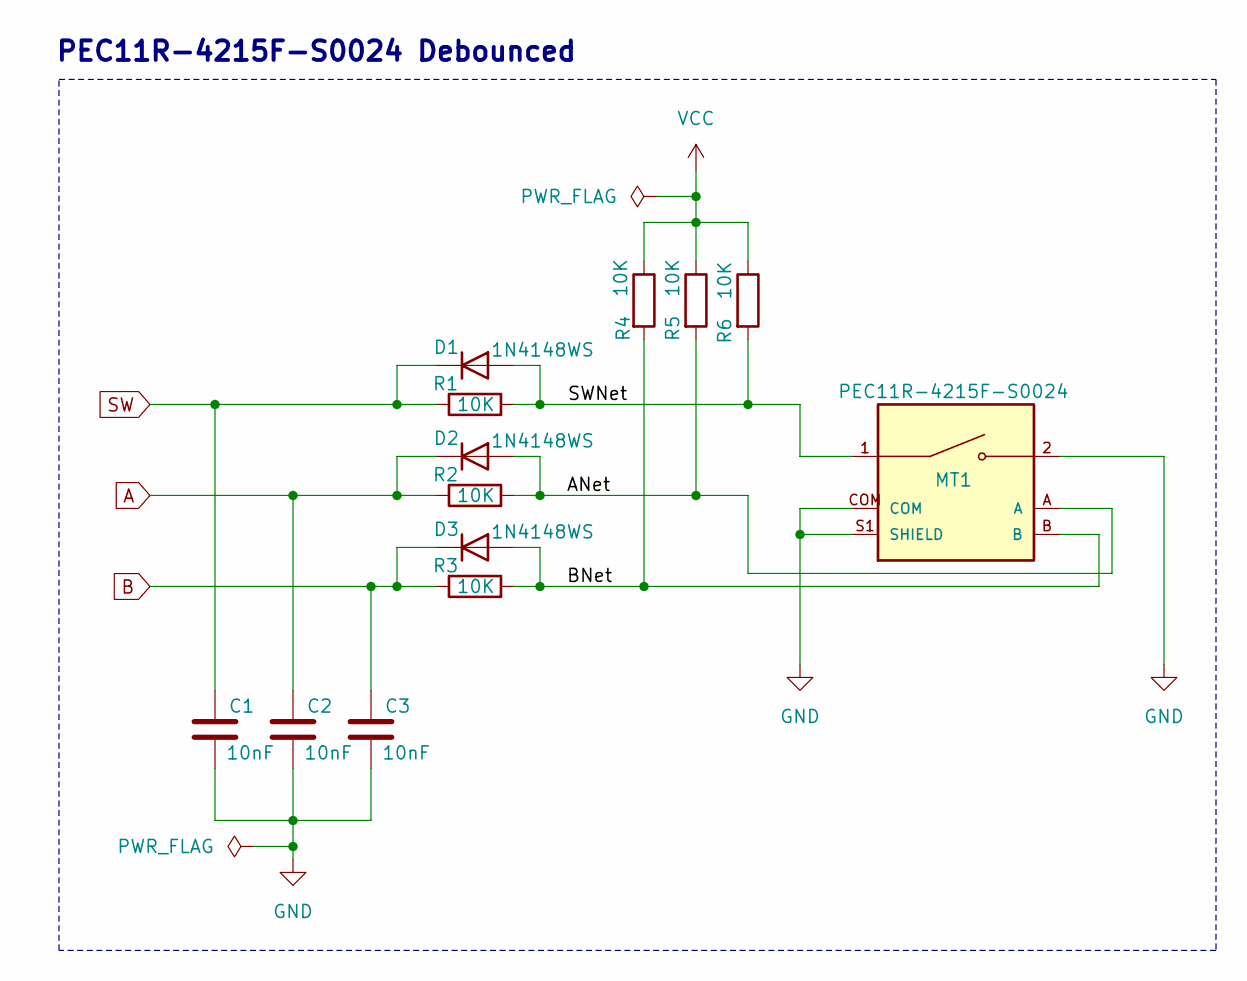
[picture p144: schematic PEC11R-4215F-S0024 Debounced.kicad_sch]

Parts:
C1, C2, C3: 10nF; C_0805_2012Metric_Pad1.18x1.45mm_HandSolder
D1, D2, D3: 1N4148WS; D_0805_2012Metric_Pad1.15x1.40mm_HandSolder
MT1: PEC11R-4215F-S0024; XDCR_PEC11R-4215F-S0024; PARTREV Rev. 09/19; DigikeyPN PEC11R-4015F-S0024-ND
R1, R2, R3, R4, R5, R6: 10K; R_0805_2012Metric_Pad1.20x1.40mm_HandSolder

Connections:
/ANet: D2.2 (A), MT1.A, R2.2, R5.2
/BNet: D3.2 (A), MT1.B, R3.2, R4.2
/SWNet: D1.2 (A), MT1.1, R1.2, R6.2
A: C2.1, D2.1 (K), R2.1; also elsewhere on the board
B: C3.1, D3.1 (K), R3.1; also elsewhere on the board
GND: C1.2, C2.2, C3.2, MT1.2, MT1.COM, MT1.S1 (SHIELD), MT1.S2 (SHIELD); also elsewhere on the board
SW: C1.1, D1.1 (K), R1.1; also elsewhere on the board
VCC: R4.1, R5.1, R6.1; also elsewhere on the board

Notes on the sheet:
PEC11R-4215F-S0024 Debounced

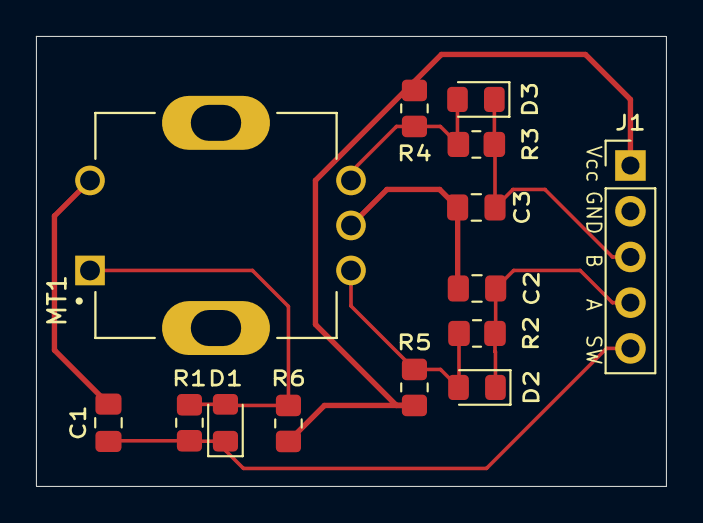
[picture p145: board PEC11R-4215F-S0024 Debounced.kicad_pcb from above]

Board: 2 copper layers, 35.0 x 25.0 mm, 14 parts (0 on the bottom side), 8 nets.

Other parts of the board:
J1: Conn_01x05_Pin; PinHeader_1x05_P2.54mm_Vertical

Their connections:
A: J1.4; also elsewhere on the board
B: J1.3; also elsewhere on the board
GND: J1.2; also elsewhere on the board
SW: J1.5; also elsewhere on the board
VCC: J1.1; also elsewhere on the board
