dlutz52/lutzcraft-kicad-symbols/(commit log)

2024-09-09 Recreating this repository as the previous does not appear to exist or leat not with this account.
    [10103594-0001LF--3DModel-STEP-533217.STEP, 105017-0001.step, 105017-0001.stp, 1050170001.step, 1062.stp, 1602 LCD.stp, 1825910-6-c-tactile_switch-3d.stp, 1825910-6.step]
2024-09-09 Updated mouse-bite-1mm-slot.kicad_mod.
2024-10-07 Changes after adding SMD components for HardwareAcademy custom-esp32-pcb project.
    [150060RS75000-WL-SMCW_0603.step, 21-0042B_16_MXM.step, D3V3XA4B10LP-7.stp, ENS210-LQFM.step, ESD7104MUTAG.step, ESP32-S3-MINI-1-N8.step, ESP32-S3-WROOM-2-N32R8V.step, PTS810 SJK 250 SMTR LFS--3DModel-STEP-56544.STEP]
2024-10-22 Added more symbols/footprints/3D models
    [AZ1117CR2.step, CP2102N-A02-GQFN28.step, DS3231SN_.step, DS3234S.step, FTR-102-02-S-S.step, FeatherS3.STEP, PinHeader_1x12_P2.54mm_Vertical.step, PinHeader_1x16_P2.54mm_Vertical.step]
2024-10-31 Added 831018077 oscillator and AT45DB081E/AT45DB161E flash chips
    [831018077.stp, AT45DB081E-SSHNHC-T.step, AT45DB161E-SHD-T.step, AT45DB161E-SHF-B.step]
2025-05-11 Updating remote repo with local changes.
    [DG306-5.0-02P-12-00AH.STEP, DG306-5.0-03P-12-00AH.STEP, DG306-5.0-05P-12-00AH.STEP, ESP32-S3-DEVKITC-1-N8R2--3DModel-STEP-56544.STEP, LQFP64-10x10mm.step, SSOP-28_FTD.step, STM32F030R8T6.step]
2025-07-09 Adding latest additions and changes.
    [0ZCH0110AF2E.stp, 35WR100KLFTR.stp, B2B-PH-SM4-TB.step, B4B-XH-AM__LF__SN_.step, BME280.step, CP2102N-A02-GQFN20.STEP, ESP32-C3-WROOM-02-H4.step, FBMJ2125HM330-T.step]
2025-10-08 Added symbol/footprint/3d-model for 3 pos dip switch. 208-3.STEP is not used.
    [208-3.STEP, User Library-DS1040-03 (DIP_switch).STEP]
2025-10-18 Added 'TB002-500-02BE', a three position dip switch.
    [TB002-500-02BE.step]
2025-10-31 Replaced all instances if '${LUTZCRAFT_LIBS}/3dmodels/' in kicad_mod files with '${LUTZCRAFT_3DMODELS_DIR}/'.
2025-10-31 Add IMUs from Digikey Order #95464517.
    [BGA9_BMM350_BOS.step, BMI088.STEP, BMI270.STEP, BMI270_BOS.step, BNO085.step, ICM-20948.step, LGA20_2p5X3X0p95_BOS.step, QFN24_3X3X0P9_IVS.step]
2025-11-05 Added IST8310 IMU symbols, footprint and 3D model.
    [IST8310.step]
2025-12-26 Checking in recent changes.
    [TB002-500-03BE.step]
2026-01-23 Added STM32F407ZG and corrected many path errors.
    [STM32F407ZGT6.stp]
2026-01-31 Additions during D:\KiCad\projects\_dtl\stm32-dream-project\stm32h407-disco-proto project.
    [8M20P2_49US.stp, ABM8AIG-8.000MHZ-1Z-T.step, ABM8AIG-8.000MHZ-1Z-T.stp, DM3AT-SF-PEJM5.STEP, IS62WV51216BLL-55TLI_ISI.step, NRF24L01.step, PinSocket_2x04_P2.54mm_Vertical.step, S8411-45R.step]
2026-02-02 Made several changes to ESP32 3D models.
    [ESP32-WROOM-32E.STEP, ESP32-WROOM-32U.step, ESP32-WROOM-32UE.STEP, ESP32-WROOM-DA-N16.stl]
2026-05-27 Added design-blocks and various symbols/footprints/models.
    [PEC11R-4215F-S0024 Debounced.kicad_sch, SRP4020TA-3R3M.step, U262-161N-4BVC11.stp, pec11r-4x15k-sxxxx.stp]
2026-05-27 Added net labels, PCB (with new pin header labels) and project folders for lib/sim and lib/fp (including lib/3d).
    [PEC11R-4215F-S0024 Debounced.kicad_pcb, PEC11R-4215F-S0024 Debounced.kicad_sch]
